fredshuc/buildfly/dampers/c06-d02/README_CN.md

# D02 风阀承重整改 · C06 / RT2 N8

**结论**　八阀的自重均有从内、外金属端法兰通往机架的承托路径。32 个接触点和四座门架的底架连接已在回读的 STEP 上核对。N8 可进入原型详设，实物反力和 2.5 mm 箱壁法兰的挠度仍待测。整机下料与双床制造继续暂缓。

风阀支承与底架连接

## 用哪份 CAD

| 用途 | 文件与操作 |
| --- | --- |
| 单独审查受力路径 | 打开 [D02_LOAD_PATH_REVIEW.step](cad/D02_LOAD_PATH_REVIEW.step)。231 个具名实体包含 149 件 D02 支承、16 个 D01 金属端框、16 个阀端垫片、8 个接框及 42 件 C06 参考结构。底板和 2.5 mm 箱壁法兰可在独立参考组中隐藏。 |
| 放入 C06 整机 | 在装配配置中抑制 [表内的 16 个旧支垫](evidence/D02_C06_PADS_TO_SUPPRESS.csv)，保留原门架腿、脚和横档。将 [D02_DAMPER_SUPPORTS.step](cad/D02_DAMPER_SUPPORTS.step) 以单位 mm、原点重合导入一次。D01 装机 STEP 继续抑制其旧 HOST 参考组。 |
| 追查单个接触点 | [承托点坐标和接触面积](evidence/D02_BEARING_POINTS.csv) 给出阀号、内外端、支座及金属端框的配对。LO / HI 对应全局 Y 小 / 大的一侧。沿 [接触表](evidence/D02_LOAD_PATH_CONTACTS.csv) 可逐项追到机架。 |

适用基线为 C06 与 D01，仓库提交 `d2c9a6839a5842f1b6ee0b1fcb67e70b25738838`。两个评审分支的 RT2 正文 Git blob 相同。此次在风阀目录下交付支承增量与壳体装配接口，机壳、换热器和水路各自保留原发布版本。[RT2 §3 N8 与 N10](https://github.com/fredshuc/buildfly/blob/claude/dampers-cad-dfm-bgxyci/AirTransformerShell/revisions/C06/RT2_REVIEW/C06_RT2_REVIEW.md) · [来源标识](source/baselines.json)

## 八阀怎样承重

原 C06 每个旧垫在外端金属法兰上的接触面积为 60 mm²，在内端为 0。D02 在每阀两道金属端法兰的下缘各设两个承托块。受力依次经承托块、横梁、左右侧梁，进入原门架和新增立柱。各阀保留 D01 的风道、1280 mm 床距和手性。

| 装配尺寸 | D02 名义值 |
| --- | --- |
| 前组承托中心 X | 箱侧 −167.6，外侧 −344.6 mm |
| 后组承托中心 X | 箱侧 917.6，外侧 1094.6 mm |
| 承托中心 Y、Z | 每床中心 Y ±300 mm。P 阀 Z 152，R 阀 Z 627 mm |
| 单点贴合 | 2 × 60 mm 凸台落在 3 mm 厚的 P101 / R101 金属下缘。每阀四点共 480 mm²，凸台至相邻密封垫名义最小间距 0.5 mm |
| 高度与定位 | 承托块肩部低于名义落座面 2 mm。凸台高度可配磨至 1.6–2.4 mm，可按实测法兰中心在块上横移加工 ±1.5 mm。最终使凸台中心相对金属中面偏差 ≤0.25 mm。超出加工余量须重定位支架。 |

**前门架。** 每座前门架增加两根 40 × 50 × 3 mm 纵向矩形管。它们从原门架腿的 X −393 面接至 C06 底架 X −129.1 面。靠箱侧的两根立柱也落在这两根拉梁上。两床共四根拉梁，把原先单独落地的前门架接回底架。

**后门架。** 箱侧新增支脚位于已有的 `R_BASE_CROSS_327` 或相邻底架侧梁上方；外侧原门架位于 `REAR_STAND_BASE_CROSS` 上方。逐脚投影核对了整段柱截面经脚板、2 mm 底板传到底架的承压面积。另以四根短拉梁接至两根后角柱之间的横管，位置在排风套筒下方。此连接可在原底板完整的条件下装入。

**接头与装配。** 接触表中带 `WELD` 的面和立柱脚是装配连接界面，名义模型用母材贴合面表示。承托块由每块两颗沉孔 M4 × 12 螺钉防脱，竖向力通过块底直接传给 20 × 32 mm 实心横梁。先在工装上完成支架与底架的焊接和焊后找正，再安装蒙皮、密封件、承托块及阀体。前侧近箱立柱须在封皮前施焊。壳体负责人需会签母材、焊缝尺寸与顺序、底架承载和吊运约束。按统一钢密度估算，换下旧垫后整机净增 **87.81 kg**。[局部梁估算](evidence/D02_MEMBER_SCREEN.json)

## 检查结果与边界

| 检查 | 结果 |
| --- | --- |
| STEP 回读 | 增量 149 件、审查装配 231 件。逐件核对名称、单实体有效性、体积及位置包围盒。 |
| 静态装机 | 用整机原点下的 7,212 个 D01 产品与接口实例、311 个保留的 C06 实体、43 个水路实体和 12 个水路检修包络检查新增件。新增件内部及对上述对象的实体干涉均为 0，体积阈值 0.001 mm³。 |
| 运动和工具 | 600 个逐件连续整周运动包络、8 个执行器预留体、8 个单盖抽出包络与新增件通过。240 个 M8 套筒路径中有 24 对包围盒与新增件相交，精确实体检查全部通过。 |
| N10 侧板 | 全部新增件位于 A、B 侧板内表面向内至少 21.6、50.0 mm，原侧板向外平移时与新增支承的距离递增。支承最高 Z 627，比建议分板线 Z 1000 低 373 mm。按原 C06 整板检修时，该床后侧 P、R 两个执行器仍须先拆，再沿驱动轴方向向外移板约 464 mm。分板与实机演练由壳体负责人闭合。 |

统一钢密度下，D01 阀体及已建模传动件的质量代理为 P 99.89 kg、R 56.00 kg。简支静力平衡给出箱侧两个点合计承担 **49.3%–50.7%** 阀重；四个点各自的反力须实测。若未来执行器的重心可能落在预留体任一角落，并要求组合重心与四点支承矩形的边保留 15 mm，以这些代理质量换算的执行器质量边界为 P 16.31 kg、R 12.61 kg。选型时须用实秤质量、实际重心和外接负载重算，必要时给执行器单设底架支承。[重心与反力计算](evidence/D02_GRAVITY_SCREEN.json)

另做了每根梁施加 1 kN 的简支弹性估算，取钢材弹性模量 200 GPa。将载荷移至 60 mm 凸台的最内缘，横梁承托区挠度上界约 0.178 mm/kN，前、后侧梁跨内上界约 0.041、0.095 mm/kN。该计算只覆盖单根梁。2.5 mm 箱壁法兰的实际位移、焊接接头刚度、薄边局部压屈及热态配合都要在实物上核实。[几何结果](evidence/D02_GEOMETRY_RESULT.json) · [干涉记录](evidence/D02_CLASH_CHECKS.json)

## N8 实物验收

1. 独立称量每台阀连同实际执行器和随阀附件，记录重心。断开外风管、线缆牵引及试验软连接的附加载荷。安装时用外部吊具控载，让四块承托先贴住金属下缘。定位后逐点做着色转印、量凸台偏移，确认垫片与托块有间隙、焊钉在 Ø9 孔内有径向余量。
2. 在每根横梁两端各布置一条应变测量通道。合盖前在实际工装上分别加载两处承托点，并用组合载荷核对两通道解出的两点反力。也可使用校准且保持装配高度的测力承托块。百分表固定在独立刚性基准上，分别读 2.5 mm 法兰四角的 Z 位移和 X 向面外位移，仪表分辨率 0.01 mm。
3. 分三步记录。① 密封螺母松弛、吊具卸载，确认四点反力；② 按批准工艺紧固气密接头，复测；③ 保持同一预紧力，以测力吊具回提约 10% 实秤重量并复位，保持四点接触，复测力与位移。这样可以区分密封预紧自身引起的面外变形和重力变化引起的法兰挠度。
4. **提议的原型判据，待试验负责人认可。** 在①、②两态，各点反力均应超过测量不确定度，反力合计与实秤重量相差 ≤5%。在③的控载步，反力合计变化应与吊具增载在测量不确定度内一致；相同预紧下法兰任一测点的位移变化 ≤0.10 mm，卸载后复位。记录仪器、温度、实际扭矩和原始数据，异常时重新配高、找正并重测。[空白试验记录](evidence/D02_N8_FIELD_RECORD.csv)

**待关闭项。** N8 的几何证据已提交，载荷、法兰挠度、焊接和底架锚固仍待实证。床 B 镜像手性、实选执行器和输出连接、G843 夹紧与预载，以及 R21 阀内膜片和转子约束继续沿用 D01 门槛。整机下料、双床制造与单床冷流开试由各自评审门槛决定。

## 复现

把两份上游包分别解到仓库的 `dampers/c04-d01/` 和 `AirTransformerShell/revisions/C06/`，把上游 ZIP 原件也留在对应目录。将本包解至 `dampers/c06-d02/`。运行 `run.ps1`，或在可导入 CadQuery 2.8.0、OCP 7.9.3、NumPy 和 Matplotlib 的 Python 环境中依次执行 `source/verify_fit.py`、`source/detail.py`、`source/package.py`。每次核对上游 ZIP 的 Git blob 和所用输入的 SHA-256。首次解析 STEP 会产生可丢弃的本地缓存。[D01 原始包](https://github.com/fredshuc/buildfly/blob/d2c9a6839a5842f1b6ee0b1fcb67e70b25738838/dampers/c04-d01/D01_CAD_REVIEW_PACKAGE.zip) · [C06 原始包](https://github.com/fredshuc/buildfly/blob/d2c9a6839a5842f1b6ee0b1fcb67e70b25738838/AirTransformerShell/revisions/C06/C06_CAD_REVIEW_PACKAGE.zip)
