fredshuc/buildfly/dampers/c04-d01/README_CN.md

# L2-MI dampers2｜C04 风阀 D01 几何整改候选

日期：2026-11-05。状态：**PASS_INTERFACE_GEOMETRY；不作为制造放行或试验运行许可。**

布置与检修包络

本版保留 R21 的阀芯、180 mm 阀体深度、P 630×345 / R 630×180 净口及原 706 mm 法兰孔阵列。原 C04、R21 文件未改写。
主要调整是装机手性、真实驱动占位和外接紧固。每个接口增加33 mm金属接框及2 mm主垫，使风阀移出35 mm；接框的局部让位槽避开反馈支脚，未削减阀芯和反馈零件。后侧四根套管按真实两端垫及接框相应缩短39 mm。
旧C02 R100S的R112/R113共四个20 mm抬高段源实例，由新密封接框替代，不再叠加装入本机；[替换记录](evidence/D01_RETIRED_MACHINE_INTERFACES.json)保留来源。未撤销旧批次或指示报废库存。
为得到可检查的双床候选，提出 **1280 mm 床距**（原840增加440）；这是一项提交给 shell2 的接口要求，尚未纳入其正式壳体版本。
床A保持原位，床B整体沿+Y移440 mm。参考主壳体Y范围由−852…+852改为−852…+1292 mm，宽2144 mm，驱动及执行器外伸另计。明确的壳体接入项见 [接口请求表](tables/D01_HOST_INTERFACE_REQUEST.csv)。
床 B 使用标识为 D01_MH 的真正镜像派生几何，不能拿原件旋转180°替代。左右手间重力及气流/压差方向相同；新右手件的制造和性能资格仍待建立。

## CAD 与可编辑数据

- [八阀装机 STEP](cad/D01_EIGHT_DAMPERS_INSTALLED.step)：原生风阀组件、候选加宽参考壳体、实际驱动及新焊钉；所有八个位置均有独立名称。
- [床 A 风阀接口 STEP](cad/D01_BED_A_DAMPER_INTERFACES.step)：四只原手性阀，不含床 B 派生件；**没有独立支架，不是可直接建造的冷流试验总装**。
- [连续运动/执行器/反馈拆卸空间 STEP](cad/D01_SERVICE_ENVELOPES.step)：参考空间，不是实物和采购件。
- [装配变换](native/D01_PLACEMENTS.json)、[侧板开孔](native/D01_PANEL_CUTOUTS.json)、[参数](design.json)、[重建代码](source/build.py)。修改参数后重建，不从截图量尺寸。
- `native/*_D01_ADAPTER.brep`使用装机全局坐标；加工须另建基准、出让位口袋图并审批，不能直接把文件原点当作下料零点。
- [法兰与焊钉接口图](drawings/D01_FLANGE_STUD_INTERFACE.svg)、[逐孔坐标](tables/D01_M8_STUD_COORDINATES.csv)、[整改闭环表](tables/D01_REVIEW_CLOSEOUT.csv)。

## 几何核查范围

1. 在原840 mm床距上，以真实零件再次得到四组同层 A/B 硬干涉，前后 P/R 均有失败记录；没有把空的占位块检查当作通过。
2. 候选八阀的28种两两组合，逐件连续运动包络互不相交。以源件包围盒绕实际轴的最大角点半径建立全360°外包络，因此包含0–90°的所有中间角度；该证明只针对外部接口，不证明原阀内部运动合格。
3. 与候选参考壳体的静态实体干涉、连续运动外包络干涉、新接框/焊钉/垫片实体、Ø20×25短套筒沿Z侧向50 mm进入（顶/底排从边外，侧排沿法兰边从内侧；含Ø22×10棘轮头及100 mm沿边手柄）、单只反馈盖沿轴100 mm拔出及执行器选型空间分别检查，原始结果见 [D01_INTERFACE_CHECKS.json](evidence/D01_INTERFACE_CHECKS.json)。反馈盖不得同时向中间拔出。工具尺寸是选型限界，需要实物工具及人手试装；不是供应商供货声明。
4. 当前参考 CAD 通过不代表原 C04 整机通过。加宽后的框架只是接口参照；支撑、刚度、密封、排水、水路和风道流场均未在本版关闭。
5. STEP独立重新导入：D01_EIGHT_DAMPERS_INSTALLED.step = 7380 个有效实体; D01_BED_A_DAMPER_INTERFACES.step = 3679 个有效实体。未运行CFD、FE或任何物理试验。

新增接口的连续运动复核另由导出AP242重新读取全部976个新接口实例，逐件对照运动包络；B200在两条净口边沿轴向分段，避免把阀叶弦长错误地延伸到外侧细轴段。[独立复核结果](evidence/D01_NEW_INTERFACES_CONTINUOUS_MOTION.json)只证明外部连续几何间隙，不替代载荷、捕获、密封或内部接触验证。

## 组件归属与紧固修改

R21是含试验设施的冷装配，不是纯产品装配。本版排除源标识的试验台、仪表、原接收框，并用1 mm实体距离、四轮连接传播识别随产品的通用紧固件；其余未能关联的硬件不计入装机，共排除713条源记录。
这是**几何集成范围推断，不是制造BOM或采购数量依据**；每个源 occurrence 的取舍及关联父件均在 [组件范围表](evidence/R21_COMPONENT_SCOPE.json)。采购图和正式装配分配仍需归属负责人确认。
源外接螺栓/螺母/垫圈共304条记录改由新接口定义，[替换清单](evidence/OUTER_FLANGE_HARDWARE_REPLACEMENTS.json)逐件可查。
其中含R阀五处改过料号的HW_R12_M8X40；这些孔位改用新焊钉后，G843的新夹紧、支承及预紧链仍须单独详设。本版只保留其空间实体，不把它记作已完成的反馈承重连接。

本版八阀到壳体接口共240根M8焊钉。有效外露55 mm，穿过主垫2、金属接框33、阀垫2、阀法兰3、垫圈1.6及螺母6.5，名义螺纹外露6.9 mm；实际有效牙长及端倒角需实物检查。新主垫逐孔设2 mm金属压缩限位；源阀垫原有限位保留。让位槽未侵入两端面距净口20 mm的原密封带（原螺栓孔及压缩限位不变），内侧气路边壁保持至少2 mm，实际值见 [接框让位](native/D01_ADAPTER_POCKETS.json)。G843仍是原版暂缓件，仅保留其实体占位，不取得承重资格。接框仅定义气密安装接口，不承担未验证的整阀重量。
R21 R阀原来只有一端外接垫，本版复制同一R106压缩态轮廓用于第二端面，标识D01_R106_SECOND_FACE；软料自由厚度及压缩限位沿用来源要求，不能按压缩态CAD直接切自由料。
薄2.5 mm母板上的焊钉必须做焊接试片及焊后平面度/夹紧压缩检查。外接风管另一端的紧固及支承另行定义；本表不是全机紧固件总量。

## 仍须闭合的条件

- shell2确认1280 mm接口；840 mm不能靠左右旋转或交换端头通过。本版没有擅自覆盖C04。
- D01_MH右手件需单独出图及冷热/湿态/压差密封、反馈、驱动和购件安装确认；R21原签发页不能自动覆盖镜像件。
- 左右手的编码器零点、反馈正方向和开关限位分别标定，不能直接复制控制极性。G843及其五处夹紧的承载定义继续HOLD。
- 实选执行器、输入适配器、动态扭矩限制和拆卸服务空间仍待确认；250 mm方盒只是明确的选型限界。
- 每只风阀及选通箱需独立支架。**不能把阀重交给2.5 mm法兰。** S1承重链、原R21膜片/捕获/柔度问题继续HOLD。
- 红队其余 S2–S8、W1–W5、A1–A3 仍由相应负责人处理；冷流C1–C8尚未全部实现。再生模式优先试验，沿用红队G0/G1门槛。
- [先关后开状态表](tables/D01_BREAK_BEFORE_MAKE.csv)已写；执行器实测行程时间、失效位、PLC实现、独立位置确认和水路联锁尚待集成。

## 复现

Python3.12 + CadQuery2.8.0 / OCP7.9.3.1.1、NumPy2.3.5、SciPy1.18.1、Matplotlib。本机可运行 `run.ps1`；其他环境安装依赖后依次运行 `source/build.py`、`source/check_motion_interfaces.py`、`source/verify.py`、`source/document.py`，最后运行 `source/verify.py --package`（均使用 `python -X utf8`）。
`inputs/C04_R21_BASELINES.zip`含21份未改动基线。重建只向本版`.work/`及输出目录写入，不运行旧版制造/打包脚本，不覆盖源交付。
`inputs/BASELINE_MANIFEST.json`逐件记录来源路径和SHA256；源审查来自 fredshuc/buildfly 的 claude/jolly-hopper-mndk80 分支，审查基线cb6c2b5，完整审查随包保留。
