fredshuc/buildfly/AirTransformerShell/references/four-core-outdoor/README.md

# Four-core outdoor sheet-metal reference

Use this historical AP242 export to compare the four-core outdoor enclosure, panels, ducts, dampers, HX masks and sheet supports with the two-core design. The source package records its status as `PARTIAL_WITH_VALID_STEP / NOT_FOR_MANUFACTURE`. Keep the two-core C07 acceptance criteria separate.

Original file: `V050_SM_M2_IN1_R1_OUTDOOR_SHEET_METAL_ONLY.stp` (26,113,041 bytes). SHA-256: `d20fbdc7a29cf05dad60b861e0eac5a06509d531450b63370dea08928586f6ae`.

Export date: 2026-10-08. Parent: `V050_SM_M2_IN1_R1_SOR_CANDIDATE.step` (SHA-256 `1876d5f244933f145d9a5f1e9adaafca5ed9a168663eca60e45121cb4b0fc53a`). The original exporter's readback recorded 521 occurrences in 11 groups, an exact occurrence-name match and a maximum bounding-box discrepancy of 0.000286 mm. The export excludes HX cores, water routing, insulation, gaskets, electrical hardware and fasteners.
