fredshuc/buildfly/mat-prod/RED_TEAM_REVIEW_EN.md

# MAT61 Red Team Review Brief

7 November 2026  
HORIZON-CL4-2027-01-MAT-PROD-61  
Working draft for red-team review

Please review Sections 1–3 as one Part B proposal. Read S1 for the scientific claim and proof strategy, S2 for the pathway from results to impact, and S3 for work, resources and partner responsibilities. Use the Word files for comments and the Markdown sources for precise change references.

| Section | Editable Word | Markdown source |
| --- | --- | --- | --- |
| S1 Excellence | [Word](01_proposal/Section1_Excellence_Science_Longform_EN.docx) | [Markdown](01_proposal/Section1_Excellence_Science_Longform_EN.md) |
| S2 Impact | [Word](01_proposal/Section2_Impact_EN.docx) | [Markdown](01_proposal/Section2_Impact_EN.md) |
| S3 Implementation | [Word](01_proposal/Section3_Implementation_EN.docx) | [Markdown](01_proposal/Section3_Implementation_EN.md) |

Supporting files include the [resource workbook](03_budget/Implementation_Resources.xlsx), [validation protocol](04_evidence/Validation_Protocol_Design_EN.md), [planned validation matrix](03_budget/CSV/Validation_Matrix.csv) and [S3 task list](03_budget/CSV/Tasks.csv).

## Questions for reviewers

1. **Excellence and novelty.** Is the breakthrough sufficiently specific against the materials, shaped-adsorber and mechanically assisted heat-transformer literature? Check whether the design separates material, shaping, transport, pressure assistance and control effects. Inspect the matched-service, full-reset and independent-block evidence and the incremental claim for constrained RL against tuned MPC.
2. **Impact and topic fit.** Does the proposal connect the physical materials and manufacturing results to specific IAM4EU objectives, an industrial uptake path and credible TRL 4 outputs? Check that the energy figures are scenario context and that the project-level claims match the evidence.
3. **Implementation and integration.** Are the activities, facilities, staff, budget and schedule sufficient for the work and independent validation proposed? Trace each material and control claim to a task, a deliverable and an acceptance condition. Check production ownership, manufacturing release, metering and recovery capacity.
4. **Cross-section consistency.** Check the five-party consortium, 36 months, Savery’s single nominal 5 kg synthesis line and the single nominal 10 kW laboratory module. The 45 °C source and 70 °C delivery are an application example. The laboratory design point uses a 55 °C source, 25 °C rejection and 65→70 °C useful water. The 144 prospective histories are planned and are nested within three independent build blocks.
5. **Editorial and evidence gaps.** Flag any unsupported performance, novelty or readiness claim. S1 is the scientific longform and will need a separate page-limit pass. The S3 T7.2 production-inventory sentence is a known carryover. The proposed correction assigns synthesis and production records to Savery, forming records to IKTS, and independent materials characterisation and ageing evidence to IRCELYON.

Please log one finding per item, with **severity**, **section and locator**, **evidence**, **consequence** and **proposed change**. Use **Blocker** for an issue that prevents submission or invalidates a central claim, **Major** for an issue requiring substantive correction and **Minor** for a local clarification. End with an overall review disposition and the three changes that would most improve the submission.
