fredshuc/buildfly/mat-prod/04_evidence/Source_and_Reuse_Log.md

# Source and reuse log

Task MAT61-L2-S3-T01-R1, read and prepared on 6 November 2026. This log describes actual access, not inferred possession of a document. It is a controlled internal record.

## Reading grades

A: original file or authoritative decision document, with relevant content read. A-scoped: official primary source, specified sections read. B: scientific extract/readback rather than the complete final original. C: reconstruction or continuity summary. U: direct current user instruction. A decision document proves the decision it records; it does not turn an inaccessible underlying proposal into a fully read original.

| ID | Source and actual version | Access and grade | Reuse and boundary |
| --- | --- | --- | --- |
| U1 | Current L1 brief MAT61-L2-S3-T01-R1, 2026-11-06 | Current message, full, U | Five participants, whole scientific chain, seven-WP start, 36-month choice, EUR2.40m target/EUR2.50m ceiling, permissions and deliverables. |
| U2 | User amendment during execution | Current message, U | Single Module uses 10 kW because 1 kW mechanical components are unsuitable. Re-sized inventory, flow, production, equipment and budget; no earlier sub-kW recommendation survives. |
| U3 | User confirms Git connection and authorises repository operations | Current message, U | Repository writes/push authorised within original confidentiality restrictions. No permission inferred to publish unpublished IP or private sources. |
| S1 | User-provided Tpl_Application Form (Part B) (HE RIA and IA).rtf | Original local bytes, A; V5.1 dated 22 January 2026 | Full text extracted using Pandoc; headings and fields 3.1a-h, equipment threshold, body/table minimum 11 pt, A4 and margins checked. Original kept unmodified. Authenticated call-session form and tags not accessed. |
| S2 | EC WP 2026–2027 Part 7, C(2026) 6687/2 of 29 September 2026 | A-scoped, call overview p21 and MAT61 pp74–75 | Contribution up to EUR2.50m, maximum six independent eligible entities, up to TRL4 and SRIA contribution. No topic-specific mandatory 36-month duration or lump-sum exception claimed. |
| S3 | IAM4EU SRIA, November 2024 | A-scoped, P#11/#12/#14, printed pp47–49, and context | Maps traceability, predictive material performance and sustainability to real tasks; does not claim that the project covers all partnership priorities. |
| S4 | EC WP General Annexes A and G, 2026–2027 | A-scoped | Submission-session form priority; 40-page general full-RIA limit absent an override; actual-cost RIA planning basis, 100% and 25% with exclusions. Portal/Part A must still be checked. |
| H1 | ERC_COG_2026_B1.pdf, 10 pages | Library original parsed in full, A; libfile_48db1699ea748191bd95aadb902a466b | Material energetics, mixed-linker/mixed-metal levers, reproducible production, three shaping classes, coupled transport/cycle/control and trajectory losses. Two main shaping routes funded here; third coating class remains a diagnostic reference. Original targets are not achieved results. |
| H2 | HESTIA_ESR_2026.pdf, five-page available extract | Library original parsed in full, A; libfile_2393d9a6bd1081919a6583b41a800486 | Addresses unclear breakthrough attribution, data demand and critical synthesis role through discriminating experiments, explicit workload and real capacity gaps. No copied claims of achievement. |
| G1 | Pasted markdown(1).md, 508 parsed lines | Full available scientific extract, B; libfile_b17bd6def43481918c0f8a427266b63a | GRACE sections 1.2/1.3 describe vapour transport, branch compression, bypass comparisons, H1–H3, state estimation and RL. Not the complete signed/submitted GRACE Part B; version identity not independently established. |
| G2 | 101351924_GRACE_ESR.pdf, seven available PDF pages | Library original parsed in full, A; libfile_7862a638a4cc8191a16c3b97289442a9 | Explicitly fixes evaluator criticism of sequential implementation and insufficient buffers; retains physical/digital coupling and adds economic/resource risks. ESR evaluates that proposal, not this new consortium. |
| G3 | 01_GRACE_ENPULSE_PRECURSOR_EVIDENCE.md, 867 lines | Entire file read in two windows, C; libfile_10d01ff910a8819182d3c0457fe4e5f7 | Useful hidden-state, intervention and data-provenance synthesis. Its own warning says official source proposals were unavailable to its author; never used as proof of measured GRACE results. |
| F1 | DOE27_T04_ACCEPT_WITH_ACTIONS_T05_T06_R1_20261014.zip | Original ZIP downloaded, extracted and relevant L1 review/source log read, A decision; libfile_218dc1e0fbd08191ada01f8739cac6f4 | Fair M0/Mc/Mz observation mappings; local chemical work versus adsorption heat/whole-system exergy; timing/temperature sensitivity and receiver/reset boundary. Underlying T04 L2 original not reconstructed as read. |
| F2 | DOE27_T07_ACCEPT_WITH_ACTIONS_T09_R1_20261014.zip | Original ZIP and complete included English science readback read, A decision / B science; libfile_5429aa3e3b4481919b28df3818673e11 | Competing transport/population/internal-state models, same-state opposite-history tests, fixed mappings, complete-history holdouts and independent resets. T07 text is not labelled latest final science. |
| F3 | DOE27_T10B_ACCEPT_T11_INPUT_GATED_20261018.zip | Original acceptance ZIP and full L1 final review read, A decision; libfile_4c167c4a4ad88191ae645d2fd59c85ae | Confirms science acceptance and its boundaries; preserves distinction between support for an extra state and frozen-parameter transfer. Accepted scientific DOCX/PDF are not present in this review ZIP. |
| F4 | DOE27_R10prime_L1_FINAL_SUBMISSION_AUDIT_20261029.zip | Latest accessible original audit ZIP and full L1 audit read, A decision; libfile_a53d66c7ab0481919b19a913839d6fba | Later material-selection rule: thermodynamic/measurement qualification before dynamic model selection, then freeze with declared calibration and unseen challenges. Latest R10prime science main file itself was not obtained. Do not retain T07's single-material restriction as current MAT61 scope. |
| S5 | IRCELYON ATARI and chemical/textural facility pages | Official pages opened and relevant sections read, A-scoped | Supports calorimetry/material characterisation; not named synthesis personnel, Savery production throughput, booked access or project cost. |
| S6 | Fraunhofer IKTS Shaping of MOFs page | Official page opened and relevant section read, A-scoped | Direct MOF shaping capabilities, including granulation/extrusion/monoliths. No project booking or guarantee of retained uptake. |
| S7 | UPorto LSRE-LCM Cyclic Adsorption Processes | Official page opened, A-scoped | Modelling, simulation, optimisation and control background, not this project's named team or reserved effort. |
| S8 | HPE Galway R&D announcement dated 2 October 2023 | Official page opened, A-scoped | Establishes historical Galway R&D presence, not project-specific RL staffing, a data-centre demo or free compute. |
| S9 | NIST Chemistry WebBook water Antoine coefficients, 304–333 K | Primary NIST source retrieved, A-scoped | A=5.20389, B=1733.926, C=-39.485 with P in bar and T in K; combined with ideal-gas water-vapour density for approximate design-flow verification, not a compressor performance map. |

## Source access limitations and unsuccessful routes

The authorised desktop inventory showed DESKTOP-39O8NE4 offline. The Windows paths recorded in DOE audit files therefore do not establish that this session read the latest scientific main file. Library title/content searches resolved the above materials; no complete final GRACE Part B was found. Patent drafts returned by search were not opened or copied into this work.

The CNRS-hosted Auroux CV URL returned 404 on direct open, and the FEUP thesis record returned 403. Neither failed fetch is used as the sole final evidence. The final document uses the accessible IRCELYON institutional pages and LSRE-LCM page. An ALiCE page timed out; it is not needed for the final factual claim. Public institutional capability never substitutes for a project access agreement.

## URLs

S2 https://ec.europa.eu/info/funding-tenders/opportunities/docs/2021-2027/horizon/wp-call/2026-2027/wp-7-digital-industry-and-space_horizon-2026-2027_en.pdf

S3 https://www.iam-i.eu/wp-content/uploads/2025/02/SRIA-Innovative-Advanced-Materials-for-Europe.pdf

S4 https://ec.europa.eu/info/funding-tenders/opportunities/docs/2021-2027/horizon/wp-call/2026-2027/wp-15-general-annexes_horizon-2026-2027_en.pdf

S5 https://www.ircelyon.univ-lyon1.fr/team/atari/ and https://www.ircelyon.univ-lyon1.fr/facility/analyse-chimique-texture/

S6 https://www.ikts.fraunhofer.de/en/departments/structural_ceramics/processes_and_components/shaping/cr_shaping_of_MOFS.html

S7 https://lsre-lcm.fe.up.pt/areas/1

S8 https://www.hpe.com/us/en/newsroom/press-release/2023/10/hewlett-packard-enterprise-creates-more-than-150-roles-at-new-cloud-rd-center-in-galway-ireland.html

S9 https://webbook.nist.gov/cgi/cbook.cgi?ID=C7732185&Mask=20D

## Reuse decisions

Adopt the provided official table schema, standard mass/energy balances, reference water-stable MOFs and existing low-temperature shaping knowledge. Wrap measured actuator and sensor behaviour in a common simulator and HIL interface. Build the discriminating experiment, inter-partner data contract and common resource ledger specific to this project. Do not copy another action's WP budget, TRL result, apparatus dimensions, personnel salary or access entitlement.

HESTIA's proposed efficiency targets and GRACE's first-of-kind/pilot claims are not imported as achieved results or novelty proof. DOE's local chemical-work argument is not promoted to whole-machine savings; later qualification/freeze rules take precedence over the older readback. The user fixed the current scientific chain and five-participant scope; no earlier alternative consortium is revived.

The original template SHA-256 is 507cc6ad2831936b3b41e2bed6ec784cb1c50ba61b1e8dd80590639565575977. The original uploaded archive SHA-256 is e38469b3b65ffa8625b31c150f8acfe650dbdbaf5f7738d2d708d7541e849281. Parsed temporary source extracts remain outside the repository. No private payroll, unpublished formula or patent body is embedded in the public index.
