fredshuc/buildfly/mat-prod/05_reviews/L2_Return_CN.md

# L2 回件 · R2 · 2026-11-06

Savery 负责探索、确认、工艺及正式生产的全部合成，使用一条 5 kg 生产线。IRCELYON 牵头 WP2 科学工作，负责组成／物相、吸附、量热和老化测量。Savery 牵头 T2.3 与 D2.2；IKTS 接收 Savery 粉体及 IRCELYON 的同批表征记录。

按每批 5 kg 合格干粉、32 h 完整周转、M13–M23 每月可用 180 h 设计。最终生产 36 批、180 kg，六个独立 30 kg 组各领六个整批。正式生产预计 1,152 h，窗口 1,980 h，余 828 h。早期 57 批、6.12 kg、612 h 单列；如占用同一窗口须扣除。三组双路线 A/B/C 分别按 M19、M21、M23 放行。M12 按实收量、清洗周转、可用日历及批次合格率重算。干粉实收降至 4 kg 时，每组需八批，共 48 批、1,536 h（32 h/批）。

L2 暂拟将 WP2 的 12 PM 和合成耗材／产线设备使用费从 IRCELYON 转给 Savery。Savery 为 78 PM、€972,225；IRCELYON 为 36 PM、€337,500。项目总额 €2,487,225、224 PM。成本分配为方案假设，须以伙伴实际投入和设备账核实。独立矩阵仍为 144 次计划运行。

英文 Section 3、9 表工作簿、任务／里程碑／接口／风险、人员及预算明细、能力表和验收记录已同步。148 项设计／文件检查通过。Word 渲染 22 页。待 L1 审阅。

受控分支 mat-prod/l2-s3-t01-r1；R2 的提交号和恢复命令见交接压缩包的 HANDOVER.md。远端 fredshuc/buildfly 为公开仓库；建立仅含公开索引的分支请求收到 403。完整提交通过私有 Git bundle 交接。
