fredshuc/buildfly/AirTransformerShell/NEXT_HX_INTERFACE_CN.md

# 下一版 HX 接口调整｜2026-11-05

状态：接口方向已提出；本次Git归档不修改C02实体。L2-B HX负责HX端接，shell2在收到新版接口后更新壳体。

1. 两个对外水口沿迎风面横向Y分开，同高度、均朝+X；优先评估约150 mm中距。
2. 150 mm是候选布局尺寸。按Ø35管及径向25 mm保温，几何净间隙约65 mm；需以实际活接、工具和保温包络复核。
3. 保留39路并联、每路六程及同侧双集管，优先调整端部接管。不得将集管移至相对两侧而未重新证明内部水路。
4. 两芯使用同一供货件、同向安装。下一版壳体取消C02为避让设置的120 mm高度错层、B芯180°旋转和W1/W2互换。
5. 四只三通阀的切换架构保留；外部管段和孔位跟随新接口调整。
6. L2-B返回新版STEP、端口坐标/方向表、顶部俯视图、水路连通检查；分列接管外伸和服务空间。
7. 总体高度还需满足阀执行器拔出空间。新版CAD完成前，不把候选中距或降高量标为已验证尺寸。
