fredshuc/buildfly/mat-prod/05_reviews/Accepted_Task_and_10kW_Amendment_CN.md

# 已领取任务与规模修正

2026年11月6日领取MAT61-L2-S3-T01-R1，完成Section 3.1/3.2、官方适用表、任务、人员月、预算、甘特及依赖、源记录、QA和集中回件。固定Savery、IRCELYON、Fraunhofer IKTS、UPorto、HPE Galway，36个月工作假设，规划上限€2.50m。完整科学链、TRL4实验室边界及保密/权限限制沿用用户本轮任务书。

执行期间用户追加：单Module以10 kW为基准，1 kW找不到对应机械组件。该指令已成为最终硬件与热服务基准，旧小功率草算撤销。随后用户确认Git连接应恢复并授权操作repo。该授权适用于任务内的仓库读写及安全推送，不取消不公开未发布知识产权、私人工资或伙伴商业数据的限制。

本次修订由用户指定Savery负责全部合成、使用一条5 kg合成线。

输出以同一mat-prod受控根目录为准，不增第六方，不外发邮件、不采购付费、不预订、不作伙伴承诺、不提交Portal。
