fredshuc/buildfly/mat-prod/01_proposal/Schedule_and_Dependencies/Task_Gantt.png

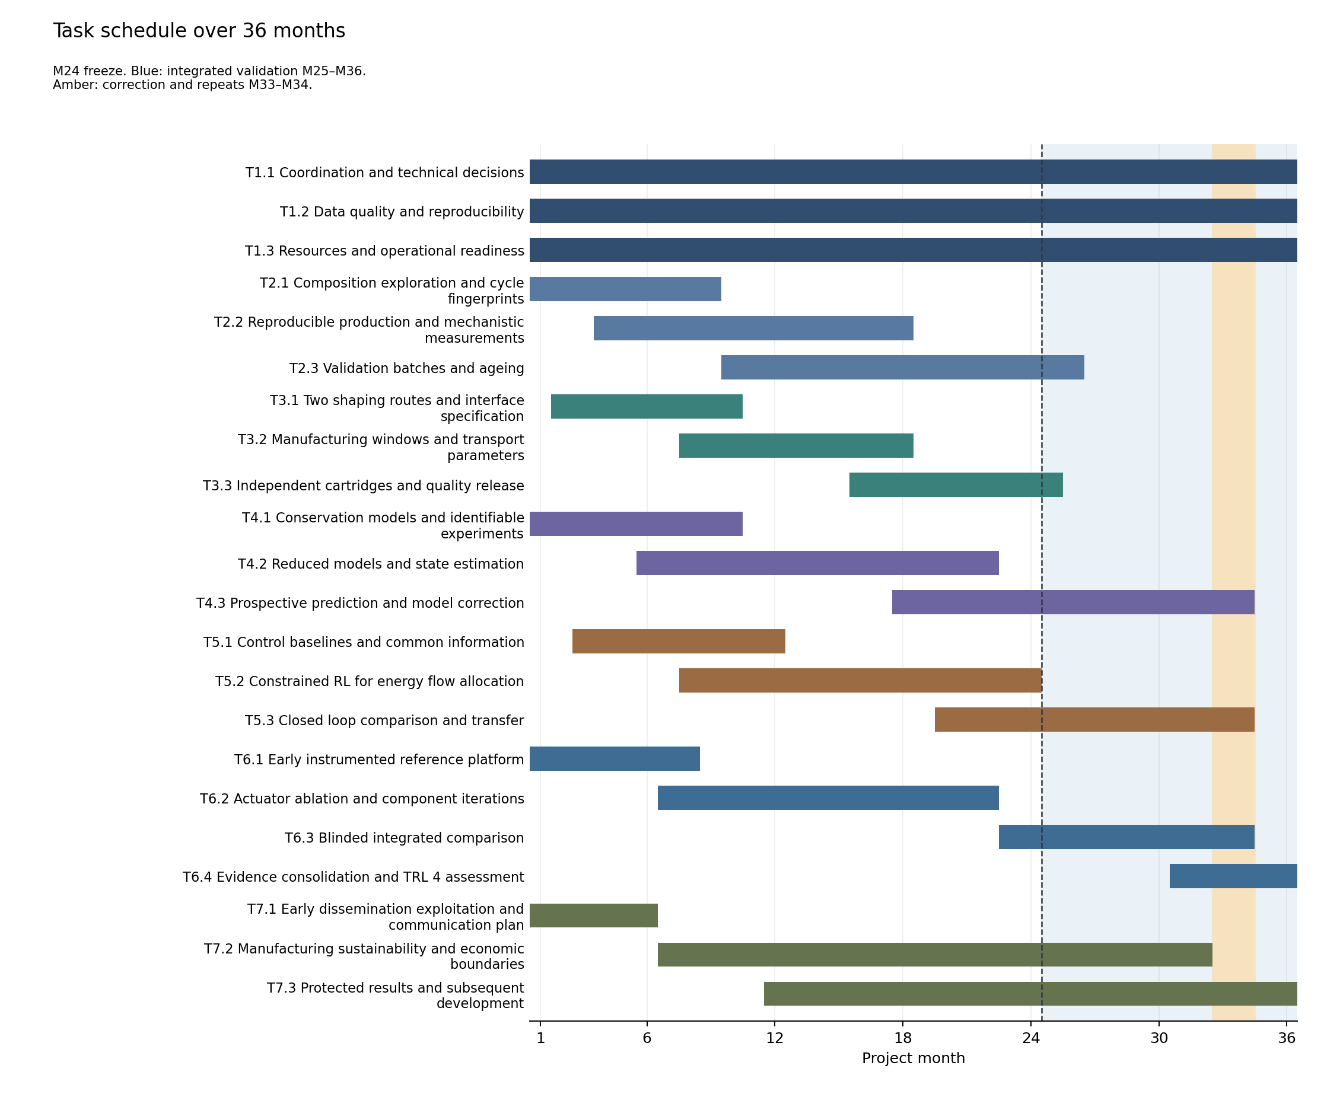
mat-prod/01_proposal/Schedule_and_Dependencies/Task_Gantt.png
