fredshuc/buildfly/dampers/c02-r11-dfm/results/results_bom_routing.csv

pn | name | material | route | instances | status | revision | tight_tol_tokens | weld_note
P101 | P端法兰 | EN 1.4307 / 304L | SHEET (laser + deburr, some bend/weld) | 2 | INHERITED_C02_HOLD | C02 |  | True
P102 | P中分法兰分片套件 | EN 1.4307 / 304L | KIT/REFERENCE | 2 | INHERITED_C02_HOLD | C02 |  | True
P103F | P半壳侧板-F | EN 1.4307 / 304L | SHEET (laser + deburr, some bend/weld) | 2 | INHERITED_C02_HOLD | C02 |  | True
P103B | P半壳侧板-B | EN 1.4307 / 304L | SHEET (laser + deburr, some bend/weld) | 2 | INHERITED_C02_HOLD | C02 |  | True
P104 | P半壳端壁 | EN 1.4307 / 304L | SHEET (laser + deburr, some bend/weld) | 4 | INHERITED_C02_HOLD | C02 |  | True
P105 | P中分静密封分片套件 | Rogers BISCO HT-870 3.18 mm | KIT/REFERENCE | 1 | INHERITED_C02_HOLD | C02 |  | False
P106 | P外接静垫 | Rogers BISCO HT-870 3.18 mm | SEAL/GASKET/INSULATION (die/waterjet/skive) | 2 | INHERITED_C02_HOLD | C02 | ±0.03 | False
P107 | P局部接收框 | EN 1.4307 / 304L | MILLED/PRISMATIC (plate or bar) | 1 | INHERITED_C02_HOLD | C02 |  | False
P108 | P侧密封泡棉 | Rogers BISCO HT-870 6.35 mm | SEAL/GASKET/INSULATION (die/waterjet/skive) | 4 | INHERITED_C02_HOLD | C02 |  | False
P109 | P侧密封滑动面 | Virgin PTFE skived sheet, 0.25±0.03 mm | SEAL/GASKET/INSULATION (die/waterjet/skive) | 4 | INHERITED_C02_HOLD | C02 |  | False
P111 | P侧封背垫 | 304L precision shim | KIT/REFERENCE | 4 | INHERITED_C02_HOLD | C02 |  | False
P110 | P侧封U压框 | EN 1.4307 / 304L | SHEET (laser + deburr, some bend/weld) | 4 | INHERITED_C02_HOLD | C02 |  | False
R101 | R端法兰 | EN 1.4307 / 304L | SHEET (laser + deburr, some bend/weld) | 2 | INHERITED_C02_HOLD | C02 |  | True
R102 | R中分法兰分片套件 | EN 1.4307 / 304L | KIT/REFERENCE | 2 | INHERITED_C02_HOLD | C02 |  | True
R103F | R半壳侧板-F | EN 1.4307 / 304L | SHEET (laser + deburr, some bend/weld) | 2 | INHERITED_C02_HOLD | C02 |  | True
R103B | R半壳侧板-B | EN 1.4307 / 304L | SHEET (laser + deburr, some bend/weld) | 2 | INHERITED_C02_HOLD | C02 |  | True
R104 | R半壳端壁 | EN 1.4307 / 304L | SHEET (laser + deburr, some bend/weld) | 4 | INHERITED_C02_HOLD | C02 |  | True
R105 | R中分静密封分片套件 | Rogers BISCO HT-870 3.18 mm | KIT/REFERENCE | 1 | INHERITED_C02_HOLD | C02 |  | False
R106 | R外接静垫 | Rogers BISCO HT-870 3.18 mm | SEAL/GASKET/INSULATION (die/waterjet/skive) | 1 | INHERITED_C02_HOLD | C02 | ±0.03 | False
R107 | R局部接收框 | EN 1.4307 / 304L | SHEET (laser + deburr, some bend/weld) | 1 | INHERITED_C02_HOLD | C02 |  | False
R108 | R侧密封泡棉 | Rogers BISCO HT-870 6.35 mm | SEAL/GASKET/INSULATION (die/waterjet/skive) | 4 | INHERITED_C02_HOLD | C02 |  | False
R109 | R侧密封滑动面 | Virgin PTFE skived sheet, 0.25±0.03 mm | SEAL/GASKET/INSULATION (die/waterjet/skive) | 4 | INHERITED_C02_HOLD | C02 |  | False
R111 | R侧封背垫 | 304L precision shim | KIT/REFERENCE | 4 | INHERITED_C02_HOLD | C02 |  | False
R110 | R侧封U压框 | EN 1.4307 / 304L | SHEET (laser + deburr, some bend/weld) | 4 | INHERITED_C02_HOLD | C02 |  | False
R112 | R抬高段长边 | EN 1.4307 / 304L | MILLED/PRISMATIC (plate or bar) | 2 | INHERITED_C02_HOLD | C02 |  | True
R113 | R抬高段端边 | EN 1.4307 / 304L | MILLED/PRISMATIC (plate or bar) | 2 | INHERITED_C02_HOLD | C02 |  | True
B201 | 半叶片下料 | EN 1.4307 / 304L | SHEET (laser + deburr, some bend/weld) | 0 | INHERITED_C02_HOLD | C02 |  | True
B202 | 转子轴 | EN 1.4307 / 304L | TURNED | 0 | INHERITED_C02_HOLD | C02-R6 |  | True
B200 | 叶片轴焊接总成 | EN 1.4307 / 304L | WELDMENT | 3 | INHERITED_C02_HOLD | C02-R6 |  | True
S301A | 密封座梁-A | EN 1.4307 / 304L | MILLED/PRISMATIC (plate or bar) | 3 | INHERITED_C02_HOLD | C02 |  | False
S301B | 密封座梁-B | EN 1.4307 / 304L | MILLED/PRISMATIC (plate or bar) | 1 | INHERITED_C02_HOLD | C02 |  | False
S301C | 密封座梁-C | EN 1.4307 / 304L | MILLED/PRISMATIC (plate or bar) | 1 | INHERITED_C02_HOLD | C02 |  | False
S302 | 端边密封泡棉条 | Rogers BISCO HT-870 9.53 mm | SEAL/GASKET/INSULATION (die/waterjet/skive) | 6 | INHERITED_C02_HOLD | C02 |  | False
S303 | 端边密封压条 | EN 1.4307 / 304L | MILLED/PRISMATIC (plate or bar) | 6 | INHERITED_C02_HOLD | C02 |  | False
J401 | 衬套轴封座 | EN 1.4307 / 304L | MILLED/PRISMATIC (plate or bar) | 6 | INHERITED_C02_HOLD | C02 |  | False
J402 | 轴封座静垫 | Solid EPDM70 sheet 0.8±0.1 | SEAL/GASKET/INSULATION (die/waterjet/skive) | 6 | INHERITED_C02_HOLD | C02 |  | False
BUY401 | igus XSM-3034-30 | iglidur X | PURCHASED | 2 | INHERITED_C02_HOLD | C02 |  | False
BUY402 | EPDM70-P AT-OR-01 O-ring 30×3 | EPDM70 peroxide cured | PURCHASED | 6 | INHERITED_C02_HOLD | C02 |  | False
J403 | 固定端销接轴环 | EN 1.4307 / 304L | TURNED | 3 | INHERITED_C02_HOLD | C02 | 6h6 ±0.01 平行0.01 | False
J404 | 固定端止推盖 | 304L | MILLED/PRISMATIC (plate or bar) | 3 | INHERITED_C02_HOLD | C02-R4 | ±0.01 ±0.02 | False
J405 | 止推盖隔套 | EN 1.4307 / 304L | TURNED | 12 | INHERITED_C02_HOLD | C02 | 0.01 ±0.01 平行0.01 | False
J406 | 止推垫 | Virgin PTFE 1.00±0.03 | SEAL/GASKET/INSULATION (die/waterjet/skive) | 6 | INHERITED_C02_HOLD | C02 | ±0.02 | False
BUY504 | KHK SSG3-55F30B | KHK S45C / hardened tooth | PURCHASED | 2 | INHERITED_C02_HOLD | C02 |  | False
D503 | 手动方榫接头及锁位盘 | EN 1.4307 / 304L | MILLED/PRISMATIC (plate or bar) | 2 | INHERITED_C02_HOLD | C02-R1 | +0.03 30H7 ±0.03 | False
D505 | 固定止挡及锁位板 | EN 1.4307 / 304L | MILLED/PRISMATIC (plate or bar) | 2 | INHERITED_C02_HOLD | C02-R1 |  | False
D506 | 端位锁销 | 17-4PH H1150 | TURNED | 2 | INHERITED_C02_HOLD | C02 |  | False
D511 | 止挡肩销 | 17-4PH H1150 | TURNED | 2 | INHERITED_C02_HOLD | C02 | 18H7 | False
D509 | 手动止挡板支柱 | 42CrMo4 +QT Rp0.2>=650MPa | TURNED | 4 | INHERITED_C02_HOLD | C02-R6 | ±0.03 | False
F602 | 静垫压缩限位套 | EN 1.4307 / 304L | TURNED | 92 | INHERITED_C02_HOLD | C02 | ±0.03 | False
F603 | 静垫压缩限位套 | EN 1.4307 / 304L | TURNED | 58 | INHERITED_C02_HOLD | C02 | ±0.03 | False
F604 | 静垫压缩限位套 | EN 1.4307 / 304L | TURNED | 24 | INHERITED_C02_HOLD | C02 | ±0.03 | False
F620 | P试装立肋 | EN 1.4307 / 304L | MILLED/PRISMATIC (plate or bar) | 2 | INHERITED_C02_HOLD | C02 |  | True
F621 | R试装侧肋 | EN 1.4307 / 304L | MILLED/PRISMATIC (plate or bar) | 2 | INHERITED_C02_HOLD | C02 |  | True
F622 | 试装脚板 | EN 1.4307 / 304L | MILLED/PRISMATIC (plate or bar) | 4 | INHERITED_C02_HOLD | C02 |  | False
P107B | P上游3mm接收框 | EN 1.4307 / 304L | SHEET (laser + deburr, some bend/weld) | 1 | INHERITED_C02_HOLD | C02 |  | False
D510B | 共用反力桥横梁 | EN 1.4307 / 304L | MILLED/PRISMATIC (plate or bar) | 0 | INHERITED_C02_HOLD | C02-R3 | +0.02 | True
D510EP | P反力桥侧耳 | EN 1.4307 / 304L | MILLED/PRISMATIC (plate or bar) | 0 | INHERITED_C02_HOLD | C02-R1 |  | True
D510P | P固定端反力桥焊总成 | EN 1.4307 / 304L | WELDMENT | 1 | INHERITED_C02_HOLD | C02-R3 |  | True
D510ER | R反力桥侧耳 | EN 1.4307 / 304L | MILLED/PRISMATIC (plate or bar) | 0 | INHERITED_C02_HOLD | C02-R1 |  | True
D510R | R固定端反力桥焊总成 | EN 1.4307 / 304L | WELDMENT | 1 | INHERITED_C02_HOLD | C02-R3 |  | True
STD12 | DIN6885-A 平键 8×7×40 精选 | C45 + corrosion protection | PURCHASED | 2 | INHERITED_C02_HOLD | C02 |  | False
D520 | 共用限矩器输出法兰 | 42CrMo4 +QT, Rp0.2 >=650 MPa | MILLED/PRISMATIC (plate or bar) | 2 | INHERITED_C02_HOLD | C02 | 75H7 同轴0.03 | False
BUY520 | mayr 1 / 490.715.0 / 30 / 110 Nm | Manufacturer steel; catalogue mass 1.98 kg | PURCHASED | 2 | INHERITED_C02_HOLD | C02 | 30h6 | False
BUY521 | mayr 1 / 490.715.0 / 30 / 160 Nm | Manufacturer steel; catalogue mass 1.98 kg | PURCHASED | 2 | INHERITED_C02_HOLD | C02 |  | False
D521 | 串联限矩器中间轴法兰 | 42CrMo4 +QT Rp0.2>=650MPa | TURNED | 2 | INHERITED_C02_HOLD | C02 |  | False
A701P | P F07可换驱动安装板 | 304L | MILLED/PRISMATIC (plate or bar) | 1 | INHERITED_C02_HOLD | C02 |  | False
A702P | P 执行器至限矩器插接轴 | 42CrMo4 +QT, Rp0.2(70C)>=650 MPa | TURNED | 1 | INHERITED_C02_HOLD | C02 | 30h6 | False
A703P | 固定半座R11前伸螺钉耳 A703P | EN 1.4307 / 304L | MILLED/PRISMATIC (plate or bar) | 2 | PHYSICAL_CANDIDATE_HOLD_NOT_FOR_MANUFACTURE | R11 |  | True
A701R | R F07可换驱动安装板 | 304L | MILLED/PRISMATIC (plate or bar) | 1 | INHERITED_C02_HOLD | C02 |  | False
A702R | R 执行器至限矩器插接轴 | 42CrMo4 +QT, Rp0.2(70C)>=900 MPa | TURNED | 1 | INHERITED_C02_HOLD | C02 | 30h6 | False
A703R | 固定半座R11前伸螺钉耳 A703R | EN 1.4307 / 304L | MILLED/PRISMATIC (plate or bar) | 1 | PHYSICAL_CANDIDATE_HOLD_NOT_FOR_MANUFACTURE | R11 |  | True
A704 | 共用输入支架立柱 | EN 1.4307 / 304L | MILLED/PRISMATIC (plate or bar) | 8 | INHERITED_C02_HOLD | C02 | 平行0.03 | False
A705 | 反馈固定外框 | EN 1.4307 / 304L | MILLED/PRISMATIC (plate or bar) | 3 | INHERITED_C02_HOLD | C02 |  | False
A706 | 编码器浮动安装环 | EN 1.4307 / 304L | TURNED | 3 | INHERITED_C02_HOLD | C02 | 36H7 | False
A707 | 轴向浮动反馈弹簧片 | EN 1.4310 spring strip, Rp0.2 >=600 MPa | MILLED/PRISMATIC (plate or bar) | 12 | INHERITED_C02_HOLD | C02 | ±0.015 | False
A709 | 浮动端反馈根部转接板 | 304L | MILLED/PRISMATIC (plate or bar) | 3 | INHERITED_C02_HOLD | C02-R5 | ±0.02 平面度0.03 | False
A710 | 反馈外框隔柱 | EN 1.4307 / 304L | MILLED/PRISMATIC (plate or bar) | 12 | INHERITED_C02_HOLD | C02 |  | False
BUY703 | Baumer EAL580-SC0.5WEN.18130.A / 11197423 | Supplier aluminium/zinc/steel; mass 0.50kg | PURCHASED | 3 | INHERITED_C02_HOLD | C02 | ±0.01 | False
BUY704 | Baumer 11053277 波纹管联轴器 10/10 | Supplier steel/aluminium; mass 0.016kg | PURCHASED | 3 | INHERITED_C02_HOLD | C02 |  | False
BUY701P | Valpes VSX150.90B.G00 | Supplier enclosure; mass 6.4kg upper reference | PURCHASED | 1 | INHERITED_C02_HOLD | C02 |  | False
BUY701R | Valpes VRX75.70B.G00 | Supplier enclosure; mass 4.4kg upper reference | PURCHASED | 1 | INHERITED_C02_HOLD | C02 |  | False
SUB701P | P执行器转动输出星孔接口 | Included in Valpes actuator, not separately ordered | PURCHASED | 1 | INHERITED_C02_HOLD | C02 |  | False
SUB701R | R执行器转动输出星孔接口 | Included in Valpes actuator, not separately ordered | PURCHASED | 1 | INHERITED_C02_HOLD | C02 |  | False
BUY530 | HBK 1-T210/200NM | Supplier transducer, dimension reconstruction | PURCHASED | 2 | INHERITED_C02_HOLD | C02 |  | False
D530 | 手动限矩器输入轴 | 42CrMo4 +QT Rp0.2>=650MPa | TURNED | 2 | INHERITED_C02_HOLD | C02 | 26h6 30h6 | False
BUY531 | R+W BK2/300/125/26/26 | Supplier steel/stainless bellows; 4.0 kg | PURCHASED | 4 | INHERITED_C02_HOLD | C02 | 26H7 | False
D532 | 手动扳杆输入套 | 42CrMo4 +QT | TURNED | 2 | INHERITED_C02_HOLD | C02 |  | False
D533 | 手动测量前支承板 | EN 1.4307 / 304L | MILLED/PRISMATIC (plate or bar) | 2 | INHERITED_C02_HOLD | C02 | 34H7 | False
D534 | 手动轴承座加长套 | EN 1.4307 / 304L | TURNED | 2 | INHERITED_C02_HOLD | C02 | 34H7 | True
D535 | 手动测量后轴承板 | EN 1.4307 / 304L | MILLED/PRISMATIC (plate or bar) | 2 | INHERITED_C02_HOLD | C02 | 25h6 47H7 | False
D536 | 手动后轴承外圈压盖 | EN 1.4307 / 304L | TURNED | 2 | INHERITED_C02_HOLD | C02 |  | False
D538 | 手动测量架支柱 | EN 1.4307 / 304L | MILLED/PRISMATIC (plate or bar) | 8 | INHERITED_C02_HOLD | C02 | 同轴0.05 | False
BUY535 | SKF 6005-2RSH | Supplier bearing steel | PURCHASED | 2 | INHERITED_C02_HOLD | C02 |  | True
G804 | 后隔热板隔柱 | EN 1.4307 / 304L | TURNED | 8 | INHERITED_C02_HOLD | C02 |  | False
G801P | P近机侧隔热背板 | EN 1.4307 / 304L | SHEET (laser + deburr, some bend/weld) | 1 | INHERITED_C02_HOLD | C02 |  | False
G802P | P封装微孔隔热芯 | AT-TI-01 microporous silica, noncombustible, hydrophobic | SEAL/GASKET/INSULATION (die/waterjet/skive) | 1 | INHERITED_C02_HOLD | C02 |  | False
G803P | P隔热芯封装面箔 | 304L foil | SEAL/GASKET/INSULATION (die/waterjet/skive) | 2 | INHERITED_C02_HOLD | C02 |  | False
G805P | P干侧窄颈侧板 | EN 1.4307 / 304L | SHEET (laser + deburr, some bend/weld) | 2 | INHERITED_C02_HOLD | C02 |  | True
G806P | P干侧窄颈上下板 | EN 1.4307 / 304L | SHEET (laser + deburr, some bend/weld) | 2 | INHERITED_C02_HOLD | C02 |  | False
G807P | P干侧扩展圈 | EN 1.4307 / 304L | SHEET (laser + deburr, some bend/weld) | 1 | INHERITED_C02_HOLD | C02 |  | False
G810P | P长护罩侧板 | EN 1.4307 / 304L | SHEET (laser + deburr, some bend/weld) | 2 | INHERITED_C02_HOLD | C02 |  | True
G811P | P长护罩上下板 | EN 1.4307 / 304L | SHEET (laser + deburr, some bend/weld) | 2 | INHERITED_C02_HOLD | C02 |  | False
G816P | P干侧可拆前盖 | EN 1.4307 / 304L | SHEET (laser + deburr, some bend/weld) | 1 | INHERITED_C02_HOLD | C02 |  | False
G818P | P自动配置轴孔盖片 | EN 1.4307 / 304L | SHEET (laser + deburr, some bend/weld) | 1 | INHERITED_C02_HOLD | C02 |  | False
G819P | P前盖角连接块 | 304L | MILLED/PRISMATIC (plate or bar) | 4 | INHERITED_C02_HOLD | C02 |  | True
G830P | 独立承重后框 P | EN 1.4307 / 304L | SHEET (laser + deburr, some bend/weld) | 1 | PHYSICAL_CANDIDATE_HOLD_NOT_FOR_MANUFACTURE | R11 |  | True
G831P | P反馈护罩侧板 | EN 1.4307 / 304L | SHEET (laser + deburr, some bend/weld) | 2 | HOOD_LOCAL_DEFINITION_INTERFACE_ACCEPTANCE_PENDING | R9 |  | True
G832P | P反馈护罩上下板 | EN 1.4307 / 304L | SHEET (laser + deburr, some bend/weld) | 2 | HOOD_LOCAL_DEFINITION_INTERFACE_ACCEPTANCE_PENDING | R9 |  | True
G833P | P反馈可拆前盖 | EN 1.4307 / 304L | SHEET (laser + deburr, some bend/weld) | 1 | HOOD_LOCAL_DEFINITION_INTERFACE_ACCEPTANCE_PENDING | R9 |  | False
G834P | P反馈前盖角块 | EN 1.4307 / 304L | MILLED/PRISMATIC (plate or bar) | 4 | HOOD_LOCAL_DEFINITION_INTERFACE_ACCEPTANCE_PENDING | R9 |  | True
G801R | R近机侧隔热背板 | EN 1.4307 / 304L | SHEET (laser + deburr, some bend/weld) | 1 | INHERITED_C02_HOLD | C02 |  | False
G802R | R封装微孔隔热芯 | AT-TI-01 microporous silica, noncombustible, hydrophobic | SEAL/GASKET/INSULATION (die/waterjet/skive) | 1 | INHERITED_C02_HOLD | C02 |  | False
G803R | R隔热芯封装面箔 | 304L foil | SEAL/GASKET/INSULATION (die/waterjet/skive) | 2 | INHERITED_C02_HOLD | C02 |  | False
G805R | R干侧窄颈侧板 | EN 1.4307 / 304L | SHEET (laser + deburr, some bend/weld) | 2 | INHERITED_C02_HOLD | C02 |  | True
G806R | R干侧窄颈上下板 | EN 1.4307 / 304L | SHEET (laser + deburr, some bend/weld) | 2 | INHERITED_C02_HOLD | C02 |  | False
G807R | R干侧扩展圈 | EN 1.4307 / 304L | SHEET (laser + deburr, some bend/weld) | 1 | INHERITED_C02_HOLD | C02 |  | False
G810R | R长护罩侧板 | EN 1.4307 / 304L | SHEET (laser + deburr, some bend/weld) | 2 | INHERITED_C02_HOLD | C02 |  | True
G811R | R长护罩上下板 | EN 1.4307 / 304L | SHEET (laser + deburr, some bend/weld) | 2 | INHERITED_C02_HOLD | C02 |  | False
G816R | R干侧可拆前盖 | EN 1.4307 / 304L | SHEET (laser + deburr, some bend/weld) | 1 | INHERITED_C02_HOLD | C02 |  | False
G818R | R自动配置轴孔盖片 | EN 1.4307 / 304L | SHEET (laser + deburr, some bend/weld) | 1 | INHERITED_C02_HOLD | C02 |  | False
G819R | R前盖角连接块 | 304L | MILLED/PRISMATIC (plate or bar) | 4 | INHERITED_C02_HOLD | C02 |  | True
G830R | 独立承重后框 R | EN 1.4307 / 304L | SHEET (laser + deburr, some bend/weld) | 1 | PHYSICAL_CANDIDATE_HOLD_NOT_FOR_MANUFACTURE | R11 |  | True
G831R | R反馈护罩侧板 | EN 1.4307 / 304L | SHEET (laser + deburr, some bend/weld) | 2 | HOOD_LOCAL_DEFINITION_INTERFACE_ACCEPTANCE_PENDING | R9 |  | True
G832R | R反馈护罩上下板 | EN 1.4307 / 304L | SHEET (laser + deburr, some bend/weld) | 2 | HOOD_LOCAL_DEFINITION_INTERFACE_ACCEPTANCE_PENDING | R9 |  | True
G833R | R反馈可拆前盖 | EN 1.4307 / 304L | SHEET (laser + deburr, some bend/weld) | 1 | HOOD_LOCAL_DEFINITION_INTERFACE_ACCEPTANCE_PENDING | R9 |  | False
G834R | R反馈前盖角块 | EN 1.4307 / 304L | MILLED/PRISMATIC (plate or bar) | 4 | HOOD_LOCAL_DEFINITION_INTERFACE_ACCEPTANCE_PENDING | R9 |  | True
G808 | 轴口隔热挡片 | AT-TI-02 glass mica laminate, k70<=0.25 W/(m.K) | SEAL/GASKET/INSULATION (die/waterjet/skive) | 3 | INHERITED_C02_HOLD | C02 |  | False
P111-1400 | P编号侧封量片 1.4 | 304L precision shim | PRECISION SHIM (laser/etch) | 0 | INHERITED_C02_HOLD | C02 | 0.01 ±0.015 | False
P111-0200 | P编号侧封量片 0.2 | 304L precision shim | PRECISION SHIM (laser/etch) | 0 | INHERITED_C02_HOLD | C02 | 0.01 ±0.015 | False
P111-0100 | P编号侧封量片 0.1 | 304L precision shim | PRECISION SHIM (laser/etch) | 0 | INHERITED_C02_HOLD | C02 | 0.01 ±0.015 | False
P111-0050 | P编号侧封量片 0.05 | 304L precision shim | PRECISION SHIM (laser/etch) | 0 | INHERITED_C02_HOLD | C02 | 0.01 ±0.015 | False
P111-0020 | P编号侧封量片 0.02 | 304L precision shim | PRECISION SHIM (laser/etch) | 0 | INHERITED_C02_HOLD | C02 | 0.01 ±0.015 | False
P111-0010 | P编号侧封量片 0.01 | 304L precision shim | PRECISION SHIM (laser/etch) | 0 | INHERITED_C02_HOLD | C02 | 0.01 ±0.015 | False
R111-1400 | R编号侧封量片 1.4 | 304L precision shim | PRECISION SHIM (laser/etch) | 0 | INHERITED_C02_HOLD | C02 | 0.01 ±0.015 | False
R111-0200 | R编号侧封量片 0.2 | 304L precision shim | PRECISION SHIM (laser/etch) | 0 | INHERITED_C02_HOLD | C02 | 0.01 ±0.015 | False
R111-0100 | R编号侧封量片 0.1 | 304L precision shim | PRECISION SHIM (laser/etch) | 0 | INHERITED_C02_HOLD | C02 | 0.01 ±0.015 | False
R111-0050 | R编号侧封量片 0.05 | 304L precision shim | PRECISION SHIM (laser/etch) | 0 | INHERITED_C02_HOLD | C02 | 0.01 ±0.015 | False
R111-0020 | R编号侧封量片 0.02 | 304L precision shim | PRECISION SHIM (laser/etch) | 0 | INHERITED_C02_HOLD | C02 | 0.01 ±0.015 | False
R111-0010 | R编号侧封量片 0.01 | 304L precision shim | PRECISION SHIM (laser/etch) | 0 | INHERITED_C02_HOLD | C02 | 0.01 ±0.015 | False
G840 | 侧检修板内焊螺纹块 | EN 1.4307 / 304L | MILLED/PRISMATIC (plate or bar) | 40 | INHERITED_C02_HOLD | C02 |  | True
S311 | 座梁调节槽双孔密封压板 | EN 1.4307 / 304L | SHEET (laser + deburr, some bend/weld) | 10 | INHERITED_C02_HOLD | C02 |  | False
S312 | 座梁调节槽静垫 | AT-OR-01 solid EPDM70, free0.8±0.1 | SEAL/GASKET/INSULATION (die/waterjet/skive) | 10 | INHERITED_C02_HOLD | C02 |  | False
S313 | 调节槽静垫限位环 | EN 1.4307 / 304L | TURNED | 20 | INHERITED_C02_HOLD | C02 | ±0.02 | False
G809 | 隔热挡片固定隔套 | EN 1.4307 / 304L | TURNED | 9 | INHERITED_C02_HOLD | C02 |  | False
D537 | 转矩测量定子托板 | EN 1.4307 / 304L | MILLED/PRISMATIC (plate or bar) | 2 | INHERITED_C02_HOLD | C02 |  | False
D541 | 手动定子托板隔柱 | EN 1.4307 / 304L | TURNED | 4 | INHERITED_C02_HOLD | C02 | 平行0.02 | False
D539 | 护罩外手动延长接头 | 42CrMo4 +QT Rp0.2>=650MPa | TURNED | 2 | INHERITED_C02_HOLD | C02 |  | False
D540 | 可拆手动500级扳杆 | 42CrMo4 +QT handle body; polymer grip sleeve | MILLED/PRISMATIC (plate or bar) | 0 | INHERITED_C02_HOLD | C02 |  | False
HW_PIN5 | 延长接头销Ø5×44 | 17-4PH H1150 | PURCHASED | 2 | INHERITED_C02_HOLD | C02 |  | False
HW_COTTER16 | 开口销1.6×16 | A4 stainless | PURCHASED | 2 | INHERITED_C02_HOLD | C02 |  | False
F640 | 手动试装台面参考 | Steel plate on independently rated bench | KIT/REFERENCE | 1 | INHERITED_C02_HOLD | C02 |  | False
F630P | P手动后支架立柱 | EN 1.4307 / 304L | MILLED/PRISMATIC (plate or bar) | 2 | INHERITED_C02_HOLD | C02 |  | True
F630R | R手动后支架立柱 | EN 1.4307 / 304L | MILLED/PRISMATIC (plate or bar) | 2 | INHERITED_C02_HOLD | C02 |  | True
F631 | 手动后支架顶板 | EN 1.4307 / 304L | MILLED/PRISMATIC (plate or bar) | 2 | INHERITED_C02_HOLD | C02 |  | False
F632 | 手动后支架脚板 | EN 1.4307 / 304L | MILLED/PRISMATIC (plate or bar) | 2 | INHERITED_C02_HOLD | C02 |  | False
F623 | R台架脚部三角肋 | EN 1.4307 / 304L | MILLED/PRISMATIC (plate or bar) | 2 | INHERITED_C02_HOLD | C02 |  | True
STD16 | 锁销防脱索组件 | A4 preformed anti-drop tether, project procurement specification | PURCHASED | 2 | INHERITED_C02_HOLD | C02 |  | False
G820 | 锁销收纳座 | EN 1.4307 / 304L | MILLED/PRISMATIC (plate or bar) | 2 | INHERITED_C02_HOLD | C02 |  | True
P102A | P中分法兰-分片A | EN 1.4307 / 304L | SHEET (laser + deburr, some bend/weld) | 0 | INHERITED_C02_HOLD | C02 |  | True
P102B | P中分法兰-分片B | EN 1.4307 / 304L | MILLED/PRISMATIC (plate or bar) | 0 | INHERITED_C02_HOLD | C02 |  | True
P102C | P中分法兰-分片C | EN 1.4307 / 304L | MILLED/PRISMATIC (plate or bar) | 0 | INHERITED_C02_HOLD | C02 |  | True
P102D | P中分法兰-分片D | EN 1.4307 / 304L | MILLED/PRISMATIC (plate or bar) | 0 | INHERITED_C02_HOLD | C02 |  | True
P102E | P中分法兰-分片E | EN 1.4307 / 304L | SHEET (laser + deburr, some bend/weld) | 0 | INHERITED_C02_HOLD | C02 |  | True
P105A | P中分静密封-分片A | Rogers BISCO HT-870 3.18 mm | SEAL/GASKET/INSULATION (die/waterjet/skive) | 0 | INHERITED_C02_HOLD | C02 |  | False
P105B | P中分静密封-分片B | Rogers BISCO HT-870 3.18 mm | SEAL/GASKET/INSULATION (die/waterjet/skive) | 0 | INHERITED_C02_HOLD | C02 |  | False
R102A | R中分法兰-分片A | EN 1.4307 / 304L | SHEET (laser + deburr, some bend/weld) | 0 | INHERITED_C02_HOLD | C02 |  | True
R102B | R中分法兰-分片B | EN 1.4307 / 304L | MILLED/PRISMATIC (plate or bar) | 0 | INHERITED_C02_HOLD | C02 |  | True
R105A | R中分静密封-分片A | Rogers BISCO HT-870 3.18 mm | SEAL/GASKET/INSULATION (die/waterjet/skive) | 0 | INHERITED_C02_HOLD | C02 |  | False
G811PM | P长护罩上下板 手动台架专用 | EN 1.4307 / 304L | SHEET (laser + deburr, some bend/weld) | 1 | INHERITED_C02_HOLD | C02 |  | False
G810RM | R长护罩侧板 手动台架专用 | EN 1.4307 / 304L | SHEET (laser + deburr, some bend/weld) | 1 | INHERITED_C02_HOLD | C02 |  | True
STD01C | STD01C 螺钉/销 | A4-80 | PURCHASED | 9 | INHERITED_C02_HOLD | C02 |  | False
HW_W8_1p6_16 | 平垫圈 | A4 | PURCHASED | 198 | INHERITED_C02_HOLD | C02 |  | False
HW_N8 | 全金属锁紧螺母 | A4-80 | PURCHASED | 60 | INHERITED_C02_HOLD | C02 |  | False
STD01B | STD01B 螺钉/销 | A4-80 | PURCHASED | 51 | INHERITED_C02_HOLD | C02 |  | False
STD01PC | STD01PC 螺钉/销 | A4-80 | MILLED/PRISMATIC (plate or bar) | 4 | INHERITED_C02_HOLD | C02 |  | False
STD01P | STD01P 螺钉/销 | A4-80 | PURCHASED | 28 | INHERITED_C02_HOLD | C02 |  | False
STD02B | STD02B 螺钉/销 | A4-80 | PURCHASED | 58 | INHERITED_C02_HOLD | C02 |  | False
HW_W6_1p6_12 | 平垫圈 | A4 | PURCHASED | 158 | INHERITED_C02_HOLD | C02 |  | False
HW_N6 | 全金属锁紧螺母 | A4-80 | PURCHASED | 85 | INHERITED_C02_HOLD | C02 |  | False
STD03C | 固定端低头拉紧螺柱 | 17-4PH H1150; Rp0.2 at 70C >=700MPa | TURNED | 12 | INHERITED_C02_HOLD | C02-R6-PROCESS | ±0.03 平面度0.03 | True
STD04C | 浮动端低头拉紧螺柱 | 17-4PH H1150; Rp0.2 at 70C >=700MPa | TURNED | 12 | INHERITED_C02_HOLD | C02-R6-PROCESS | ±0.03 平面度0.03 | True
STD08B | STD08B 螺钉/销 | A4-80 | PURCHASED | 48 | INHERITED_C02_HOLD | C02 |  | False
HW_W3_0p5_7 | 平垫圈 | A4 | PURCHASED | 90 | INHERITED_C02_HOLD | C02 |  | False
HW_N3 | 全金属锁紧螺母 | A4-80 | PURCHASED | 57 | INHERITED_C02_HOLD | C02 |  | False
STD06B | STD06B 螺钉/销 | A4-80 | PURCHASED | 20 | INHERITED_C02_HOLD | C02 |  | False
HW_W5_1_10 | 平垫圈 | A4 | PURCHASED | 52 | INHERITED_C02_HOLD | C02 |  | False
STD07B | STD07B 螺钉/销 | A4-80 | PURCHASED | 78 | INHERITED_C02_HOLD | C02 |  | False
STD05B | STD05B 螺钉/销 | 17-4PH H1150, Rp0.2(70C)>=700MPa | MILLED/PRISMATIC (plate or bar) | 3 | INHERITED_C02_HOLD | C02 | 6h6 | False
STD13R | STD13R 螺钉/销 | A4-80 | PURCHASED | 2 | INHERITED_C02_HOLD | C02 |  | False
HW_N12 | 全金属锁紧螺母 | A4-80 | PURCHASED | 2 | INHERITED_C02_HOLD | C02 |  | False
STD10B | STD10B 螺钉/销 | A4-80 | PURCHASED | 8 | INHERITED_C02_HOLD | C02 |  | False
STD14B | STD14B 螺钉/销 | A4-80 | PURCHASED | 24 | INHERITED_C02_HOLD | C02 |  | False
HW_W10_2_20 | 平垫圈 | A4 | PURCHASED | 48 | INHERITED_C02_HOLD | C02 |  | False
HW_N10 | 全金属锁紧螺母 | A4-80 | PURCHASED | 24 | INHERITED_C02_HOLD | C02 |  | False
HW_MAYR_OUT | HW_MAYR_OUT 螺钉/销 | A4-80 | PURCHASED | 32 | INHERITED_C02_HOLD | C02 |  | False
HW_F07 | HW_F07 螺钉/销 | A4-80 | PURCHASED | 8 | INHERITED_C02_HOLD | C02 |  | False
HW_A704I | HW_A704I 螺钉/销 | A4-80 | PURCHASED | 8 | INHERITED_C02_HOLD | C02 |  | False
HW_A704CS | M8×30 90°沉头螺钉 | A4-80 | PURCHASED | 8 | INHERITED_C02_HOLD | C02 |  | False
HW_CAP_CS3 | M3×10 沉头轴承盖螺钉 | A4-80 | PURCHASED | 6 | INHERITED_C02_HOLD | C02 |  | False
HW_MAN_RAIL_F | HW_MAN_RAIL_F 螺钉/销 | A4-80 | PURCHASED | 8 | INHERITED_C02_HOLD | C02 |  | False
HW_MAN_RAIL_R | HW_MAN_RAIL_R 螺钉/销 | A4-80 | PURCHASED | 8 | INHERITED_C02_HOLD | C02 |  | False
HW_A703 | HW_A703 螺钉/销 | A4-80 | PURCHASED | 0 | INHERITED_C02_HOLD | C02 |  | False
HW_BELLOWS25 | HW_BELLOWS25 螺钉/销 | A4-80 | PURCHASED | 6 | INHERITED_C02_HOLD | C02 |  | False
HW_FB_REAR | HW_FB_REAR 螺钉/销 | A4-80 | PURCHASED | 12 | INHERITED_C02_HOLD | C02 |  | False
HW_FB_FRONT | HW_FB_FRONT 螺钉/销 | A4-80 | PURCHASED | 12 | INHERITED_C02_HOLD | C02 |  | False
HW_ENCODER_M4 | HW_ENCODER_M4 螺钉/销 | A4-80 | PURCHASED | 17 | INHERITED_C02_HOLD | C02 |  | False
HW_W4_1_9 | 平垫圈 | A4 | PURCHASED | 17 | INHERITED_C02_HOLD | C02 |  | False
HW_FLEX_M3 | HW_FLEX_M3 螺钉/销 | A4-80 | PURCHASED | 24 | INHERITED_C02_HOLD | C02 |  | False
HW_GUARD_M4L | HW_GUARD_M4L 螺钉/销 | A4-80 | PURCHASED | 8 | INHERITED_C02_HOLD | C02 |  | False
HW_W4_0p8_9 | 前盖M4平垫圈 | A4 | PURCHASED | 74 | INHERITED_C02_HOLD | C02 |  | False
HW_THERM_M3 | HW_THERM_M3 螺钉/销 | A4-80 | PURCHASED | 9 | INHERITED_C02_HOLD | C02 |  | False
HW_GUARD_M5 | HW_GUARD_M5 螺钉/销 | A4-80 | PURCHASED | 8 | INHERITED_C02_HOLD | C02 |  | False
HW_PLUG_M4 | HW_PLUG_M4 螺钉/销 | A4-80 | PURCHASED | 4 | INHERITED_C02_HOLD | C02 |  | False
HW_N4 | 全金属锁紧螺母 | A4-80 | PURCHASED | 4 | INHERITED_C02_HOLD | C02 |  | False
HW_FB_COVER_M4 | 前盖M4螺钉 | A4-80 | PURCHASED | 8 | INHERITED_C02_HOLD | C02 |  | False
HW_T210_M4 | HW_T210_M4 螺钉/销 | A4-80 | PURCHASED | 8 | INHERITED_C02_HOLD | C02 |  | False
HW_W4_1p2_9 | 平垫圈 | A4 | PURCHASED | 8 | INHERITED_C02_HOLD | C02 |  | False
HW_STATOR_M6 | HW_STATOR_M6 螺钉/销 | A4-80 | PURCHASED | 4 | INHERITED_C02_HOLD | C02 |  | False
HW_STAND_M8 | HW_STAND_M8 螺钉/销 | A4-80 | PURCHASED | 4 | INHERITED_C02_HOLD | C02 |  | False
HW_SIDE_M4 | HW_SIDE_M4 螺钉/销 | A4-80 | PURCHASED | 50 | INHERITED_C02_HOLD | C02 |  | False
P100F | 半阀壳焊接总成 | EN 1.4307 / 304L | WELDMENT | 0 | INHERITED_C02_HOLD | C02 |  | True
P100B | 半阀壳焊接总成 | EN 1.4307 / 304L | WELDMENT | 0 | INHERITED_C02_HOLD | C02 |  | True
R100F | 半阀壳焊接总成 | EN 1.4307 / 304L | WELDMENT | 0 | INHERITED_C02_HOLD | C02 |  | True
R100B | 半阀壳焊接总成 | EN 1.4307 / 304L | WELDMENT | 0 | INHERITED_C02_HOLD | C02 |  | True
R100S | R抬高段焊接总成 | EN 1.4307 / 304L | WELDMENT | 0 | INHERITED_C02_HOLD | C02 |  | True
F600P | 独立试装工装焊接总成 | EN 1.4307 / 304L | WELDMENT | 0 | INHERITED_C02_HOLD | C02 |  | True
F600R | 独立试装工装焊接总成 | EN 1.4307 / 304L | WELDMENT | 0 | INHERITED_C02_HOLD | C02 |  | True
F650P | 独立试装工装焊接总成 | EN 1.4307 / 304L | WELDMENT | 0 | INHERITED_C02_HOLD | C02 |  | True
F650R | 独立试装工装焊接总成 | EN 1.4307 / 304L | WELDMENT | 0 | INHERITED_C02_HOLD | C02 |  | True
D542 | 湿侧AF9.5反持工具 | 17-4PH H1150; Rp0.2 at70C >=700MPa | SHEET (laser + deburr, some bend/weld) | 0 | INHERITED_C02_HOLD | C02-R1 | ±0.03 | False
D543 | 可换带法兰径向承托套 | UNS C93200; qualified Rp0.2@70C>=100MPa, E>=90GPa | MILLED/PRISMATIC (plate or bar) | 2 | INHERITED_C02_HOLD | C02-R3 | 0.01 ±0.03 | False
D544 | J401干侧可拆半框承托 | EN1.4307 / 304L | MILLED/PRISMATIC (plate or bar) | 4 | INHERITED_C02_HOLD | C02-R3 |  | False
HW_D544_M8 | M8×20按钮头承托紧固件 | A4 Rm>=600 / Rp0.2>=450MPa | PURCHASED | 8 | INHERITED_C02_HOLD | C02-R3 |  | False
D545 | 径向可退出承托连接块 | EN1.4307 / 304L | MILLED/PRISMATIC (plate or bar) | 8 | INHERITED_C02_HOLD | C02-R3 | ±0.03 平行0.03 平面度0.03 | True
HW_D545_M6 | M6×20按钮头连接螺钉 | A4 Rm>=600 / Rp0.2>=450MPa | PURCHASED | 8 | INHERITED_C02_HOLD | C02-R3 |  | False
D546 | P双轴共同定位板 | 304L | MILLED/PRISMATIC (plate or bar) | 1 | INHERITED_C02_HOLD | C02-R6 | 32H7 ±0.015 同轴0.01 | True
D547 | 双轴定位短铜衬套 | C93200 qualified bronze | TURNED | 4 | INHERITED_C02_HOLD | C02-R7 |  | False
D549 | P共同板肩台定位支柱 | 42CrMo4 +QT Rp0.2>=650MPa | TURNED | 4 | INHERITED_C02_HOLD | C02-R6 | ±0.03 平行0.01 | False
D550 | M30槽形锁紧螺母 | 42CrMo4+QT Rp0.2>=650MPa | MILLED/PRISMATIC (plate or bar) | 4 | INHERITED_C02_HOLD | C02-R4 |  | False
D551 | M30锁片 | 304L | SHEET (laser + deburr, some bend/weld) | 4 | INHERITED_C02_HOLD | C02-R4 |  | False
J407 | 可换短承载带轴封衬套 | C93200 qualified bronze | MILLED/PRISMATIC (plate or bar) | 6 | INHERITED_C02_HOLD | C02-R4 | 34H7 | False
BUY548 | SCHNORR 002700A碟簧 | SCHNORR standard spring steel; certified batch | PURCHASED | 144 | INHERITED_C02_HOLD | C02-R5 |  | False
J408 | 碟簧硬支承垫 | 100Cr6 55-60HRC | TURNED | 48 | INHERITED_C02_HOLD | C02-R5 | 0.01 HRC Ra0.4 ±0.02 | False
A704R8 | 夹爪R11平支点及防脱耳 | 17-4PH H900 | MILLED/PRISMATIC (plate or bar) | 3 | PHYSICAL_CANDIDATE_HOLD_NOT_FOR_MANUFACTURE | R11 | HRC Ra0.4 同轴0.05 平面度0.01 | True
G835P | P可拆罩后法兰 | EN 1.4307 / 304L | SHEET (laser + deburr, some bend/weld) | 1 | HOOD_LOCAL_DEFINITION_INTERFACE_ACCEPTANCE_PENDING | R9 |  | False
G836 | 罩壳固定螺纹块 | EN 1.4307 / 304L | MILLED/PRISMATIC (plate or bar) | 8 | HOOD_LOCAL_DEFINITION_INTERFACE_ACCEPTANCE_PENDING | R9 | ±0.03 平行0.03 | True
G837 | 罩壳角部背衬-沉位Z0 | EN 1.4307 / 304L | SHEET (laser + deburr, some bend/weld) | 8 | HOOD_LOCAL_DEFINITION_INTERFACE_ACCEPTANCE_PENDING | R9 | ±0.03 | True
HW_R8_HOOD_M5 | 罩壳M5主连接螺钉 | A4-80 | PURCHASED | 8 | LOCAL_REVIEW_CANDIDATE_NOT_FOR_MANUFACTURE | R8 |  | False
HW_R8_HOOD_W5 | 罩壳M5平垫圈 | EN 1.4307 / 304L | PURCHASED | 8 | LOCAL_REVIEW_CANDIDATE_NOT_FOR_MANUFACTURE | R8 | ±0.02 平面度0.03 | False
G835R | R可拆罩后法兰 | EN 1.4307 / 304L | SHEET (laser + deburr, some bend/weld) | 1 | HOOD_LOCAL_DEFINITION_INTERFACE_ACCEPTANCE_PENDING | R9 |  | False
BUY_R9_DS001500A | 标准碟簧001500A安装态 | C75S spring steel | PURCHASED | 60 | R10_FEEDBACK_ZERO_AND_CONTACT_CONTRACT_HOLD | R9 |  | False
HW_R9_HARD_W5 | 夹头弹簧硬垫圈 | 17-4PH H900 | PURCHASED | 12 | R10_FEEDBACK_ZERO_AND_CONTACT_CONTRACT_HOLD | R9 | HRC ±0.02 平面度0.02 淬硬 | False
HW_R9_GUIDE_M5 | 夹头M5导向螺钉 | A4-80 | PURCHASED | 0 | R10_FEEDBACK_ZERO_AND_CONTACT_CONTRACT_HOLD | R9 |  | False
G841 | A710独立补偿隔套 | EN 1.4307 / 304L | TURNED | 12 | PHYSICAL_CANDIDATE_HOLD_NOT_FOR_MANUFACTURE | R11 | ±0.02 平行0.02 | True
G840P1 | P罩框独立横梁1 | EN 1.4307 / 304L | MILLED/PRISMATIC (plate or bar) | 1 | PHYSICAL_CANDIDATE_HOLD_NOT_FOR_MANUFACTURE | R11 |  | True
G840P2 | P罩框独立横梁2 | EN 1.4307 / 304L | MILLED/PRISMATIC (plate or bar) | 1 | PHYSICAL_CANDIDATE_HOLD_NOT_FOR_MANUFACTURE | R11 |  | True
G840R1 | R罩框独立竖梁1 | EN 1.4307 / 304L | MILLED/PRISMATIC (plate or bar) | 1 | PHYSICAL_CANDIDATE_HOLD_NOT_FOR_MANUFACTURE | R11 |  | True
G840R2 | R罩框独立竖梁2 | EN 1.4307 / 304L | MILLED/PRISMATIC (plate or bar) | 1 | PHYSICAL_CANDIDATE_HOLD_NOT_FOR_MANUFACTURE | R11 |  | True
G842 | R107两根脚间背衬 | EN 1.4307 / 304L | MILLED/PRISMATIC (plate or bar) | 1 | PHYSICAL_CANDIDATE_HOLD_NOT_FOR_MANUFACTURE | R11 |  | True
B850 | 实际摆动均力压桥 | 440C HRC58..60 | TURNED | 3 | PHYSICAL_CANDIDATE_HOLD_NOT_FOR_MANUFACTURE | R11 | +0.02 HRC Ra0.2 ±0.01 淬硬 轮廓0.01 | True
B851 | 球面弹簧传力座 | 440C HRC58..60 | MILLED/PRISMATIC (plate or bar) | 6 | PHYSICAL_CANDIDATE_HOLD_NOT_FOR_MANUFACTURE | R11 | 0.01 Ra0.4 平面度0.01 | True
B852 | 桥防脱压入销 | 17-4PH H900 | TURNED | 3 | PHYSICAL_CANDIDATE_HOLD_NOT_FOR_MANUFACTURE | R11 | 3m6 | True
HW_R11_GUIDE_M5 | 均力桥M5导向螺钉57 | A4-80 | TURNED | 6 | PHYSICAL_CANDIDATE_HOLD_NOT_FOR_MANUFACTURE | R11 |  | True
