fredshuc/buildfly/AirTransformerShell/revisions/C06/RT2_REVIEW/C06_RT2_FINDINGS.csv

id | module | class | gates_cold_flow | gates_manufacture | file | part | state | result | criterion | smallest_correction | closing_evidence | label
N1 | Shell/seal | BLOCKER | yes | yes | build_c06.py | SLIDING_SEAL_CARRIER / ADJ_SCREW | installed | Flat 5 mm ring I~193 mm4; 8 screws on vertical sides only; top/bottom 674 mm span deflects 16-66 mm (linear) at 15-60 kPa vs 1.8 mm stroke | Uniform 4.2 mm installed gasket thickness all round | Stiff closed carrier frame (I>=2e4 mm4) with >=12 clamp points incl. top/bottom mid-span and hard stops | Pressure film/feeler map of gasket; seat bypass tracer test | V/E
N2 | Shell/seal | BLOCKER | yes | yes | build_c06.py | ADJ_LUG on cheeks / CASSETTE_BEARER | installed | Clamp 0.79-3.18 kN per face reacts into cassette; only bearer contacts at Z104; 1.2-5.0 kN.m overturning; 5.9-23.5 kN bearer couple | Clamp force self-equilibrated; seal-land deflection < stroke margin | Removable tie rods F<->R carriers at ~cy-355 / cy+392 (10 mm from HX) or react on HX beam/top-cross frame | Load path drawing; measured seal-land deflection | V/E
N3 | Shell/seal | BLOCKER | yes | yes | build_c06.py | GUIDE/CHEEK tips; carrier window | installed and insertion | Tips at 0.000 mm to HX frame; carrier 0.000 mm sliding fit on cheeks/guides; series leak 0.49-1.02% of P per face for 0.3-1.0 mm gaps at 150 Pa | Seat bypass <=0.2% of P per bed (C2) | Set tips back >=3 mm; lip/wiper or EPDM bellows between carrier and cassette; gasket inner edge closed on frame bar | Tracer bypass test | V/E
N4 | Shell/service | BLOCKER | yes | yes | build_c06.py | A/B_HX_TRAY / TRAY_NOZZLE / PAN_PAD | withdrawal | HX +-Y slide blocked by tray set and forks; tray blocked at 5 mm in -Y/+Y/-Z by HX feet and bottom bars with HX installed; nozzle (Z1135) would hit beam (Z1150) | Complete withdrawal sequence (handoff decision 2) | Fix tray to HX bottom bars (withdrawn with core); hose + dry-break above Z1150 | Rerun sweep with tray as part of core; trial | V
N5 | Shell/DFM | BLOCKER | yes | yes | build_c06.py | outboard CHEEK slots | manufacture | 42.5 mm3 left across slot band = 6.3 mm total ligament over 1000 mm (7x0.6 + 2x1.05); forward strip carries carrier sliding face | Robust cheek and sliding surface | Separate formed angle forward strip fastened to 9 guide lands or slots with >=10 mm ligaments; plate clips | Drawing; first-article | V
N6 | Shell/drain | CONDITION | yes | yes | build_c06.py | DRAIN_STUB / HX_TRAY_NOZZLE | wet and dry | Untrapped 20 mm drains end 74 mm above ground; 10.8-15.3 m3/h each at 150-300 Pa (0.22-0.31% P); HX tray nozzles discharge into cavity with no floor drain | Trap seal >=62 mm; no open air path | External traps or plinth >=150 mm; hose tray nozzles through floor; cap in dry tests | Wet test without standing water; leak test | V/E
N7 | HX/Water | BLOCKER (live water) | no | yes | HX RT1_PORT_ALIGNMENT/INSTALLED_PORTS.csv vs HYD-R1 / C06 interfaces.csv | W1/W2 functions | hot mode | HX register: hot enters W2 (W1=CS/HR); HYD-R1 and C06: W1 supply in both modes (W1=CS/HS) | Single signed function table | HX owner confirms direction incl. header venting; update the other register | Signed table | S
N8 | Dampers/stand | CONDITION | yes | yes | build_c06.py | *_SUPPORT_PAD / STAND_* (front portals) | installed | Pads contact only last ~13 mm at outer flange; ~50% of damper weight via adapter studs to 2.5 mm wall (D01 forbids); front portals stand on ground outside base | Adapter carries seal load only; one skid | Extend ledges under inner flange/body; tie front portals to base | Load path drawing; flange deflection measurement | V/E
N9 | Structure | GATE | stand | yes | build_c06.py | RISER_BRACE / TOP_FORK / end planes / SIDE_BRACE / HX_TOP_CROSS | all | Braces and forks restrain Y only; HX X-sway 7.6-17.7 Hz; no end-plane diagonals (~140 N/mm); straps tension-only and removed in service; top cross 4 mm short of side panels | Designed racking and HX restraint in both directions | X fork/pin at HX lugs; X-Z riser bracing; end-plane diagonals; temporary service brace | FE or modal test | V/E
N10 | Service | GATE | yes | yes | build_c06.py / D01_ACTUATOR_RESERVES.json | side panel | service | Rear actuator reserve 250 > 187 cut-out: two actuators off and panel threaded 464 mm over drive lines; plate tuning also needs side panel off | Documented practicable sequence | Split side panel at ~Z1000 (cut-outs <=Z848; HX window Z1150-2400) | Trial sequence on cold-flow article | V
N11 | Instrumentation | CONDITION | yes | no | build_c06.py | BOX_CHEEK taps | test | Taps in boxes only; none in HX frame recess | HX dp measurable at G1 | Two taps per face via inboard cheek forward strip | Tap list on test drawing | V
R1-A1 | Air | OPEN | yes | yes | C04 selector geometry (unchanged) | selector boxes | R supply | No CFD/mock-up; no R-port vane fixing points (C5) | RT-1 G0 | Run G0; reserve vane fixings | CFD or mock-up | S
X2 | Reproduction | VERIFIED | no | no | build_c06.py / integrate.py / verify_motion.py | all | rerun | 327/327 solids identical; integration and motion results identical; interfaces.csv byte-identical | Reproducible | None | Done | V
