fredshuc/buildfly/AirTransformerShell/revisions/C04/RT1_REVIEW/C04_RT1_FINDINGS.csv

id | module | class | gates_cold_flow | gates_manufacture | file | part | state | result | criterion | smallest_correction | closing_evidence | label
S1 | Shell | BLOCKER | yes | yes | build_c04.py | BOTTOM / DUAL_VALVE_FLANGE / FLOOR | all | Cassette 80.5 kg CG Z1238 unsupported (BOTTOM 38.5 above FLOOR); front P+R dampers 178 kg steel-equivalent per bed cantilevered on 2.5 mm flange | Defined load path; R21 requires independent dry support | Two uprights per cassette to base sills + lateral clip at HX beam; independent damper stands | Load-path drawing; seal-land deflection under dead load vs gasket allowance | V/E
S2 | Shell | BLOCKER | yes | yes | build_c04.py | SEAT_RETURN vs HX frame | all | Rigid flush contact; zero gasket volume; no clamp; bypass 0.24/0.48/1.2% of P per face at 0.1/0.2/0.5 mm mean gap and 150 Pa | Seat bypass <=0.2% of P per bed (proposed) | Closed-cell gasket 25-35% compression with screw/toggle clamp released before extraction | Recorded compression; tracer or pressure-decay bypass test | V/E
S3 | Shell | CONDITION | yes | no | build_c04.py | BALANCE_BAND_00..07 | tuning | Plates 12 mm from HX frame between guide lands; HX removal per tuning step; plate-to-fin 43.65 mm = 2.2-2.4 d | Plates exchangeable without HX removal; valid patch measurement | Side slots in one cheek with gasketed cover; leaving-face thermal rake + coil dp map | Plate exchange demonstrated; rake calibration | V
S4 | Shell | CONDITION | wet test | yes | build_c04.py | BOTTOM / under-HX cavity | wet | No drain; 46 mm sump below P port; guides drain into boxes | Positive drainage with trap seal > box static pressure | Drain at each box low point with >=60 mm trap; drip tray under each HX | Wet test with no standing water | V
S5 | Shell | GATE | no | yes | build_c04.py | WATER_GLAND / shell cavity | all | Single shared cavity for 4 cassettes and both beds; gland is 750x240 strip not bulkhead; valves above rear dampers without containment | Defined cavity pressure; P>ambient>R hierarchy; leak containment | Vent cavity to ambient; specify fan arrangement; drip tray/partition under valve zone | Pressure map; leak path review | V/I
S6 | Shell | GATE | stand only | yes | build_c04.py | POST / ROOF_RAIL / BASE_Y_CROSS / RISER | all | Bare frame 34 N/mm; no top Y or end base cross members; HX on 4 unbraced 40x40x3 risers f1 7-9 Hz (pinned) to 14-16 Hz (fixed) for 80-110 kg | f1 separated from fan speeds and transport excitation; designed racking path | Diagonal riser bracing; HX top lateral guide slotted in Z; end base and top Y members | FE or modal test; load cases and reactions | E
S7 | Shell | GATE | no | yes | build_c04.py | SIDE skins / ROOF / beams | service | HX sweeps clear 900 mm +/-Y with side skin removed and 1300 mm +Z with roof removed; -X blocked by front cassette at 50 mm | Documented extraction | Adopt outboard +/-Y slide on transfer rails at Z1150; crush tubes for M16 through RHS; union access from side/roof | Extraction trial on cold-flow article | V
S8 | Shell | GATE | no | yes | build_c04.py | overall | transport | Height 2552 before feet; ~1.4 t estimate; no lifting points | Transport and lifting plan | Define lifting points and transport split | Lift plan | E
H1 | HX | VERIFIED | no | no | M101 C04 STEP | 537 solids | static | 0 clashes at A/B; fin window seat bolt pattern and ports coincide with shell datums | 0.001 mm3 | None | Done | V
H2 | HX | CONDITION | yes | yes | M101 C04 | coated core | dry/wet | 60 Pa assumed; screen 38-76 Pa laminar Re~570; wet bridging risk at 1.87 mm gap; header drains inside machine | Measured dry/wet dp curve with coating | Supplier dp test; flatness spec on seal land; route drains | Test report | E
D1 | Dampers | BLOCKER | no (single bed) | yes | build_c04.py / R21 STEP | P and R dampers at 8 interfaces | installed | R21 feedback end 217 and drive end 288-528 beyond flange; gap between A and B flanges 134 | >=434 (two feedback ends) or >=537 (feedback + drive to bearing) | Single-bed test as is; machine: X-offset bed B dampers >=200 or pitch >=1140 or move dampers to external manifolds | Installed R21 STEP at 8 positions; full-stroke clash and tool access | V
D2 | Dampers | BLOCKER | no | yes | build_c04.py | DRIVE_RESERVE / SIDE cut-outs | installed | Reserve 160x170x220 and cut-out 161x222 vs P gear pair 336x171 at 229-288 beyond flange and BK2 pair 275 span at skin plane; drive line >=528 + actuator | Envelope from actual drive train | Size reserves and cut-outs from R21 STEP + selected actuator (78/120 N.m P; 38 N.m R) | Updated reserve and clash set | V
D3 | Dampers | BLOCKER | no | yes | build_c04.py | B-bed dampers | installed | Drives outboard on both beds makes B opposite-hand; R21 orientation restriction (P O1prime) | Qualified orientation for every installed damper | Opposite-hand variant or owner qualification or same-side drives | Damper owner statement | S/I
D4 | Dampers | CONDITION | yes | yes | build_c04.py | DUAL_VALVE_FLANGE | assembly | Nuts inside closed selector box; 2.5 mm wall | Fastening possible after box closure | M8 CD weld studs on box flange; flatness check 716x980 | Assembly trial | V
W1 | Water | BLOCKER | no | yes | C02 WATER_INTERFACES.json / C04 valve references | B_VL / B_VU | cold and hot | B valves at Y75.325 vs ports 764.675/614.675 (dY -689/-539); table maps B_VL to B.W2 and B_VU to B.W1 (reversed for same-orientation C04 HX) | B_VL.AB->B.W1; B_VU.AB->B.W2; routed spools | Re-place B pair near Y615-765 with >=70 mm inboard jog or 90 deg rotation about X; re-tag table | Updated table and routed spool CAD | V
W2 | Water | BLOCKER | no | yes | C02 native A_VU/B_VU_ACTUATOR_WITHDRAWAL | upper actuators | service | Withdrawal to Z2607.5; 57.5 through roof; 38590 mm3 each; not in C04 clash set | Withdrawal clear | Roof hatch over valve zone or lower VU >=60; add withdrawal volumes to clash set | Clash set including service volumes | V
W3 | Water | GATE | no | yes | C04 | headers and branches | all | No headers; C02 headers +1000 put HS at Z2663-2697 above roof | Continuous routed headers and branches | Route headers below roof; supports; union release sequence | Routed CAD + hydrostatic test plan | V
W4 | Water | GATE | no | yes | hydronics | 4 x 3-way valves | transition | Mid-stroke CS<->HR and CR<->HS; A/B mixed states; ~0.5-0.7 L per stroke (Kv~2 assumed); 11 L plug to opposite return each switch (~2.3 MJ per bed-cycle per side) | State table with timing and limits | Issue 2-HX state/timing table; measure mid-stroke Kv; owner decision on port assignment trade-off | Bench test of isolation and continuity | S/E
W5 | Water | GATE | no | yes | hydronics/RT01_review | P&ID | all | RT01 is 4-HX C05 PARTIAL_FAILED; no 2-HX baseline | 2-HX P&ID | Issue 2-HX P&ID with FS/RV per bed and fail positions | Reviewed P&ID | S
A1 | Air | BLOCKER (gate G0) | yes | yes | selector_flow.py / selector_results.json | selector boxes | R supply | P and R face fields bit-identical (no momentum); authority M=9.1 (P) vs 2.5 (R); band deviation 1.6-5.5% P and 6-20% R for c=0.3-1; R L/D 0.86 | Each patch 0.80-1.20 of mean; CV<=10% | CFD or mock-up before cutting; R-port turning vanes or splash baffle if confirmed | CFD/mock-up then G1 R-mode test | V/E
A2 | Air | CONDITION | yes | yes | network.py / selector_flow.py | path losses | P and R | Independent 219-278 Pa (P 4870); 311-431 (R 4870); 90-120 (R 2435) vs model 325/276/69; R<P ranking reversed | Fan meets duty | Fan >=550 Pa at 4870 + external with VFD until measured | G1 measured fan duty | E
A3 | Air | CONDITION | yes | yes | dampers on shared selector box | closed damper / transitions | switching | Allowed R->P leak 0.67% (32.5 m3/h) -> 667 mm2 at 300 Pa = 0.30 mm mean gap on one R damper | Owner-set humidity carry-over limit | Break-before-make damper table; fan ramp/bypass; tracer test | Tracer-gas cross-leak result | E
A4 | Air | VERIFIED | no | no | design.py | GUIDE_00..08 | flow | Miller V_c 49.6 m/s vs 7.55; sag <=1.05 mm; f1 9.6-21.7 Hz | No divergence; gap tolerance | None (monitor drumming) | Run observation | E
X1 | Reproduction | VERIFIED | no | no | network.py / selector_flow.py / build_c04.py | all | rerun | All numeric leaves identical; 28/188 solids; per-solid geometry identical; file SHA differs (STEP header timestamps) | Reproducible geometry | Record geometry signature instead of file hash | Done | V
