fredshuc/buildfly/mat-prod/03_budget/Implementation_Resources.xlsx

Sheet: Summary
MAT61 implementation resources
Partner | PM | Personnel EUR | Travel EUR | Equipment EUR | Other goods EUR | Direct EUR | Indirect EUR | Total EUR | Initial EUR | Change EUR
SAV | 78 | €468000 | €12000 | €134000 | €163780 | €777780 | €194445 | €972225 | €720000 | €252225
IRC | 36 | €216000 | €12000 | €6000 | €36000 | €270000 | €67500 | €337500 | €480000 | -€142500
IKTS | 40 | €320000 | €10000 | €12000 | €72000 | €414000 | €103500 | €517500 | €500000 | €17500
UP | 44 | €220000 | €10000 | €18000 | €28000 | €276000 | €69000 | €345000 | €400000 | -€55000
HPE | 26 | €234000 | €6000 | €4000 | €8000 | €252000 | €63000 | €315000 | €300000 | €15000
Total | 224 | €1458000 | €50000 | €174000 | €307780 | €1989780 | €497445 | €2487225 | €2400000 | €87225
Ceiling headroom EUR |  | €12775 |  | Unallocated; no reserve cost line
WP | Work package | PM | Eligible budget EUR
WP1 | Coordination quality and data governance | 18 | €207500
WP2 | Cycle directed MOF design and reproducible production | 43 | €498000
WP3 | Shaping and structured adsorber manufacturing | 39 | €452500
WP4 | Non equilibrium models and state estimation | 37 | €320000
WP5 | Adaptive energy flow allocation and control | 29 | €285000
WP6 | Instrumented platform and TRL 4 validation | 45 | €590475
WP7 | Exploitation sustainability and dissemination | 13 | €133750
Total |  | 224 | €2487225
Thermal and production sizing | Calculated value | Unit |  |  | Interpretation
Nominal module duty | 10.00 | kW |  |  | User-set mechanical and service basis
Average useful heat from inventory | 10.50 | kW |  |  | Sizing estimate; not measured performance
Useful water flow | 1.72 | m3/h |  |  | Density approximately 1000 kg/m3
Source heat design | 25.00 | kW |  |  | Includes evaporation and regeneration
Production recovered new MOF | 153.00 | kg |  |  | Compared with 120 kg final active charge
Main rig hours | 2104.00 | hour |  |  | Commissioning through transfer, complete histories
Primary matrix run count | 144.00 | history |  |  | 4 physical x 3 policies x 4 held histories x 3 groups
Primary rig booking capacity | 1440.00 | hour |  |  | M25-M32 booking target
Final production train capacity | 1980.00 | hour |  |  | M13-M23, M24 forming; access unconfirmed

Sheet: Assumptions
MAT61 inputs and source status
Partner | Performing participant | EUR per PM | Cost-rate basis
SAV | Savery | 6000 | Working eligible employer-cost assumption; no individual salary or partner approval
IRC | IRCELYON | 6000 | Working eligible employer-cost assumption; no individual salary or partner approval
IKTS | Fraunhofer IKTS | 8000 | Working eligible employer-cost assumption; no individual salary or partner approval
UP | UPorto | 5000 | Working eligible employer-cost assumption; no individual salary or partner approval
HPE | HPE Galway | 9000 | Working eligible employer-cost assumption; no individual salary or partner approval
 | Project months | 36 | User brief; 36-month design assumption
 | Funding rate | 100.0% | RIA planning basis; confirm submission-session financial form
 | Indirect cost rate | 25.0% | General Annex G; excludes subcontract and overhead-inclusive recharges
 | Working target EUR | €2400000 | Initial L1 target
 | Ceiling EUR | €2500000 | L1 ceiling and official topic maximum contribution
 | Nominal module useful kW | 10 | User instruction: 10 kW per module, 6 November 2026
 | Source C | 55 | Primary design condition
 | Rejection C | 25 | Primary design condition
 | Hot supply C | 70 | Qualified thermal-service outlet
 | Hot return C | 65 | Qualified thermal-service inlet
 | Beds per module | 2 | One complete two-bed mechanical module
 | Active dry MOF kg per bed | 10 | Sizing assumption; not a measured capacity
 | Working swing kg per kg | 0.15 | Replace with measured dynamic swing
 | Adsorption enthalpy J per kg water | 2800000 | Loading-average design assumption
 | Full bed cycle seconds | 600 | Each bed changes role at approximately half this time
 | Useful heat fraction | 0.75 | Sensible/switching/heat-recovery design factor
 | Water heat capacity J per kg K | 4180 | Engineering design approximation
 | Recovered active-MOF yield | 0.85 | Manufacturing assumption; record active mass separately from binder
 | Final new powder kg | 180 | 36 separate 5 kg dry-output lots
 | Active fraction of shaped mass | 0.85 | Design assumption; determined by measured formulation
 | Minimum common matched kW | 5 | Below this, report feasibility without a forced percentage
 | Electricity EUR per kWh | 0.15 | Common controller objective; price sensitivity, not market quote
 | Drive heat EUR per kWh | 0.02 | Common controller objective; source heat is not automatically free
 | Primary rig hours per month | 180 | M25-M32 booking target, not confirmed access
 | Savery production lines | 1 | One 5 kg line specified by Savery; validate net output and calendar
 | Hours per train per month | 180 | M13-M23 capacity assumption
 | Production months | 11 | M12 recipe selection; production M13-M23, M24 final forming
 | Thermal useful/source ratio | 0.4 | Drive-heat sizing assumption, not achieved COP
 | Hours per paid PM | 160 | FTE workload convention for planning; actual grant personnel method remains partner-specific
Partner | Role slot | PM | Peak FTE capacity | Minimum people
SAV | Scientific coordinator | 12 | 0.6 | 1
SAV | Integration engineers | 30 | 1.5 | 2
SAV | Experimental technicians | 20 | 1 | 2
SAV | Project and data officer | 4 | 0.2 | 1
SAV | Synthesis scientist and technical operator | 12 | 0.85 | 2
IRC | Materials scientific lead | 6 | 0.4 | 1
IRC | Sorption and materials researchers | 20 | 1.65 | 2
IRC | Laboratory technicians | 10 | 0.9 | 2
IKTS | Shaping scientific lead | 6 | 0.4 | 1
IKTS | Process researchers | 24 | 1.5 | 2
IKTS | Manufacturing technicians | 10 | 0.8 | 2
UP | Modelling scientific lead | 8 | 0.5 | 1
UP | Dynamic modelling researchers | 30 | 1.8 | 2
UP | Research software engineer | 6 | 0.4 | 1
HPE | Control scientific lead | 6 | 0.4 | 1
HPE | Control and HIL researchers | 20 | 1.3 | 2
Amber cells are editable planning inputs. Cost/source notes identify unconfirmed access or rates.

Sheet: Tasks
Task effort and personnel cost
Task | Task name | WP | Lead | Start M | End M | Months | SAV PM | IRC PM | IKTS PM | UP PM | HPE PM | Total PM | Personnel EUR | SAV PM/mo | IRC PM/mo | IKTS PM/mo | UP PM/mo | HPE PM/mo
T1.1 | Coordination and technical decisions | WP1 | SAV | 1 | 36 | 36 | 5 | 0.5 | 0.5 | 0.5 | 0.5 | 7 | €44000 | 0.139 | 0.014 | 0.014 | 0.014 | 0.014
T1.2 | Data quality and reproducibility | WP1 | SAV | 1 | 36 | 36 | 3 | 1 | 1 | 1 | 1 | 7 | €46000 | 0.083 | 0.028 | 0.028 | 0.028 | 0.028
T1.3 | Resources and operational readiness | WP1 | SAV | 1 | 36 | 36 | 2 | 0.5 | 0.5 | 0.5 | 0.5 | 4 | €26000 | 0.056 | 0.014 | 0.014 | 0.014 | 0.014
T2.1 | Composition exploration and cycle fingerprints | WP2 | IRC | 1 | 9 | 9 | 4 | 7 | 1 | 1 | 0 | 13 | €79000 | 0.444 | 0.778 | 0.111 | 0.111 | 0.000
T2.2 | Reproducible production and mechanistic measurements | WP2 | IRC | 4 | 18 | 15 | 5 | 8 | 1 | 1 | 0 | 15 | €91000 | 0.333 | 0.533 | 0.067 | 0.067 | 0.000
T2.3 | Validation batches and ageing | WP2 | SAV | 10 | 26 | 17 | 7 | 5 | 1 | 2 | 0 | 15 | €90000 | 0.412 | 0.294 | 0.059 | 0.118 | 0.000
T3.1 | Two shaping routes and interface specification | WP3 | IKTS | 2 | 10 | 9 | 1 | 2 | 8 | 1 | 0 | 12 | €87000 | 0.111 | 0.222 | 0.889 | 0.111 | 0.000
T3.2 | Manufacturing windows and transport parameters | WP3 | IKTS | 8 | 18 | 11 | 1 | 2 | 10 | 2 | 0 | 15 | €108000 | 0.091 | 0.182 | 0.909 | 0.182 | 0.000
T3.3 | Independent cartridges and quality release | WP3 | IKTS | 16 | 25 | 10 | 2 | 1 | 8 | 1 | 0 | 12 | €87000 | 0.200 | 0.100 | 0.800 | 0.100 | 0.000
T4.1 | Conservation models and identifiable experiments | WP4 | UP | 1 | 10 | 10 | 2 | 1 | 1 | 7 | 1 | 12 | €70000 | 0.200 | 0.100 | 0.100 | 0.700 | 0.100
T4.2 | Reduced models and state estimation | WP4 | UP | 6 | 22 | 17 | 2 | 2 | 1 | 9 | 2 | 16 | €95000 | 0.118 | 0.118 | 0.059 | 0.529 | 0.118
T4.3 | Prospective prediction and model correction | WP4 | UP | 18 | 34 | 17 | 1 | 1 | 0 | 6 | 1 | 9 | €51000 | 0.059 | 0.059 | 0.000 | 0.353 | 0.059
T5.1 | Control baselines and common information | WP5 | HPE | 3 | 12 | 10 | 1 | 0 | 0 | 2 | 4 | 7 | €52000 | 0.100 | 0.000 | 0.000 | 0.200 | 0.400
T5.2 | Constrained RL for energy flow allocation | WP5 | HPE | 8 | 24 | 17 | 2 | 1 | 1 | 3 | 8 | 15 | €113000 | 0.118 | 0.059 | 0.059 | 0.176 | 0.471
T5.3 | Closed loop comparison and transfer | WP5 | HPE | 20 | 34 | 15 | 2 | 0 | 0 | 1 | 4 | 7 | €53000 | 0.133 | 0.000 | 0.000 | 0.067 | 0.267
T6.1 | Early instrumented reference platform | WP6 | SAV | 1 | 8 | 8 | 10 | 0 | 0 | 1 | 0 | 11 | €65000 | 1.250 | 0.000 | 0.000 | 0.125 | 0.000
T6.2 | Actuator ablation and component iterations | WP6 | SAV | 7 | 22 | 16 | 8 | 1 | 1 | 1 | 1 | 12 | €76000 | 0.500 | 0.062 | 0.062 | 0.062 | 0.062
T6.3 | Blinded integrated comparison | WP6 | SAV | 23 | 34 | 12 | 10 | 1 | 2 | 2 | 2 | 17 | €110000 | 0.833 | 0.083 | 0.167 | 0.167 | 0.167
T6.4 | Evidence consolidation and TRL 4 assessment | WP6 | SAV | 31 | 36 | 6 | 4 | 0 | 1 | 0 | 0 | 5 | €32000 | 0.667 | 0.000 | 0.167 | 0.000 | 0.000
T7.1 | Early dissemination exploitation and communication plan | WP7 | SAV | 1 | 6 | 6 | 2 | 0 | 0 | 0 | 0 | 2 | €12000 | 0.333 | 0.000 | 0.000 | 0.000 | 0.000
T7.2 | Manufacturing sustainability and economic boundaries | WP7 | SAV | 7 | 32 | 26 | 2 | 1 | 1 | 1 | 0 | 5 | €31000 | 0.077 | 0.038 | 0.038 | 0.038 | 0.000
T7.3 | Protected results and subsequent development | WP7 | SAV | 12 | 36 | 25 | 2 | 1 | 1 | 1 | 1 | 6 | €40000 | 0.080 | 0.040 | 0.040 | 0.040 | 0.040
Total |  |  |  |  |  |  | 78 | 36 | 40 | 44 | 26 | 224 | 1458000

Sheet: Cost lines
Cost drivers and eligible purchase costs
ID | Partner | WP | Category | Description | Quantity | Unit | EUR per unit | Use share | Project months | Life months | Eligible share | Eligible cost EUR | Indirect eligible 1/0 | Indirect base EUR | Source and assumption
S-E1 | SAV | WP6 | C2 | Thermal bath rental | 40 | bath-month | 800 | 0.75 | 1 | 1 | 1 | €24000 | 1 | €24000 | Two 25 kW-class thermal boundary units for 20 months at 75% use; 10 kW module planning rental, no quote
S-E2 | SAV | WP6 | C2 | Instrumented test skid rental | 24 | month | 2000 | 1 | 1 | 1 | 1 | €48000 | 1 | €48000 | 10 kW useful-heat module, approximately 25 kW source heat; project-exclusive planning rental, not a reservation
S-E3 | SAV | WP6 | C2 | Vapour mover and branch compressor rental | 24 | month | 1500 | 1 | 1 | 1 | 1 | €36000 | 1 | €36000 | 10 kW module vapour train, approximately 200-300 m3/h at design suction; actual pressure/flow map and quote unconfirmed
S-E4 | SAV | WP6 | C2 | DAQ and electrical metering rental | 30 | month | 500 | 1 | 1 | 1 | 1 | €15000 | 1 | €15000 | Planning rental with calibration; project-exclusive use
S-E5 | SAV | WP6 | C2 | Sensor asset eligible depreciation | 1 | asset | 10000 | 1 | 30 | 60 | 1 | €5000 | 1 | €5000 | Assumed eligible asset cost; remaining useful life and ownership to verify
S-C1 | SAV | WP2 | C3 | Reference MOF purchase | 200 | kg | 150 | 1 | 1 | 1 | 1 | €30000 | 1 | €30000 | Bulk reference-MOF planning price; three independent 60 kg production batches plus 20 kg development, not a supplier quote
S-C2 | SAV | WP6 | C3 | Reusable carrier and housing interface pairs | 4 | set | 6000 | 1 | 1 | 1 | 1 | €24000 | 1 | €24000 | Four reusable pairs for the single 10 kW rig; twelve independently manufactured adsorbent sets use the same mechanical platform
S-C3 | SAV | WP6 | C3 | Valves seals fluids and assembly consumables | 12 | lot | 1000 | 1 | 1 | 1 | 1 | €12000 | 1 | €12000 | Twelve complete test-set interventions
S-C4 | SAV | WP6 | C3 | Rework and calibration consumables | 6 | lot | 1000 | 1 | 1 | 1 | 1 | €6000 | 1 | €6000 | Defined consumable lots, not contingency
S-X1 | SAV | WP6 | C3 | Traceable calibration services | 12 | set | 600 | 1 | 1 | 1 | 1 | €7200 | 1 | €7200 | Routine standard services; scientific interpretation stays with beneficiary
S-X2 | SAV | WP6 | C3 | Leak and electrical conformity checks | 6 | check | 800 | 1 | 1 | 1 | 1 | €4800 | 1 | €4800 | Routine purchased tests, no delegated research task
S-T1 | SAV | WP1 | C1 | Travel and subsistence | 12 | mission | 1000 | 1 | 1 | 1 | 1 | €12000 | 1 | €12000 | Six consortium reviews plus technical visits, blended planning allowance
S-D1 | SAV | WP7 | C3 | Publication event and communication purchases | 3 | bundle | 2000 | 1 | 1 | 1 | 1 | €6000 | 1 | €6000 | Project-attributable external goods/services; not staff time
I-E1 | IRC | WP2 | C2 | Sorption and calorimetry equipment use | 1 | asset share | 12000 | 1 | 30 | 60 | 1 | €6000 | 1 | €6000 | IRCELYON measurement asset pool; verify eligible depreciation and actual use.
S-M1 | SAV | WP2 | C3 | Small-batch chemistry consumables | 57 | batch | 200 | 1 | 1 | 1 | 1 | €11400 | 1 | €11400 | 36 exploratory, 12 confirmation, 6 route-development, 3 mechanism batches
S-M2 | SAV | WP2 | C3 | Kilogram production consumables | 180 | kg dry output | 250 | 1 | 1 | 1 | 1 | €45000 | 1 | €45000 | 36 planned lots × 5 kg released dry powder. Working EUR/kg: yield-adjusted linker 90, metal precursor 20, modifier 30, net solvent 45, process consumables 35, sample/QC supplies 30. No salary/overhead or booked fee included. Not a quote.
S-M3 | SAV | WP2 | C3 | Solvent recovery and waste consumables | 10 | campaign | 1000 | 1 | 1 | 1 | 1 | €10000 | 1 | €10000 | Direct materials and routine disposal, excludes research personnel
I-X1 | IRC | WP2 | C3 | Diffraction or spectroscopy facility use | 200 | hour | 100 | 1 | 1 | 1 | 1 | €20000 | 1 | €20000 | Routine instrument access; IRC staff design and interpret experiments; no synchrotron award assumed
I-X2 | IRC | WP2 | C3 | Routine compositional assays | 100 | assay | 100 | 1 | 1 | 1 | 1 | €10000 | 1 | €10000 | Purchased standard assay, no external synthesis task
I-T1 | IRC | WP1 | C1 | Travel and subsistence | 12 | mission | 1000 | 1 | 1 | 1 | 1 | €12000 | 1 | €12000 | Blended planning allowance
I-D1 | IRC | WP7 | C3 | Publication and dissemination purchases | 3 | bundle | 2000 | 1 | 1 | 1 | 1 | €6000 | 1 | €6000 | Planning allowance
K-E1 | IKTS | WP3 | C2 | Low-temperature forming equipment depreciation | 1 | asset share | 40000 | 1 | 18 | 60 | 1 | €12000 | 1 | €12000 | Assumed remaining depreciable base; verify equipment and use method
K-C1 | IKTS | WP3 | C3 | Exploratory forming consumables | 24 | lot | 500 | 1 | 1 | 1 | 1 | €12000 | 1 | €12000 | Twenty-four independent forming lots
K-C2 | IKTS | WP3 | C3 | Structured cartridge internals | 12 | set | 1500 | 1 | 1 | 1 | 1 | €18000 | 1 | €18000 | Twelve 20 kg-active-MOF sets: binder/conductive phase and structured internals only; powder and reusable Savery carriers charged separately
K-C3 | IKTS | WP3 | C3 | Quality and ageing consumables | 8 | campaign | 1000 | 1 | 1 | 1 | 1 | €8000 | 1 | €8000 | Direct consumables for property tests and 24 ageing coupons
K-X1 | IKTS | WP3 | C3 | Standard mechanical and property test access | 200 | hour | 100 | 1 | 1 | 1 | 1 | €20000 | 1 | €20000 | Routine instrument-use access; core process work remains with IKTS
K-X2 | IKTS | WP3 | C3 | External dimensional metrology and calibration | 10 | set | 1000 | 1 | 1 | 1 | 1 | €10000 | 1 | €10000 | Standard purchases
K-T1 | IKTS | WP1 | C1 | Travel and subsistence | 10 | mission | 1000 | 1 | 1 | 1 | 1 | €10000 | 1 | €10000 | Blended planning allowance
K-D1 | IKTS | WP7 | C3 | Publication and dissemination purchases | 2 | bundle | 2000 | 1 | 1 | 1 | 1 | €4000 | 1 | €4000 | Planning allowance
U-E1 | UP | WP4 | C2 | Modelling compute equipment depreciation | 1 | asset pool | 36000 | 1 | 18 | 36 | 1 | €18000 | 1 | €18000 | Planning depreciable asset base and project use, not a free facility
U-X1 | UP | WP4 | C3 | External CPU compute | 20000 | CPU-hour | 0.6 | 1 | 1 | 1 | 1 | €12000 | 1 | €12000 | Planning on-demand rate, not an institutional overhead-inclusive recharge
U-X2 | UP | WP4 | C3 | External GPU compute | 2000 | GPU-hour | 3 | 1 | 1 | 1 | 1 | €6000 | 1 | €6000 | Planning on-demand rate
U-X3 | UP | WP4 | C3 | Versioned dataset storage and reproducibility services | 4 | bundle | 1000 | 1 | 1 | 1 | 1 | €4000 | 1 | €4000 | Planning external storage and archival-service allowance
U-T1 | UP | WP1 | C1 | Travel and subsistence | 10 | mission | 1000 | 1 | 1 | 1 | 1 | €10000 | 1 | €10000 | Blended planning allowance
U-D1 | UP | WP7 | C3 | Publication and dissemination purchases | 3 | bundle | 2000 | 1 | 1 | 1 | 1 | €6000 | 1 | €6000 | Planning allowance
H-E1 | HPE | WP5 | C2 | Control HIL compute asset depreciation | 1 | asset | 10000 | 1 | 24 | 60 | 1 | €4000 | 1 | €4000 | Assumed project use and remaining asset life
H-X1 | HPE | WP5 | C3 | External CPU compute | 5000 | CPU-hour | 0.6 | 1 | 1 | 1 | 1 | €3000 | 1 | €3000 | Planning on-demand rate
H-X2 | HPE | WP5 | C3 | External GPU compute | 1000 | GPU-hour | 3 | 1 | 1 | 1 | 1 | €3000 | 1 | €3000 | Planning on-demand rate
H-T1 | HPE | WP1 | C1 | Travel and subsistence | 6 | mission | 1000 | 1 | 1 | 1 | 1 | €6000 | 1 | €6000 | Blended planning allowance
H-D1 | HPE | WP7 | C3 | Publication and dissemination purchases | 1 | bundle | 2000 | 1 | 1 | 1 | 1 | €2000 | 1 | €2000 | Planning allowance
S-C5 | SAV | WP6 | C3 | Measured laboratory rig utilities | 41 | MWh | 180 | 1 | 1 | 1 | 1 | €7380 | 1 | €7380 | 2104 rig-hours at approximately 19.5 kW average laboratory electrical input, including imposed thermal boundaries and machine electricity; whole-run average is a design assumption. Performance boundary keeps imposed heat and fixture electricity separate.
S-ME1 | SAV | WP2 | C2 | Synthesis line equipment use | 1 | asset share | 12000 | 1 | 30 | 60 | 1 | €6000 | 1 | €6000 | Provisional share of single 5 kg line depreciation; verify asset basis, remaining useful life and actual use.
Total |  |  |  |  |  |  |  |  |  |  |  | 531780 |  | 531780

Sheet: Workload
Workload powder and facility capacity
ID | Stage | Count | Independent unit | Amount per unit | Output unit | Total output | Hours per unit | Total hours | Owner | Task | Basis
W01 | Exploratory synthesis | 36 | independent batch | 0.02 | kg MOF | 0.72 | 8.00 | 288.00 | SAV | T2.1 | 12 compositions x 3 separate syntheses
W02 | Confirmation synthesis | 12 | independent batch | 0.1 | kg MOF | 1.20 | 12.00 | 144.00 | SAV | T2.2 | 4 compositions x 3 separate syntheses
W03 | Process-development powder | 6 | independent batch | 0.6 | kg MOF | 3.60 | 24.00 | 144.00 | SAV | T2.2 | 2 finalists x 3 batches; supplies 24 forming lots
W04 | Mechanism-study powder | 3 | independent batch | 0.2 | kg MOF | 0.60 | 12.00 | 36.00 | SAV | T2.2 | Three independent batch blocks
W05 | Final production powder | 36 | independent batch | 5 | kg MOF | 180.00 | 32.00 | 1152.00 | SAV | T2.3 | Six disjoint 30 kg groups of six independent 5 kg dry-output lots; 32 h full occupancy per lot is a planning assumption.
W06 | Purchased reference powder | 1 | procurement batch plan | 200 | kg MOF | 200.00 | 0.00 | 0.00 | SAV | T2.1 | 180 kg from three independently produced 60 kg supplier batches plus 20 kg development stock
W07 | Shaping exploration | 24 | forming lot | 0.15 | kg MOF input | 3.60 | 12.00 | 288.00 | IKTS | T3.1 | 2 chemistries x 2 routes x 3 settings x 2 separately formed lots
W08 | Complete validation sets | 12 | two-bed set | 20 | kg MOF charge | 240.00 | 24.00 | 288.00 | IKTS | T3.3 | 2 chemistries x 2 routes x 3 independent assembly groups; 240 kg active MOF installed sequentially on one 10 kW module
W09 | Screening isotherms | 108 | isotherm | 1 | profile | 108.00 | 4.00 | 432.00 | IRC | T2.1 | 36 independent synthesis batches x 3 temperatures
W10 | Confirmation isotherms | 36 | isotherm | 1 | profile | 36.00 | 4.00 | 144.00 | IRC | T2.2 | 12 independent confirmation batches x 3 temperatures
W11 | Calorimetry | 24 | loading profile | 1 | profile | 24.00 | 6.00 | 144.00 | IRC | T2.2 | 4 compositions x 3 batch blocks x adsorption/desorption
W12 | Mechanism histories | 48 | complete history | 1 | history | 48.00 | 1.50 | 72.00 | IRC | T2.2 | 2 chemistries x 2 thicknesses x 2 contacts x 2 preparations x 3 batch blocks; reset included
W13 | Shaping property profiles | 288 | lot-property profile | 1 | profile | 288.00 | 0.50 | 144.00 | IKTS | T3.2 | 24 forming lots x 12 profiles; these are measurements, not 288 independent material replicates
W14 | Coupon ageing | 24 | coupon | 500 | cycle | 12000.00 | 41.67 | 1000.00 | IRC | T2.3 | 4 physical cells x 3 batch blocks x 2 stress histories, 5 min/cycle; 1000 chamber-hours, separate from main rig
W15 | Rig commissioning | 1 | campaign | 1 | campaign | 1.00 | 160.00 | 160.00 | SAV | T6.1 | 160 main-rig hours
W16 | Reference metering checks | 1 | campaign | 1 | campaign | 1.00 | 120.00 | 120.00 | SAV | T6.2 | 120 main-rig hours
W17 | Actuator ablation | 32 | complete history | 1 | history | 32.00 | 4.00 | 128.00 | SAV | T6.2 | Four actuator modes, eight discriminating histories; complete reset included
W18 | Controller development | 72 | complete history | 1 | history | 72.00 | 4.00 | 288.00 | SAV | T6.2 | 4 physical cells x 3 policies x 6 development histories; all strategies receive equal physical tuning opportunities
W19 | Prospective primary validation | 144 | complete history | 1 | history | 144.00 | 8.00 | 1152.00 | SAV | T6.3 | 4 physical cells x 3 policies x 4 sealed challenges x 3 independent blocks; 4 service + 2 reset + 2 setup hours
W20 | Reserved correction and repeats | 24 | complete history | 1 | history | 24.00 | 8.00 | 192.00 | SAV | T6.3 | Defined repeated-test allocation, not a monetary reserve
W21 | Transfer validation | 8 | complete history | 1 | history | 8.00 | 8.00 | 64.00 | SAV | T6.4 | Adjacent delivery-temperature check after primary tests; no second operating mode
W22 | HIL validation | 108 | test history | 1 | test | 108.00 | 1.00 | 108.00 | HPE | T5.2 | 36 normal/fault histories x 3 policies; no physical MOF use
Facility | Required hours | Available hours | Capacity basis
Primary validation rig | 1152 | 1440 | 180 hours/month x 8 months; 1152 hours required
Final production reactor trains | 1152 | 1980 | One Savery 5 kg line; 32 h/lot and availability are planning values
All synthesis occupancy | 1764 | To confirm | Includes 57 smaller batches outside/alongside the final production campaign
Forming and internal quality | 720 | To confirm | 288 forming + 288 final-set manufacture + 144 property-profile hours
Coupon ageing | 1000 | To confirm | Separate apparatus, not added to main rig occupancy
Powder balance | Quantity | Unit | Basis
New powder output | 186.12 | kg | 93 independent syntheses
Reference powder | 200 | kg | Three 60 kg supplier batches plus 20 kg development
Final active MOF installed | 240 | kg | 12 two-bed sets x 20 kg, sequential installation
Recovered new powder | 153 | kg | 180 kg input x measured/design recovery
New final active MOF requirement | 120 | kg | Two new-material shaping routes x three groups
New archive/characterisation/spare | 33 | kg | 153 - 120 = 33 kg at nominal yield
Condition | Split | Source C | Rejection C | Supply C | Duty kW |  |  |  |  |  | History definition
C01 | DEV | 55 | 25 | 70 | 10 |  |  |  |  |  | Steady nominal
C02 | DEV | 50 | 25 | 65 | 8 |  |  |  |  |  | Source step
C03 | DEV | 60 | 25 | 70 | 10 |  |  |  |  |  | Load ramp
C04 | DEV | 55 | 30 | 70 | 8 |  |  |  |  |  | Rejection step
C05 | DEV | 55 | 20 | 70 | 10 |  |  |  |  |  | Source ramp
C06 | DEV | 60 | 30 | 75 | 8 |  |  |  |  |  | Two-level demand
C07 | DEV | 50 | 20 | 65 | 10 |  |  |  |  |  | Warm/cold preparation
C08 | DEV | 55 | 25 | 70 | 5 |  |  |  |  |  | Part load
C09 | FINAL | 55 | 25 | 70 | 10 |  |  |  |  |  | Nominal boundary with withheld preparation history
C10 | FINAL | 58 | 23 | 72 | 10 |  |  |  |  |  | Unseen load step sequence
C11 | FINAL | 50 | 30 | 70 | 7 |  |  |  |  |  | Edge-of-domain disturbance and recovery
C12 | FINAL | 60 | 28 | 75 | 8 |  |  |  |  |  | Unseen order-reversed boundary history

Sheet: Monthly FTE
Monthly and six month effort profile
Partner or role | PM | FTE capacity | Average FTE | Peak FTE | M1 | M2 | M3 | M4 | M5 | M6 | M7 | M8 | M9 | M10 | M11 | M12 | M13 | M14 | M15 | M16 | M17 | M18 | M19 | M20 | M21 | M22 | M23 | M24 | M25 | M26 | M27 | M28 | M29 | M30 | M31 | M32 | M33 | M34 | M35 | M36 | Phase 1 | Phase 2 | Phase 3 | Phase 4 | Phase 5 | Phase 6
SAV | 78 | 4.15 | 2.17 | 3.62 | 2.51 | 2.62 | 2.72 | 3.05 | 3.05 | 3.17 | 3.41 | 3.62 | 2.37 | 2.34 | 2.03 | 2.11 | 2.01 | 2.01 | 2.01 | 2.21 | 2.21 | 2.26 | 1.84 | 1.97 | 1.97 | 1.97 | 2.19 | 2.19 | 2.07 | 1.87 | 1.46 | 1.46 | 1.46 | 1.46 | 2.13 | 2.13 | 2.05 | 2.05 | 1.02 | 1.02 | 2.85 | 2.64 | 2.12 | 2.02 | 1.63 | 1.73
IRC | 36 | 2.95 | 1.00 | 2.15 | 0.93 | 1.16 | 1.16 | 1.69 | 1.69 | 1.81 | 1.91 | 2.15 | 2.15 | 1.66 | 1.34 | 1.38 | 1.38 | 1.38 | 1.38 | 1.48 | 1.48 | 1.54 | 0.83 | 0.83 | 0.83 | 0.83 | 0.73 | 0.73 | 0.67 | 0.57 | 0.28 | 0.28 | 0.28 | 0.28 | 0.28 | 0.28 | 0.24 | 0.24 | 0.10 | 0.10 | 1.40 | 1.77 | 1.44 | 0.79 | 0.39 | 0.20
IKTS | 40 | 2.7 | 1.11 | 2.35 | 0.27 | 1.16 | 1.16 | 1.22 | 1.22 | 1.28 | 1.38 | 2.35 | 2.35 | 2.30 | 1.31 | 1.35 | 1.35 | 1.35 | 1.35 | 2.15 | 2.15 | 2.15 | 1.17 | 1.17 | 1.17 | 1.17 | 1.22 | 1.22 | 1.16 | 0.36 | 0.30 | 0.30 | 0.30 | 0.30 | 0.47 | 0.47 | 0.43 | 0.43 | 0.26 | 0.26 | 1.05 | 1.84 | 1.75 | 1.19 | 0.45 | 0.39
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

Sheet: Schedule
Task schedule with M24 freeze
Task | Task name | Start | End | M1 | M2 | M3 | M4 | M5 | M6 | M7 | M8 | M9 | M10 | M11 | M12 | M13 | M14 | M15 | M16 | M17 | M18 | M19 | M20 | M21 | M22 | M23 | M24 | M25 | M26 | M27 | M28 | M29 | M30 | M31 | M32 | M33 | M34 | M35 | M36
T1.1 | Coordination and technical decisions | 1 | 36 | 1 | 1 | 1 | 1 | 1 | 1 | 1 | 1 | 1 | 1 | 1 | 1 | 1 | 1 | 1 | 1 | 1 | 1 | 1 | 1 | 1 | 1 | 1 | 1 | 1 | 1 | 1 | 1 | 1 | 1 | 1 | 1 | 1 | 1 | 1 | 1
T1.2 | Data quality and reproducibility | 1 | 36 | 1 | 1 | 1 | 1 | 1 | 1 | 1 | 1 | 1 | 1 | 1 | 1 | 1 | 1 | 1 | 1 | 1 | 1 | 1 | 1 | 1 | 1 | 1 | 1 | 1 | 1 | 1 | 1 | 1 | 1 | 1 | 1 | 1 | 1 | 1 | 1
T1.3 | Resources and operational readiness | 1 | 36 | 1 | 1 | 1 | 1 | 1 | 1 | 1 | 1 | 1 | 1 | 1 | 1 | 1 | 1 | 1 | 1 | 1 | 1 | 1 | 1 | 1 | 1 | 1 | 1 | 1 | 1 | 1 | 1 | 1 | 1 | 1 | 1 | 1 | 1 | 1 | 1
T2.1 | Composition exploration and cycle fingerprints | 1 | 9 | 1 | 1 | 1 | 1 | 1 | 1 | 1 | 1 | 1 | 0 | 0 | 0 | 0 | 0 | 0 | 0 | 0 | 0 | 0 | 0 | 0 | 0 | 0 | 0 | 0 | 0 | 0 | 0 | 0 | 0 | 0 | 0 | 0 | 0 | 0 | 0
T2.2 | Reproducible production and mechanistic measurements | 4 | 18 | 0 | 0 | 0 | 1 | 1 | 1 | 1 | 1 | 1 | 1 | 1 | 1 | 1 | 1 | 1 | 1 | 1 | 1 | 0 | 0 | 0 | 0 | 0 | 0 | 0 | 0 | 0 | 0 | 0 | 0 | 0 | 0 | 0 | 0 | 0 | 0
T2.3 | Validation batches and ageing | 10 | 26 | 0 | 0 | 0 | 0 | 0 | 0 | 0 | 0 | 0 | 1 | 1 | 1 | 1 | 1 | 1 | 1 | 1 | 1 | 1 | 1 | 1 | 1 | 1 | 1 | 1 | 1 | 0 | 0 | 0 | 0 | 0 | 0 | 0 | 0 | 0 | 0
T3.1 | Two shaping routes and interface specification | 2 | 10 | 0 | 1 | 1 | 1 | 1 | 1 | 1 | 1 | 1 | 1 | 0 | 0 | 0 | 0 | 0 | 0 | 0 | 0 | 0 | 0 | 0 | 0 | 0 | 0 | 0 | 0 | 0 | 0 | 0 | 0 | 0 | 0 | 0 | 0 | 0 | 0
T3.2 | Manufacturing windows and transport parameters | 8 | 18 | 0 | 0 | 0 | 0 | 0 | 0 | 0 | 1 | 1 | 1 | 1 | 1 | 1 | 1 | 1 | 1 | 1 | 1 | 0 | 0 | 0 | 0 | 0 | 0 | 0 | 0 | 0 | 0 | 0 | 0 | 0 | 0 | 0 | 0 | 0 | 0
T3.3 | Independent cartridges and quality release | 16 | 25 | 0 | 0 | 0 | 0 | 0 | 0 | 0 | 0 | 0 | 0 | 0 | 0 | 0 | 0 | 0 | 1 | 1 | 1 | 1 | 1 | 1 | 1 | 1 | 1 | 1 | 0 | 0 | 0 | 0 | 0 | 0 | 0 | 0 | 0 | 0 | 0
T4.1 | Conservation models and identifiable experiments | 1 | 10 | 1 | 1 | 1 | 1 | 1 | 1 | 1 | 1 | 1 | 1 | 0 | 0 | 0 | 0 | 0 | 0 | 0 | 0 | 0 | 0 | 0 | 0 | 0 | 0 | 0 | 0 | 0 | 0 | 0 | 0 | 0 | 0 | 0 | 0 | 0 | 0
T4.2 | Reduced models and state estimation | 6 | 22 | 0 | 0 | 0 | 0 | 0 | 1 | 1 | 1 | 1 | 1 | 1 | 1 | 1 | 1 | 1 | 1 | 1 | 1 | 1 | 1 | 1 | 1 | 0 | 0 | 0 | 0 | 0 | 0 | 0 | 0 | 0 | 0 | 0 | 0 | 0 | 0
T4.3 | Prospective prediction and model correction | 18 | 34 | 0 | 0 | 0 | 0 | 0 | 0 | 0 | 0 | 0 | 0 | 0 | 0 | 0 | 0 | 0 | 0 | 0 | 1 | 1 | 1 | 1 | 1 | 1 | 1 | 1 | 1 | 1 | 1 | 1 | 1 | 1 | 1 | 1 | 1 | 0 | 0
T5.1 | Control baselines and common information | 3 | 12 | 0 | 0 | 1 | 1 | 1 | 1 | 1 | 1 | 1 | 1 | 1 | 1 | 0 | 0 | 0 | 0 | 0 | 0 | 0 | 0 | 0 | 0 | 0 | 0 | 0 | 0 | 0 | 0 | 0 | 0 | 0 | 0 | 0 | 0 | 0 | 0
T5.2 | Constrained RL for energy flow allocation | 8 | 24 | 0 | 0 | 0 | 0 | 0 | 0 | 0 | 1 | 1 | 1 | 1 | 1 | 1 | 1 | 1 | 1 | 1 | 1 | 1 | 1 | 1 | 1 | 1 | 1 | 0 | 0 | 0 | 0 | 0 | 0 | 0 | 0 | 0 | 0 | 0 | 0
T5.3 | Closed loop comparison and transfer | 20 | 34 | 0 | 0 | 0 | 0 | 0 | 0 | 0 | 0 | 0 | 0 | 0 | 0 | 0 | 0 | 0 | 0 | 0 | 0 | 0 | 1 | 1 | 1 | 1 | 1 | 1 | 1 | 1 | 1 | 1 | 1 | 1 | 1 | 1 | 1 | 0 | 0
T6.1 | Early instrumented reference platform | 1 | 8 | 1 | 1 | 1 | 1 | 1 | 1 | 1 | 1 | 0 | 0 | 0 | 0 | 0 | 0 | 0 | 0 | 0 | 0 | 0 | 0 | 0 | 0 | 0 | 0 | 0 | 0 | 0 | 0 | 0 | 0 | 0 | 0 | 0 | 0 | 0 | 0
T6.2 | Actuator ablation and component iterations | 7 | 22 | 0 | 0 | 0 | 0 | 0 | 0 | 1 | 1 | 1 | 1 | 1 | 1 | 1 | 1 | 1 | 1 | 1 | 1 | 1 | 1 | 1 | 1 | 0 | 0 | 0 | 0 | 0 | 0 | 0 | 0 | 0 | 0 | 0 | 0 | 0 | 0
T6.3 | Blinded integrated comparison | 23 | 34 | 0 | 0 | 0 | 0 | 0 | 0 | 0 | 0 | 0 | 0 | 0 | 0 | 0 | 0 | 0 | 0 | 0 | 0 | 0 | 0 | 0 | 0 | 1 | 1 | 1 | 1 | 1 | 1 | 1 | 1 | 1 | 1 | 1 | 1 | 0 | 0
T6.4 | Evidence consolidation and TRL 4 assessment | 31 | 36 | 0 | 0 | 0 | 0 | 0 | 0 | 0 | 0 | 0 | 0 | 0 | 0 | 0 | 0 | 0 | 0 | 0 | 0 | 0 | 0 | 0 | 0 | 0 | 0 | 0 | 0 | 0 | 0 | 0 | 0 | 1 | 1 | 1 | 1 | 1 | 1
T7.1 | Early dissemination exploitation and communication plan | 1 | 6 | 1 | 1 | 1 | 1 | 1 | 1 | 0 | 0 | 0 | 0 | 0 | 0 | 0 | 0 | 0 | 0 | 0 | 0 | 0 | 0 | 0 | 0 | 0 | 0 | 0 | 0 | 0 | 0 | 0 | 0 | 0 | 0 | 0 | 0 | 0 | 0
T7.2 | Manufacturing sustainability and economic boundaries | 7 | 32 | 0 | 0 | 0 | 0 | 0 | 0 | 1 | 1 | 1 | 1 | 1 | 1 | 1 | 1 | 1 | 1 | 1 | 1 | 1 | 1 | 1 | 1 | 1 | 1 | 1 | 1 | 1 | 1 | 1 | 1 | 1 | 1 | 0 | 0 | 0 | 0
T7.3 | Protected results and subsequent development | 12 | 36 | 0 | 0 | 0 | 0 | 0 | 0 | 0 | 0 | 0 | 0 | 0 | 1 | 1 | 1 | 1 | 1 | 1 | 1 | 1 | 1 | 1 | 1 | 1 | 1 | 1 | 1 | 1 | 1 | 1 | 1 | 1 | 1 | 1 | 1 | 1 | 1

Sheet: Sensitivity
Cost sensitivity to unconfirmed inputs
Equipment/facility/compute direct base |  |  | 274000
Change considered alone or combined | Personnel factor | Equipment/service factor | Added direct EUR | Result total EUR | Ceiling headroom EUR
Recommended | 0% | 0% | €0 | €2487225 | €12775
All personnel rates +5% | 5% | 0% | €72900 | €2578350 | -€78350
All personnel rates +10% | 10% | 0% | €145800 | €2669475 | -€169475
All equipment/facility/compute +10% | 0% | 10% | €27400 | €2521475 | -€21475
Personnel +5% and equipment/services +10% | 5% | 10% | €100300 | €2612600 | -€112600
Reference powder EUR200/kg | 200 |  | €10000 | €2499725 | €275
New production materials EUR300/kg | 300 |  | €9000 | €2498475 | €1525
Rig utility price +50% | 270 |  | €3690 | €2491837.5 | €8162.5
Maximum uniform personnel-rate increase within ceiling |  |  | 0.70%

Sheet: Checks
Reconciliation and design checks
Check | Residual or margin | Expected | Interpretation
Partner vs task PM | 0.000 | 0 | Zero
WP vs partner PM | 0.000 | 0 | Zero
WP vs partner budget | 0.000 | 0 | Zero
Ceiling headroom | 12775.000 | >=0 | Positive margin, not a reserve
Nominal 10 kW basis | 0.000 | 0 | Zero
Calculated duty margin | 0.500 | >=0 | Planning estimate only
Primary matrix run count | 0.000 | 0 | Zero
Rig hours | 0.000 | 0 | Zero
Production capacity margin | 828.000 | >=0 | Positive under access assumptions
New powder after 75% recovery | 15.000 | >=0 | Excludes 9 kg retained characterisation from minimum charge
Role PM vs partner PM | 0.000 | 0 | Zero
SAV Scientific coordinator peak | 0.043 | >=0
SAV Integration engineers peak | 0.108 | >=0
SAV Experimental technicians peak | 0.072 | >=0
SAV Project and data officer peak | 0.014 | >=0
SAV Synthesis scientist and technical operator peak | 0.293 | >=0
IRC Materials scientific lead peak | 0.042 | >=0
IRC Sorption and materials researchers peak | 0.457 | >=0
IRC Laboratory technicians peak | 0.303 | >=0
IKTS Shaping scientific lead peak | 0.048 | >=0
IKTS Process researchers peak | 0.090 | >=0
IKTS Manufacturing technicians peak | 0.213 | >=0
UP Modelling scientific lead peak | 0.071 | >=0
UP Dynamic modelling researchers peak | 0.192 | >=0
UP Research software engineer peak | 0.078 | >=0
HPE Control scientific lead peak | 0.122 | >=0
HPE Control and HIL researchers peak | 0.372 | >=0
