fredshuc/buildfly/dampers/c02-r21-rt2/RT2_FINDINGS.csv

ID | RT2_decision | Class | PN_instance_interface | Source | Minimal_counterexample_or_evidence | Affected_use | Smallest_change | Acceptance_evidence | Tag | Verified_in
RT2-F01 | RT2-01 | CONDITIONAL -> approve scoped manufacture | R21 index (172) / net BOM (220 rows) / classified gaps (88) | tables/R21_CURRENT_FACTORY_ENTRY_INDEX.csv; R21_NET_NEED_BOM.csv; R21_CLASSIFIED_GAPS.csv | No row with need != issued+unissued; no over-issue; no duplicate PN allocation; 94 station pieces excluded. Missing = 21 MAKE rows/78 pcs + 67 procurement rows/1,498 pcs | Release bookkeeping | Add supply_PN (FREE-state) mapping column to the factory index | Index rows with supply_PN; receiving inspection by serial | V | results_r21_bom_audit.json
RT2-F02 | RT2-01 | DECISION (procurement) | HW_N10 (20), HW_N3 (57), STD08B (48), H14_PIN5 (1), HW_R13_M4TIP (5), HW_R8_HOOD_W5 (8), HW_R9_HARD_W5 (12), HW_W4_1_9 (9) | tables/R21_PURCHASE_TECHNICAL_ENQUIRIES.csv | 160 of 1,301 small-hardware pieces do not match a named standard (e.g. HW_N10 s17 = DIN 980 not ISO 7042 s16; HW_N3 m4 = polyamide insert vs BOM all-metal; STD08B head 4.8x1.5 matches no ISO M3 head) | Fastener enquiry | One L1 decision per row; enquire the other 1,141 pcs by standard designation now | Supplier designation, grade, thread length b and sample per row | V | results_r21_fastener_map.csv
RT2-F03 | RT2-02 | CONDITIONAL -> proceed to coupons | F06 bevel_root; P100F/P100B/R100F/R100B | factory/mandatory_process/F06/R19_L1_F06_PROCESS_AND_SCOPE_OVERRIDES.json | prep 2.50+/-0.05 + root 0.50+/-0.05 must equal measured t: only t in 2.90..3.10 admissible and two toleranced features forced to a sum | Shell weld preparation | Control root face 0.50+/-0.05 and opening 1.00+/-0.05; record prep = t - root; keep retained wall >=2.90 | Coupon macro-sections per joint family at measured issued thickness | I | RT2_REVIEW.md 3/RT2-02
RT2-F04 | RT2-02 | CONDITIONAL | WS17 50 routes + 4 shell welds | F06 README; R17 structural screens | Route-by-route trials not needed: joints fall into about 3 families (3 mm bevel butt; sleeve-ring flush throat>=1.30; structural fillets a4/a5) | Weld qualification time | One coupon set per family/process/position from the actual heat; ISO 15614-1 range 0.7t..1.3t for t<=3 (edition to confirm) | Coupon sections accepted per family; first-piece measurements unchanged | R | RT2_REVIEW.md 3/RT2-02
RT2-F05 | RT2-02 | CODE-DEPENDENT | TF926 a4 x 20 side welds | EN 1993-1-8 4.5.1 (if chosen) | l_eff >= max(30, 6a) = 30 mm > 20 mm: no design credit under EN 1993-1-8 | WS17 retainer strength credit | Lengthen to >=30 mm or do not credit | Declared governing code; weld map | I | RT2_REVIEW.md 3/RT2-02
RT2-F06 | RT2-03 | MUST-FIX before rotor handling | ROT-P1/ROT-P2/ROT-R dry band Y -818..-808 on B200_001/002/003 | tables/R21_EXTERNAL_FIXTURE_PURCHASE_SPEC.csv; R20_PARTS B202_R18RAW notes; stage A1 | Dry band = B200 local Z 33.5..43.5 overlaps final grip Z0..43 (30h7 Ra0.8 BK2 seat) by 9.5 mm, contrary to A1 "no grip on BK2"; each of 6 glands must cross a band | First rotor support, gland threading | Between-centres support: re-cut DIN 332-1 centres in finished end faces; locking tailstock; Ø29.90 quill noses carrying pre-staged glands (no support opened). Fallback: move dry band to local Z 50..60 | Vendor drawing >=600 N/>=300 N per centre; surrogate gland-threading trial with centres engaged; runout to A on the same stand | V | RT2_REVIEW.md 3/RT2-03
RT2-F07 | RT2-04 | MUST-FIX before finite input | D886 (P2 spindle, Y -1147.5..-1098.5) outboard of 7206 at Y -1081.5..-1065.5; BUY504 mesh (G1); BUY520/BUY521 | R18_STOP_TO_SEAL_MAP.json; R14_TWO_PLANE_DEFLECTION_SENSITIVITY.json; native R20 P | Stop reaction tilts the gear axes: plane-of-action misalignment 3.3-4.1x mesh-only (soft k); G1 peak line load 0.87-1.00x catalogue at 78 Nm, 1.08-1.24x at 120 Nm (soft k); 0.61-0.78x (stiff k) | Planned torque, closing accuracy, G1 durability | Measure: limiter calibration (BUY520 100-120/<=150 dyn; BUY521 152-168/<=195 dyn); in-situ support k or loaded contact pattern; per-leaf blade-edge error at 5/10/20 Nm | k >= 1e5 N/mm or surrogate with measured k <= 1.0x catalogue at 150 Nm; extrapolated edge error + U <= measured seal reserve per leaf | V | results_r21_stop_gear_budget.json; results_r21_driveline_order_P.txt
RT2-F08 | RT2-04 | DESIGN (unreleased part) | D886 contact face vs TF900 head | R18 stop map (contact 50..80 mm) | Contact radius band 50..80 mm gives 2.6x spread in stop-induced edge error (0.072..0.184 mm at 78 Nm) | Closing accuracy | Crown D886 face (R~50) so contact sits at r~75: edge error ~0.082 mm at 78 Nm; bearing radial load -20% vs r=60; Hertz ~230 MPa at 200 Nm | L1 check of TF900 head and open stop; contact witness | I | RT2_REVIEW.md 3/RT2-04
RT2-F09 | RT2-05 | CONDITIONAL -> approve machining + unloaded mating | J404 (3.98-4.02 / pocket 1.48-1.52 / min 2.45); A709 (5.98-6.02 / 1.48-1.52 / 4.45) | F07_PRODUCT/R20_L1_F07_PROCESS_AND_SCOPE_OVERRIDES.json | Min-metal margin is 0.01 mm (2.46 vs 2.45; 4.46 vs 4.45): averaged measurement can pass a non-conforming point | Wet station machining | Pointwise (>=3 points) thickness and pocket depth; derive remaining metal per point; record station stack height and fixed/float by serial | Measured per-point records; preload/thermal proof remains separate | V | RT2_REVIEW.md 3/RT2-05
RT2-F10 | RT2-06 | MUST-FIX before film cutting | P109_001..004 / R109_001..004 end strips; end STD08B (8 per config) | R20_PARTS P109/P110; diagnostics/*_OPEN_SLOT_DIAGNOSTIC_ONLY.dxf | Brief 224.79/435 = frame end-strip area / full 87 mm nominal film width. Film material actually in the strip is 220.365 mm2 (39 mm corner relief); 214.235 (97.2%) frame-backed, 6.13 unbacked. Governing defect: Ø5 end hole tangent to the film end (zero ligament) | Film retention in motion | Keeper KP-1: 304, 46.774 x 7 x 0.8, Ø3.4 hole, under existing end screw (16 pcs) | Fit-up on frame offcut; pull-out vs clamp-only; keeper intersects only its STD08B; >=12.58 mm from moving bodies 0-90 deg | V | results_r21_film_keeper.json
RT2-F11 | RT2-06 | MUST-FIX (companion) | 16 end STD08B with HW_N3_* | results_r21_film_screw_protrusion.json | Protrusion 1.75 mm (3.5 pitches) drops to 0.95 mm (1.9 pitches) under a 0.8 mm keeper: fails F06 >=2 full pitches | Film end fastening | Lengthen the 16 end STD08B by 2 mm (M3x18 special) or 4 mm (x20); added tip clears all bodies (nearest own nut 1.75 mm) | Measured protrusion >=2 pitches on every end screw | V | results_r21_film_screw_extension.json; results_r21_film_screw_extension_4mm.json
RT2-F12 | RT2-07 | MUST-FIX before powered motion | A703P/A703R, A704R8, B850-B853, HW_R11_GUIDE_M5, A705-A710 | native R20 P/R; classified gaps | Contact graph closed in P and R (overlaps are threads only); missing are product allocation (60 pcs), A703 ear bending and body torsion calculations under 350-450 N per guide, and measured fulcrum/crown parameters | Root capture | Allocate product quantities; perform the two desk calculations; keep fulcrum/crown measurements as use-holds | Allocation in index; signed calculations | V | results_r21_root_contacts.json
RT2-F13 | RT2-07 | MUST-FIX (guards) | G901/G902 feedthroughs, G904-covered ports | R20_PARTS G901/G902 notes | Tool pose excludes hand/handle; reach not qualified | Powered motion | Use ISO 13857 opening/reach tables instead of CAD hand models; Ø36 port on Ø30 shaft = <=3 mm gap | Guard opening table per port | R | RT2_REVIEW.md 3/RT2-07
RT2-F14 | RT2-08 | CONDITIONAL | SP04 four heads (M1-M7) | tables/R21_SP04_APPLICATION_MISSING_EVIDENCE.csv | 1500 N example leaves U+O+M <= 300 N per head; O ~ (dF/dt) t_lat | SP04 test permit | State max loading rate (e.g. <=2,000 N/s at 50 ms latency for O<=100 N); mechanical stroke so k_head*stroke + F_pre <= 1800 N; synchronous unload steps <=10% | Surrogate (steel spring, k within +/-30%) demonstrating O_i, trip and dropout per channel | I | RT2_REVIEW.md 3/RT2-08
RT2-F15 | RT2-09 | MUST-FIX before maintenance | B200 rotor angular restraint; BK2; D870/D885/BUY520-521 dry group; D873 | native R20 parts (no rotor lock found) | No rotor angular lock exists; drive line is the only angular restraint | Input withdrawal | Hand-off H0-H5: isolate; rotor lock; dry-unit cradle; release BK2; withdraw along -Y; D873 on bench only; reverse with lock removed last | Lock part + cradle drawing with rating + surrogate trial of H2-H3 | R | RT2_REVIEW.md 3/RT2-09
RT2-F16 | RT2-10 | P2 | HW_R8_HOOD_W5, HW_R9_HARD_W5, HW_W4_1_9, STD08B, D873, G843 | current architecture | No factory measurement returned | Cost/lead time | Evidence-gated candidates only (ISO 7089 washers; catalogue low-head M3; KM6-class lock nut); G843 stays deferred | First-unit return per candidate | R | RT2_REVIEW.md 3/RT2-10
RT2-F17 | verification | INFO | P (1,506 inst.) and R (1,073 inst.) | native R20 | 0 motion overlaps at 41 positions; 0 cross-branch; 213 static overlaps all thread/set-screw; D886-TF900 0.0873/0.871/4.32 mm at 0.1/1/5 deg, 10.0 mm over 12.5-77.5 deg, 0.096 at 89.9 deg | RT-1 adoption | None | - | V | results_r21_check.json
