fredshuc/buildfly/dampers/c02-r16-rt1/RT1_FINDINGS.csv

ID | RT1_question | Class | PN_instance_interface | Source | Minimal_counterexample | Affected_use | Smallest_change | Acceptance_evidence | Tag | Verified_in
RT1-01 | Q1 | Must-fix before assembly | R16_P_R14_P_G901_001, R16_P_R14_P_TF909_001/003 vs P101/P106/P107/P107B/J401/STD03C; R analogues vs R101/R106/R107/J401/STD03C | evidence/R16_P_CROSS_BRANCH.json; R16_R_CROSS_BRANCH.json | G901 at Y -757.5..-754.5 lies inside the flange edge (-761) and the J401 glands; P has 22 pairs (49,997.6 mm3), R has 20 (39,148.8 mm3) | Fit-up of guard to wet valve | ECO-A: move G901 and the two wet-end TF909 posts -45.5 mm in world Y; shorten G900 x2 by 45.5 mm and re-drill; 2 new Ø9 holes in TF903 deck. No new PN. | 0 wet hits at 0/45/90 deg; measured stud tip >=3 mm from G901 after preload; G901 removed before gland service | V | results_r16_eco.json: ECO_A_guard_relocation
RT1-02 | Q1 | Must-fix before integrated R assembly | F621_001/002 vs R16_R_R14_R_TF903_001, TF906_001, TF909_001, G901_001 | evidence/R16_R_CROSS_BRANCH.json; native R16_R_OCCURRENCES.json | Rig deck front edge (Y -720.5) and crossmember overlap the fixture ribs (Y -761..-55); F622 feet sit at Z 1160 on a bench absent from the configuration, so the wet valve has no load path | R wet support | Bench fit-up only: trim F621 dry end to Y>=-715 (verified 0 hits). Integrated: replace F620-F623/P107B by a rig-mounted wet bay (see RT1-04). | Wet-bay drawing Boolean-checked; unloaded fit-up with BK2 offsets measured | V | results_r16_eco.json: ECO_B_R_F621_trim
RT1-03 | Q2 | Must-fix before motion | R16_P_R14_P_D886_001 (P2) vs R16_P_R14_P_TF900_001 | evidence/R16_P_DRY_MOTION.json; D886/TF900 notes | CW P2 sweep drives the arm into the start post: 6437.6 mm3 at 15 deg, 5277.3 at 30, 1194.3 at 45, 756.5 at 75, 1600.0 at 90 (0/45/90 sampling under-reports) | Any P motion | ECO-C: re-phase D886 +90 deg about P2 (keyway under arm root; second keyway by EDM if already machined, or D886 rev B). TF900 unchanged; end-post head becomes the closed stop. | 0 overlap at 0..90 deg in 15 deg steps; 0.000 mm contact at both ends; 10.0 mm travel clearance; then indexed <=5 deg or swept check on real parts; final stop angle gauged +-0.1 deg | V | results_r16_eco.json: ECO_C_P_stop_reindex
RT1-04 | Q3 | Must-fix before support/load transfer (L1 decision) | P rig frame TF903/TF905-908 (feet at X -1278); P wet valve; F600P fixture | native R16_P_OCCURRENCES.json; R14 44-row reactions | Side-lying rig: combined drive+frame CG 14.7 mm inside tipping edge -> ~69 N.m restoring vs 200 N.m static fault reaction; wet valve unsupported in model | P rig use | O1 (recommended for dry-chain programme): rotate P valve 90 deg about shaft axis; one horizontal rig pose shared with R; common rig-mounted wet bay. O2 (installed orientation): outriggers >=300 mm + anchors, re-run 44 rows with in-plane gravity, vertical mother-plate simulator. | Decision record; wet-bay drawing with keep-outs; tipping/anchor calc; BK2 offsets measured after clamping | V/C/R | results_r16_mass.json
RT1-05 | Q4 | Must-fix before installed root acceptance | P_ROOT_1/2_BACK_a4 vs F620_002; P107 host face X>=-335 | evidence/R16_P_ROOT_WELDS.json | 281.9218 mm3 each (unchanged since R11) | Installed P root; P weld access | Retire F620 from the integrated configuration via the wet bay with keep-out (support edge >=15 mm below shoe, >=20 mm torch corridor). Host boundary: obtain host interface drawing or build a host-simulator coupon to it; keep as a separate gate. | Wet-bay keep-out Boolean check; host drawing referenced; weld access demonstrated on coupon | V/S | R11 shift study (geometry unchanged)
RT1-06 | Q4 | Must-fix before installed root acceptance | G843_001 on R107 M8/F602 row | G843 notes; native | Single boss line carries moment about X by bolt preload over ~+-10 mm annulus; M8 tightening spec absent | R hood receiver | Keep G843 (clamped, no weld on R107). Add M8 row preload specification. P2: welded base+uprights machined after weld (92% stock removal today). | AM 250 N test: boss gap, gasket-land gap every <=50 mm, return to zero; achieved preload record | S/C
RT1-07 | Q5 | Controlled-test conditional | D874/D875 planes; BK2; J404 stack; gland studs; seal track | R14/R15 control rows | Diagnostic fixed-root/one-way models cannot close thermal compatibility or 1000 N mapping | Rig acceptance | Measure: two-plane spindle displacement; BK2 rim/face offsets cold/hot; J404 axial stack compliance; four simultaneous stud forces with uncertainty (sets guard band below 1800 N); seal gap every <=50 mm; leakage separately | Each quantity against its named screen; force, leakage and contact kept as separate records | R
RT1-08 | Q6 | Must-fix before maintenance | D875 85 mm withdrawal; D873 nut access | R16_REAR_PLATE_PATH_COUNTEREXAMPLES.json; R16_ACTUAL_NUT_TOOL_ACCESS.json | All blockers are removable dry-rig parts (screws, D879 caps, 7206, TF900, D885/D886/D888, BUY520+M6, BK2, D890/D892/D893); no cyclic precedence in the supplied cases | Service route | Write a precedence table with a captured load per step; add a wet-rotor lock at the BK2 wet hub rated for the 500 N handling case before removing stop arms | Dry run on the unloaded rig following the table | S/R
RT1-09 | Q7 | Must-fix before claiming complete kit | 208 PN / ~2,200 pcs P1 kit | tables/R16_CONFIGURED_MANUFACTURING_GAPS.csv | Releases cover 335 pcs; 41 stable wet-valve/feedback-frame PN (315 pcs) and 50 commodity PN (1,038 pcs) are unreleased though untouched by R16 conflicts | Kit completeness / schedule | Release W1 (41 PN, BRep identical R11->R16) and authorize commodity hardware; RFQ the 9 critical bought items; define shell weldments (P100F/B, R100F/B/S) and the B200_R13 weld spec; extend gland parts after SP04 FAI | Release index updated; first-article dims for W1; supplier confirmations | V | results_r16_release_waves.csv
RT1-10 | Q8 | P2 | G843, G840P, motion sampling | native; R16 motion scripts | G843 ~92% stock removal; 0/45/90 sampling missed 15/30 deg overlaps | Cost/robustness | G843 welded+machined; formed-angle beams once P root settled; adopt <=5 deg or swept-volume motion checks now (not deferred) | Factory quote; swept check report | C/V
