fredshuc/buildfly/dampers/c02-r21-rt2/results/results_r21_fastener_map.csv

PN | net_need | material | proposed_designation | status | note
H14_M10X45 | 4 | 8.8 | ISO4762 class8.8 M10x45 | STANDARD_NAMED_IN_NOTES
H14_M12X110 | 2 | 8.8 | ISO4762 class8.8 M12x110 | STANDARD_NAMED_IN_NOTES
H14_M16X110 | 8 | 8.8 | ISO4762 class8.8 M16x110 | STANDARD_NAMED_IN_NOTES
H14_M16X90 | 4 | 8.8 | ISO4762 class8.8 M16x90 | STANDARD_NAMED_IN_NOTES
H14_M4X12 | 8 | 8.8 | ISO4762 class8.8 M4x12 | STANDARD_NAMED_IN_NOTES
H14_M5X10 | 20 | 8.8 | ISO4762 class8.8 M5x10 | STANDARD_NAMED_IN_NOTES
H14_M6X20 | 16 | Class12.9 | ISO4762 M6x20 class12.9 for Mayr flanges | STANDARD_NAMED_IN_NOTES
H14_M8X25 | 2 | 8.8 | ISO4762 class8.8 M8x25 | STANDARD_NAMED_IN_NOTES
H14_M8X30 | 4 | 8.8 | ISO4762 class8.8 M8x30 | STANDARD_NAMED_IN_NOTES
H14_M8X40 | 2 | 8.8 | ISO4762 class8.8 M8x40 | STANDARD_NAMED_IN_NOTES
H14_N16 | 12 | Class8 | ISO4032 M16 class8 | STANDARD_NAMED_IN_NOTES
H14_N4 | 4 | Class8 | ISO4032M4class8 plusprevailinglockorwitness | STANDARD_NAMED_IN_NOTES
H14_PIN5 | 1 | C45 |  | NEEDS_DECISION
H14_SPLIT | 1 | Stainless | ISO1234 splitpin1.6x12 | STANDARD_NAMED_IN_NOTES
H14_W16 | 24 | 200HV | ISO7089 washer 30/17x3 | STANDARD_NAMED_IN_NOTES
H14_W4 | 4 | 200HV | ISO7089 washer 9/4.3x1.2 | STANDARD_NAMED_IN_NOTES
H14_W8 | 14 | 200HV | ISO7089 washer 16/8.4x1.6 | STANDARD_NAMED_IN_NOTES
H17_M10X120 | 4 | Class8.8 | ISO4762M10x120 | STANDARD_NAMED_IN_NOTES
H17_M10X45 | 8 | Class8.8 | ISO4762M10x45 | STANDARD_NAMED_IN_NOTES
H17_M8X35 | 2 | Class8.8 | ISO4762M8x35 | STANDARD_NAMED_IN_NOTES
H17_M8X45 | 2 | Class8.8 | ISO4762M8x45 | STANDARD_NAMED_IN_NOTES
HW_BELLOWS25 | 6 | A4-80 | ISO 4762 M2.5x8 A4-80 | MATCHES_ISO4762 | CAD full thread: confirm standard thread length b covers required engagement
HW_ENCODER_M4 | 9 | A4-80 | ISO 4762 M4x12 A4-80 | MATCHES_ISO4762 | CAD full thread: confirm standard thread length b covers required engagement
HW_FB_COVER_M4 | 8 | A4-80 | ISO 4762 M4x10 A4-80 | MATCHES_ISO4762 | CAD full thread: confirm standard thread length b covers required engagement
HW_FB_FRONT | 12 | A4-80 | ISO 4762 M5x16 A4-80 | MATCHES_ISO4762 | CAD full thread: confirm standard thread length b covers required engagement
HW_FB_REAR | 12 | A4-80 | ISO 4762 M5x16 A4-80 | MATCHES_ISO4762 | CAD full thread: confirm standard thread length b covers required engagement
HW_FLEX_M3 | 24 | A4-80 | ISO 4762 M3x6 A4-80 | MATCHES_ISO4762 | CAD hex 2 vs ISO 2.5 (envelope only); CAD full thread: confirm standard thread length b covers required engagement
HW_N10 | 4 | A4-80 |  | NEEDS_DECISION | M10 m10 s17: no ISO 7042 size (BOM says all-metal lock nut); choose standard
HW_N10 | 16 | A4-80 |  | NEEDS_DECISION | M10 m10 s17: no ISO 7042 size (BOM says all-metal lock nut); choose standard
HW_N3 | 57 | A4-80 |  | NEEDS_DECISION | M3 m4 s5.5: height matches a polyamide-insert nut (e.g. ISO 10511/DIN 985), BOM says all-metal lock nut; decide
HW_N6 | 85 | A4-80 | ISO 7042 M6 A4-80 (all-metal prevailing torque) | MATCHES_ISO7042
HW_N8 | 2 | A4-80 | ISO 7042 M8 A4-80 (all-metal prevailing torque) | MATCHES_ISO7042
HW_N8 | 60 | A4-80 | ISO 7042 M8 A4-80 (all-metal prevailing torque) | MATCHES_ISO7042
HW_R12_M8X40 | 5 | A4-80 | ISO 4762 M8x40 A4-80 | MATCHES_ISO4762
HW_R13_M10X45 | 6 | 8.8 | ISO4762 class8.8 M10x45 | STANDARD_NAMED_IN_NOTES
HW_R13_M12X80 | 2 | 8.8 | ISO4762 class8.8 M12x80 | STANDARD_NAMED_IN_NOTES
HW_R13_M4TIP | 5 | Steel/brass |  | NEEDS_DECISION
HW_R13_M5X20 | 16 | 8.8 | ISO4762 class8.8 M5x20 | STANDARD_NAMED_IN_NOTES
HW_R13_N12 | 4 | Class8 | ISO4032 M12class8 | STANDARD_NAMED_IN_NOTES
HW_R13_W10 | 26 | 200HV | ISO7089 hardened washer OD20/ID10.5x2. | STANDARD_NAMED_IN_NOTES
HW_R13_W12 | 8 | 200HV | ISO7089 hardened washer OD24/ID13x2.5. | STANDARD_NAMED_IN_NOTES
HW_R8_HOOD_M5 | 8 | A4-80 | ISO 4762 M5x16 A4-80 | MATCHES_ISO4762
HW_R8_HOOD_W5 | 8 | EN 1.4307 / 304L |  | NEEDS_DECISION | 10/5.5x1 not ISO 7089 nominal (custom tolerance/material in notes)
HW_R9_HARD_W5 | 12 | 17-4PH H900 |  | NEEDS_DECISION | 10/5.5x1 not ISO 7089 nominal (custom tolerance/material in notes)
HW_W10_2_20 | 32 | A4 | ISO 7089 M10 A4 | MATCHES_ISO7089
HW_W3_0p5_7 | 90 | A4 | ISO 7089 M3 A4 | MATCHES_ISO7089 | CAD id 3.5 vs ISO 3.2
HW_W4_0p8_9 | 8 | A4 | ISO 7089 M4 A4 | MATCHES_ISO7089 | CAD id 4.5 vs ISO 4.3
HW_W4_1_9 | 9 | A4 |  | NEEDS_DECISION | 9/4.5x1 not ISO 7089 nominal
HW_W5_1_10 | 44 | A4 | ISO 7089 M5 A4 | MATCHES_ISO7089 | CAD id 5.5 vs ISO 5.3
HW_W6_1p6_12 | 122 | A4 | ISO 7089 M6 A4 | MATCHES_ISO7089 | CAD id 6.5 vs ISO 6.4
HW_W8_1p6_16 | 152 | A4 | ISO 7089 M8 A4 | MATCHES_ISO7089 | CAD id 8.5 vs ISO 8.4
STD01B | 46 | A4-80 | ISO 4762 M8x25 A4-80 | MATCHES_ISO4762 | CAD full thread: confirm standard thread length b covers required engagement
STD01C | 9 | A4-80 | ISO 4762 M8x45 A4-80 | MATCHES_ISO4762 | CAD full thread: confirm standard thread length b covers required engagement
STD01P | 28 | A4-80 | ISO 4762 M8x16 A4-80 | MATCHES_ISO4762 | CAD full thread: confirm standard thread length b covers required engagement
STD02B | 58 | A4-80 | ISO 7380-1 M6x20 A4-80 | MATCHES_ISO7380 | confirm stainless property class offered for ISO 7380 (A4-70 more common than A4-80)
STD06B | 20 | A4-80 | ISO 4762 M5x12 A4-80 | MATCHES_ISO4762 | CAD full thread: confirm standard thread length b covers required engagement
STD07B | 78 | A4-80 | ISO 4762 M2x12 A4-80 | MATCHES_ISO4762 | CAD full thread: confirm standard thread length b covers required engagement
STD08B | 48 | A4-80 |  | NEEDS_DECISION | head 4.8x1.5 not ISO 4762 M3 (5.5, 3) nor ISO 7380
STD14B | 16 | A4-80 | ISO 4762 M10x50 A4-80 | MATCHES_ISO4762 | CAD full thread: confirm standard thread length b covers required engagement
