fredshuc/buildfly/mat-prod/03_budget/CSV/Validation_Matrix.csv

planned_run_id | material | route | group | condition | policy | active_dry_mof_kg | module_nominal_kW | target_duty_kW | service_hours | reset_hours | setup_hours | total_hours | status
PLAN-REFERENCE-GRANULE-A-C09-FIXED | REFERENCE | GRANULE | A | C09 | FIXED | 20 | 10 | 10.0 | 4 | 2 | 2 | 8 | PLANNED_NOT_RUN
PLAN-REFERENCE-GRANULE-A-C09-MPC | REFERENCE | GRANULE | A | C09 | MPC | 20 | 10 | 10.0 | 4 | 2 | 2 | 8 | PLANNED_NOT_RUN
PLAN-REFERENCE-GRANULE-A-C09-RL | REFERENCE | GRANULE | A | C09 | RL | 20 | 10 | 10.0 | 4 | 2 | 2 | 8 | PLANNED_NOT_RUN
PLAN-REFERENCE-GRANULE-A-C10-FIXED | REFERENCE | GRANULE | A | C10 | FIXED | 20 | 10 | 10.0 | 4 | 2 | 2 | 8 | PLANNED_NOT_RUN
PLAN-REFERENCE-GRANULE-A-C10-MPC | REFERENCE | GRANULE | A | C10 | MPC | 20 | 10 | 10.0 | 4 | 2 | 2 | 8 | PLANNED_NOT_RUN
PLAN-REFERENCE-GRANULE-A-C10-RL | REFERENCE | GRANULE | A | C10 | RL | 20 | 10 | 10.0 | 4 | 2 | 2 | 8 | PLANNED_NOT_RUN
PLAN-REFERENCE-GRANULE-A-C11-FIXED | REFERENCE | GRANULE | A | C11 | FIXED | 20 | 10 | 7.0 | 4 | 2 | 2 | 8 | PLANNED_NOT_RUN
PLAN-REFERENCE-GRANULE-A-C11-MPC | REFERENCE | GRANULE | A | C11 | MPC | 20 | 10 | 7.0 | 4 | 2 | 2 | 8 | PLANNED_NOT_RUN
PLAN-REFERENCE-GRANULE-A-C11-RL | REFERENCE | GRANULE | A | C11 | RL | 20 | 10 | 7.0 | 4 | 2 | 2 | 8 | PLANNED_NOT_RUN
PLAN-REFERENCE-GRANULE-A-C12-FIXED | REFERENCE | GRANULE | A | C12 | FIXED | 20 | 10 | 8.0 | 4 | 2 | 2 | 8 | PLANNED_NOT_RUN
PLAN-REFERENCE-GRANULE-A-C12-MPC | REFERENCE | GRANULE | A | C12 | MPC | 20 | 10 | 8.0 | 4 | 2 | 2 | 8 | PLANNED_NOT_RUN
PLAN-REFERENCE-GRANULE-A-C12-RL | REFERENCE | GRANULE | A | C12 | RL | 20 | 10 | 8.0 | 4 | 2 | 2 | 8 | PLANNED_NOT_RUN
PLAN-REFERENCE-GRANULE-B-C09-FIXED | REFERENCE | GRANULE | B | C09 | FIXED | 20 | 10 | 10.0 | 4 | 2 | 2 | 8 | PLANNED_NOT_RUN
PLAN-REFERENCE-GRANULE-B-C09-MPC | REFERENCE | GRANULE | B | C09 | MPC | 20 | 10 | 10.0 | 4 | 2 | 2 | 8 | PLANNED_NOT_RUN
PLAN-REFERENCE-GRANULE-B-C09-RL | REFERENCE | GRANULE | B | C09 | RL | 20 | 10 | 10.0 | 4 | 2 | 2 | 8 | PLANNED_NOT_RUN
PLAN-REFERENCE-GRANULE-B-C10-FIXED | REFERENCE | GRANULE | B | C10 | FIXED | 20 | 10 | 10.0 | 4 | 2 | 2 | 8 | PLANNED_NOT_RUN
PLAN-REFERENCE-GRANULE-B-C10-MPC | REFERENCE | GRANULE | B | C10 | MPC | 20 | 10 | 10.0 | 4 | 2 | 2 | 8 | PLANNED_NOT_RUN
PLAN-REFERENCE-GRANULE-B-C10-RL | REFERENCE | GRANULE | B | C10 | RL | 20 | 10 | 10.0 | 4 | 2 | 2 | 8 | PLANNED_NOT_RUN
PLAN-REFERENCE-GRANULE-B-C11-FIXED | REFERENCE | GRANULE | B | C11 | FIXED | 20 | 10 | 7.0 | 4 | 2 | 2 | 8 | PLANNED_NOT_RUN
PLAN-REFERENCE-GRANULE-B-C11-MPC | REFERENCE | GRANULE | B | C11 | MPC | 20 | 10 | 7.0 | 4 | 2 | 2 | 8 | PLANNED_NOT_RUN
PLAN-REFERENCE-GRANULE-B-C11-RL | REFERENCE | GRANULE | B | C11 | RL | 20 | 10 | 7.0 | 4 | 2 | 2 | 8 | PLANNED_NOT_RUN
PLAN-REFERENCE-GRANULE-B-C12-FIXED | REFERENCE | GRANULE | B | C12 | FIXED | 20 | 10 | 8.0 | 4 | 2 | 2 | 8 | PLANNED_NOT_RUN
PLAN-REFERENCE-GRANULE-B-C12-MPC | REFERENCE | GRANULE | B | C12 | MPC | 20 | 10 | 8.0 | 4 | 2 | 2 | 8 | PLANNED_NOT_RUN
PLAN-REFERENCE-GRANULE-B-C12-RL | REFERENCE | GRANULE | B | C12 | RL | 20 | 10 | 8.0 | 4 | 2 | 2 | 8 | PLANNED_NOT_RUN
PLAN-REFERENCE-GRANULE-C-C09-FIXED | REFERENCE | GRANULE | C | C09 | FIXED | 20 | 10 | 10.0 | 4 | 2 | 2 | 8 | PLANNED_NOT_RUN
PLAN-REFERENCE-GRANULE-C-C09-MPC | REFERENCE | GRANULE | C | C09 | MPC | 20 | 10 | 10.0 | 4 | 2 | 2 | 8 | PLANNED_NOT_RUN
PLAN-REFERENCE-GRANULE-C-C09-RL | REFERENCE | GRANULE | C | C09 | RL | 20 | 10 | 10.0 | 4 | 2 | 2 | 8 | PLANNED_NOT_RUN
PLAN-REFERENCE-GRANULE-C-C10-FIXED | REFERENCE | GRANULE | C | C10 | FIXED | 20 | 10 | 10.0 | 4 | 2 | 2 | 8 | PLANNED_NOT_RUN
PLAN-REFERENCE-GRANULE-C-C10-MPC | REFERENCE | GRANULE | C | C10 | MPC | 20 | 10 | 10.0 | 4 | 2 | 2 | 8 | PLANNED_NOT_RUN
PLAN-REFERENCE-GRANULE-C-C10-RL | REFERENCE | GRANULE | C | C10 | RL | 20 | 10 | 10.0 | 4 | 2 | 2 | 8 | PLANNED_NOT_RUN
PLAN-REFERENCE-GRANULE-C-C11-FIXED | REFERENCE | GRANULE | C | C11 | FIXED | 20 | 10 | 7.0 | 4 | 2 | 2 | 8 | PLANNED_NOT_RUN
PLAN-REFERENCE-GRANULE-C-C11-MPC | REFERENCE | GRANULE | C | C11 | MPC | 20 | 10 | 7.0 | 4 | 2 | 2 | 8 | PLANNED_NOT_RUN
PLAN-REFERENCE-GRANULE-C-C11-RL | REFERENCE | GRANULE | C | C11 | RL | 20 | 10 | 7.0 | 4 | 2 | 2 | 8 | PLANNED_NOT_RUN
PLAN-REFERENCE-GRANULE-C-C12-FIXED | REFERENCE | GRANULE | C | C12 | FIXED | 20 | 10 | 8.0 | 4 | 2 | 2 | 8 | PLANNED_NOT_RUN
PLAN-REFERENCE-GRANULE-C-C12-MPC | REFERENCE | GRANULE | C | C12 | MPC | 20 | 10 | 8.0 | 4 | 2 | 2 | 8 | PLANNED_NOT_RUN
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
PLAN-NEW-CONDUCTIVE-C-C12-MPC | NEW | CONDUCTIVE | C | C12 | MPC | 20 | 10 | 8.0 | 4 | 2 | 2 | 8 | PLANNED_NOT_RUN
PLAN-NEW-CONDUCTIVE-C-C12-RL | NEW | CONDUCTIVE | C | C12 | RL | 20 | 10 | 8.0 | 4 | 2 | 2 | 8 | PLANNED_NOT_RUN
