fredshuc/buildfly/mat-prod/QA/Layout/Excel_Costs.png

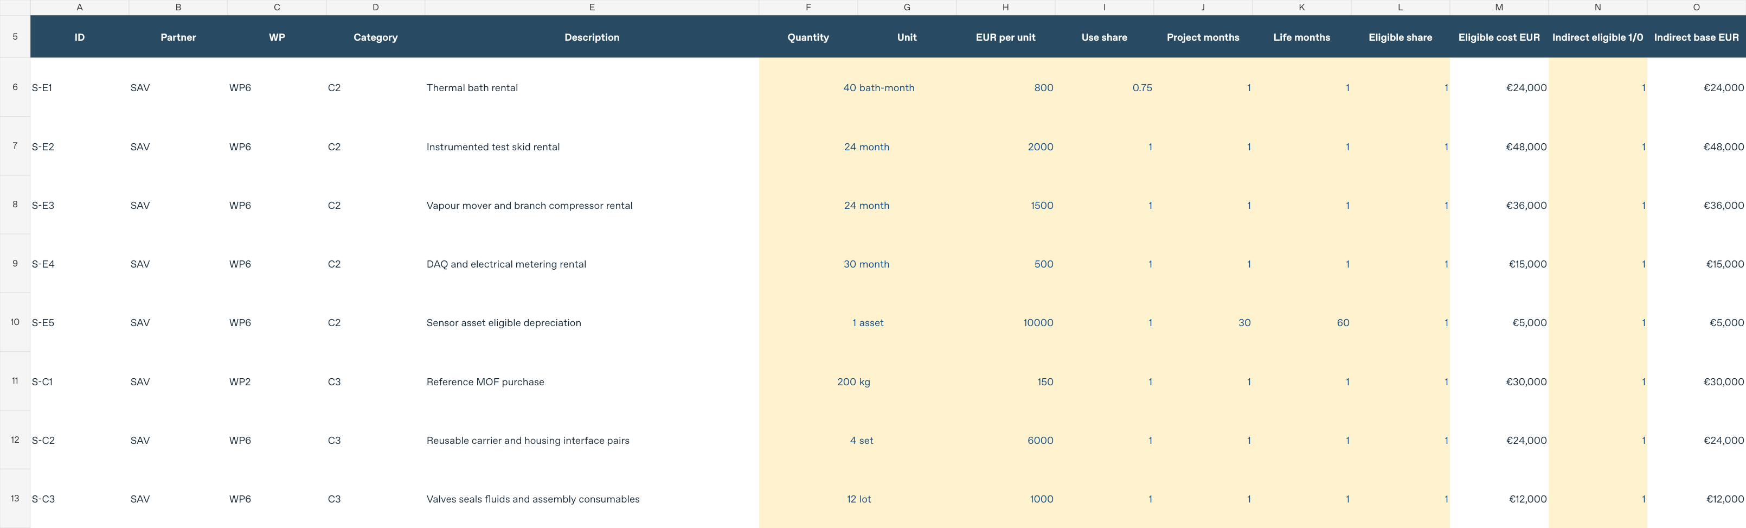
mat-prod/QA/Layout/Excel_Costs.png
