fredshuc/buildfly/AirTransformerShell/references/four-core-outdoor/V050_SM_M2_IN1_R1_OUTDOOR_SHEET_METAL_ONLY.stp

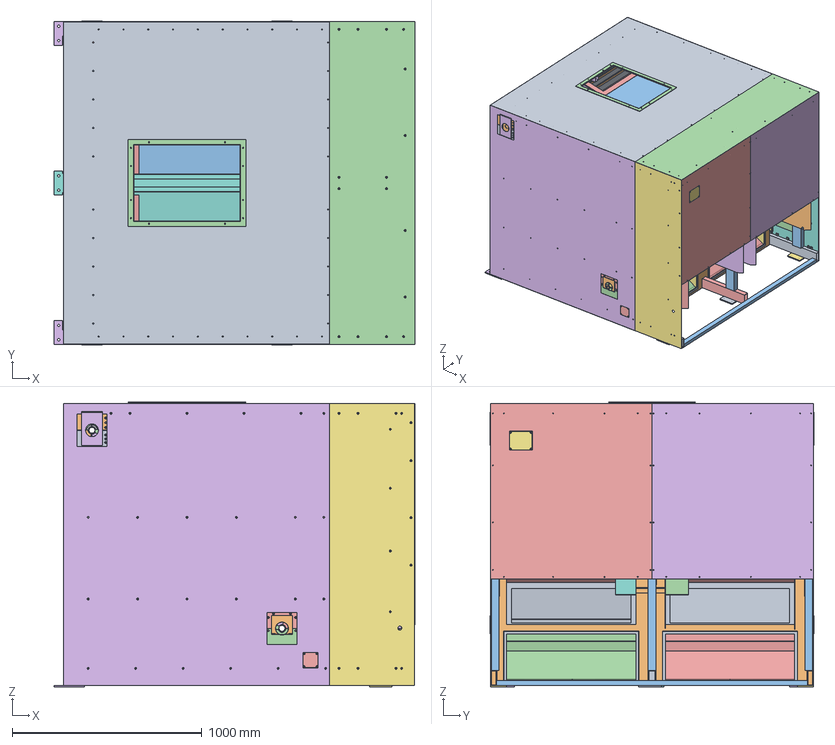
[picture p12: CAD file, 2026-11-06]
AirTransformerShell/references/four-core-outdoor/V050_SM_M2_IN1_R1_OUTDOOR_SHEET_METAL_ONLY.stp
1900.0 x 1706.0 x 1499.8 mm
