fredshuc/buildfly/(list of files, cad)

Other CAD files:
HX/M101_D952_P254_220_39x6_C04/M101_D952_P254_220_39x6_C04_TWO_CORES.step
HX/M101_D952_P254_220_39x6_C04/M101_D952_P254_220_39x6_C04.step
