fredshuc/buildfly/mat-prod/QA/QA_Results_CN.md

# 一致性检查结果

任务 MAT61-L2-S3-T01-R1，10 kW版。

状态 **PASS**；148/148项通过。

检查包括：任务/ID/日期/责任、逐层PM和成本、角色峰值、早期交付、36个月依赖、10 kW库存与水/蒸汽流量、93次合成及粉体平衡、M23前产能、144完整运行矩阵、风险字段、原模板哈希、Word字号/内容及Excel公式。

Excel另有两个真实改输入→重算→恢复测试：Savery费率增加€1/PM使总额增加€97.50；实验室电价增加€1/MWh使总额增加€51.25。公式错误扫描零命中。没有执行Microsoft Excel界面复核；使用公式引擎及保存文件结构/缓存校核。

这些是设计与文件检查，不是设备测试或伙伴能力确认。剩余执行前提见设计假设和L2回件。
