fredshuc/buildfly/mat-prod/QA/Self_Review_CN.md

# L2 一次自审及处置记录

任务 MAT61-L2-S3-T01-R1；日期2026-11-06；单模块10 kW；本L2自审，无独立外部评审或实测结果。

结论：完整设计候选可交L1审查。设计、计算和文件验收通过；人员、设施、成本及提交模板的事实核实仍是正式申请定稿的前提。不能将设计角色闭合写成现实能力均已落实。

| 审查点 | 发现与处置 | 结论／剩余边界 |
| --- | --- | --- |
| 科学链 | 组成和重复生产、两类主成型、非平衡传递与状态估计、MPC/RL、整机实验均分配了任务／PM；保留三来源的科学问题及可证伪比较 | 通过；原申请目标均未写成已实现成果 |
| 单Module尺度 | 按用户10 kW修订，20 kg active dry MOF／模块，600 s每床完整循环，约1.72 m3/h服务水路，约25 kW源热、200–300 m3/h蒸汽路径 | 通过；0.15 swing、2.8 MJ/kg、0.75利用因子是估计，0.08 swing仅5.6 kW |
| 实物与粉体 | 12套两床内件分别20 kg active MOF，合计240 kg；一个共用机械模块，不是12台设备；新材料180 kg生产、153 kg回收，120 kg装填+9 kg表征+24 kg留存／返工；基准200 kg | 通过；原料价格、产率和真实制造窗口须核实 |
| 生产节奏 | M12定生产配方，M13–M23 Savery单线1,980 h对1,152 h；M24留最终成型／验收；A/B/C组按M19/21/23释放 | 通过但生产窗口余828 h，若早期批次共线重叠则须扣除占用；设备／人员是关键事实缺口，不是已有预约 |
| 验证矩阵 | 自审发现原四个final工况未保留名义点，而T6.4要求从主矩阵取名义重复；已把C09设为55/25/70 C、10 kW及留出准备历史，C10–C12保留边界／历史迁移 | 已修正；144行和1152h不增加；独立脚本新增名义点检查 |
| 独立性和检出力 | 3个不相交批次／装配block；同组策略／历史配对，时间点非独立；95%配对t半宽约2.48倍组间SD，5%散布时约12.4% | 通过；不承诺能检出很小的增益，RL可不超过MPC |
| 公平比较和损失 | 固定周期、MPC、RL共同观测／动作／预测；各有调参和物理历史；全复位及自有电功计入，边界浴电耗单列避免源热重复计数 | 通过；不等热服务只报可行域差异 |
| 时序 | 台架和模型M1、控制M3、成型M2即启动；M24冻结；M25–32主验证、M33–34返工、M35–36迁移和证据；两条关键链均到M24 | 通过；所有关键活动零数学浮时，返工两月是已分配工作，并非免费缓冲 |
| PM与负荷 | 22任务→7WP→5伙伴均合计224 PM，逐月积分一致；角色按比例检查峰值并为超1 FTE角色分配至少两人 | 通过；具名人员真实排程仍须替代比例化负荷 |
| 预算与敏感性 | €2,487,225，距€2.50m余€12,775；无预备费；人员+5%已超限，人员+5%且定义设备／设施／算力基数+10%需€2,612,600 | 通过计算；预算鲁棒性低，实际费率／报价必须闭合后才能表示同意额度 |
| 模板与来源 | 原RTF V5.1字节及SHA256保持；3.1a–h表字段、设备15%人员费阈值已对照；源码日志区分完整原件、科学extract、decision与未取得正文 | 通过读取范围；未取得专项登录会话最终模板／标签及最新DOE R10prime科学主文件 |
| 排版与文件 | 修正图标签、标题孤行、表行跨页、过小字号及单行图例整页；Word最终22页、正文／表格≥11pt，A4 16mm边距；8个正式来源超链接 | 通过；整份Part B 40页总分配仍须在全稿整合时处理，不能压缩字号 |
| Git与信息边界 | 回读远端基线并在同一mat-prod工作区建受控分支；仓库为public，完整方案未公开；原生push无凭据、connector创建tree/ref均403 | 已完成本地版本和私有回件；未推送，不宣称Git写连接完全恢复 |

自动检查结果以qa_results.json为准。Excel另完成费率／电价修改、公式重算和恢复；不是Microsoft Excel界面或设备验证。确认项集中在Design_Decisions_and_Assumptions_CN.md，无需为完成本设计重新选择联合体或科学主线。
