fredshuc/buildfly/mat-prod/QA/Visual_Review_CN.md

# 版式复核记录

任务 MAT61-L2-S3-T01-R1；2026-11-06。

Word已通过LibreOffice渲染为22页PDF。逐页检查全部页面的边界、分页、表头重复、表行完整性、图与图注位置和页码；接口、修改过的WP描述、里程碑、PM／预算并排页及3.2／参考文献另以完整页面查看。QA/Layout/Word_contact-1至4为本次最终版的复核索引。未发现文字裁切、图标签溢出、表格越界或空白页；连续的PM和预算表已在同一横向页容纳。标准A4纸，纵／横向按表宽设置，四边16mm；正文和表格均至少11pt，图注／图中文字独立可读。

Excel的9张工作表均已渲染并检查，留有10张范围预览：Summary两张，另Assumptions、Tasks、Cost lines、Workload、Monthly FTE、Schedule、Sensitivity、Checks各一张。输入浅黄色／蓝字，计算与输出有分隔；金额、单位和负荷可读。另以保存后的XML核对全部公式与缓存，无公式错误。完成Savery人员费率和台架电价两个输入传播／恢复测试。未执行Microsoft Excel界面复核。

PDF和这些图片用于排版检查，不是Portal上传、设备试验或伙伴批准证据。最终提交会话模板和整份Part B页数须在全稿整合时重新核对。

| 文件 | SHA256 |
| --- | --- |
| 01_proposal/Section3_Implementation_EN.docx | d1bf29048d40a84747bc141c3b7d20755ce03b5a9f35cfeb8b463009eec187ba |
| 01_proposal/Section3_Implementation_EN.pdf | 3459ff6789ee28c652555261628c3e91deac7ed754f1b7733bf64b61e1399db4 |
| 03_budget/Implementation_Resources.xlsx | 3d6643c5dec309e33ec02604de0d0d7e0111b802cb1cd6ad55f604eb3ebb58da |
