fredshuc/buildfly/mat-prod/QA/Layout/Excel_Assumptions.png

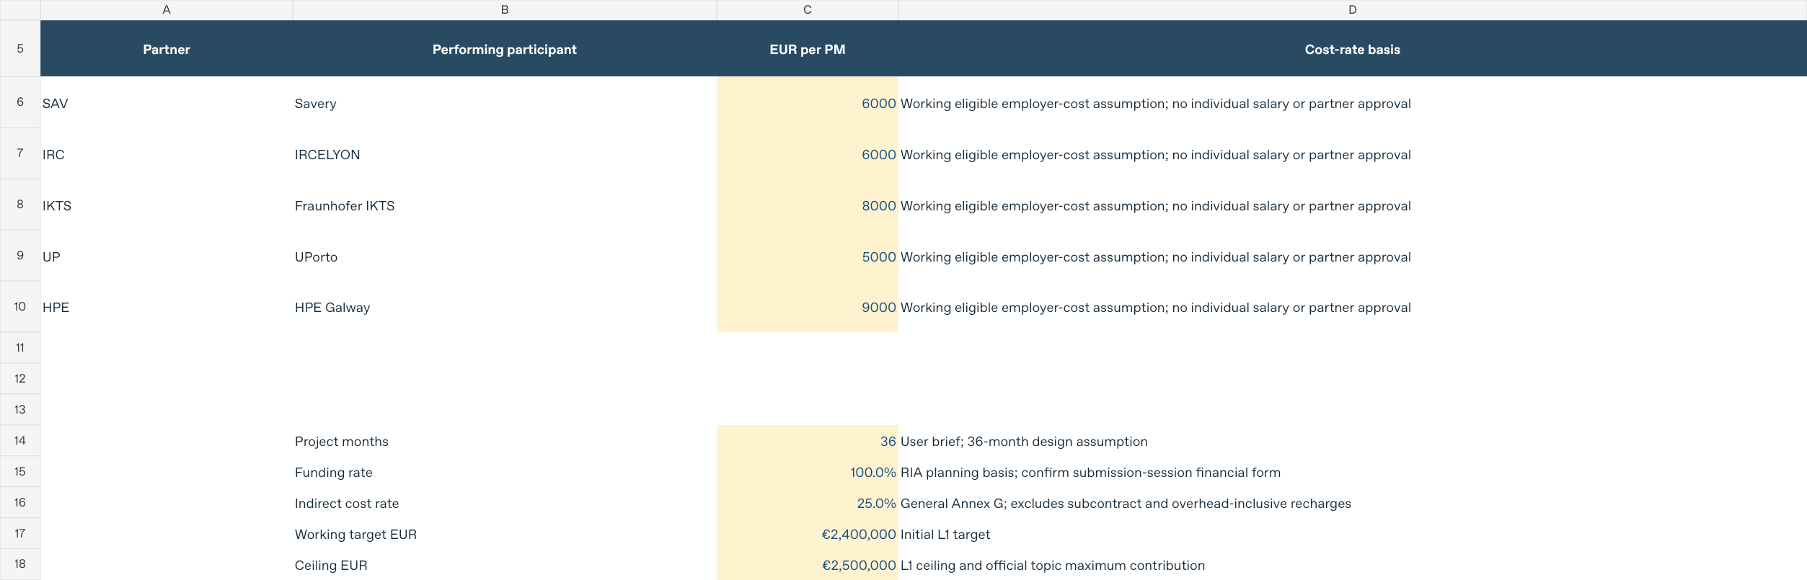
mat-prod/QA/Layout/Excel_Assumptions.png
