fredshuc/buildfly/mat-prod/QA/Layout/Excel_Checks.png

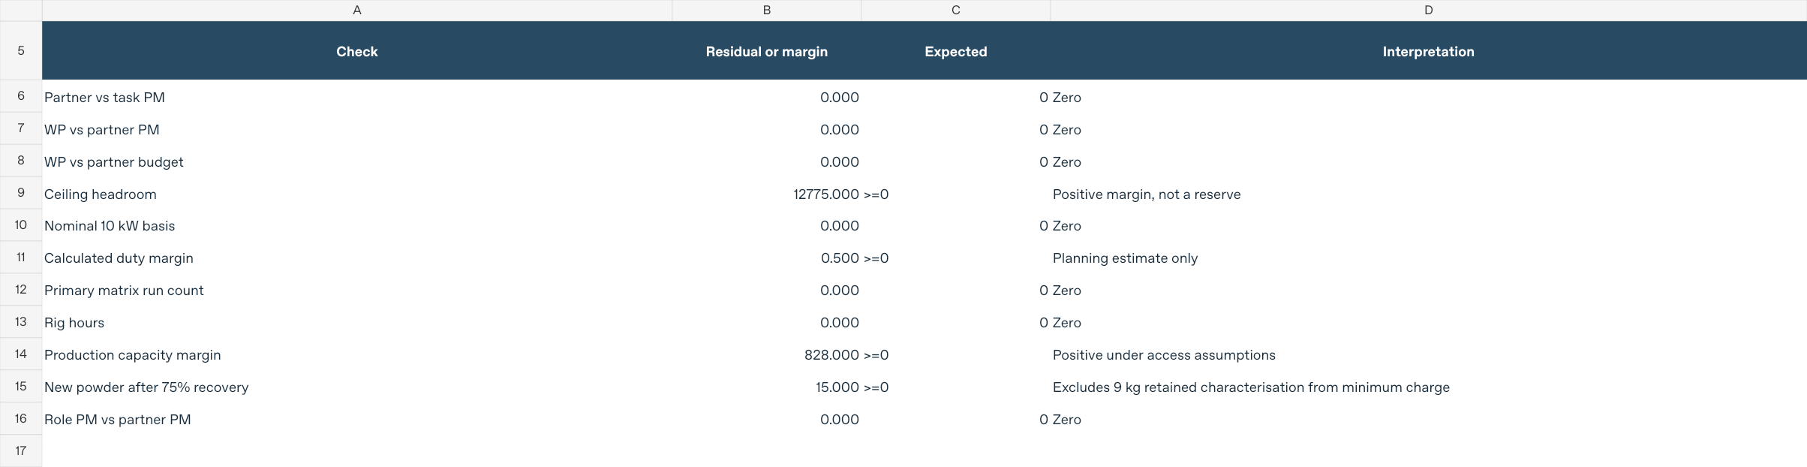
mat-prod/QA/Layout/Excel_Checks.png
