fredshuc/buildfly/mat-prod/QA/Layout/Excel_Monthly_FTE.png

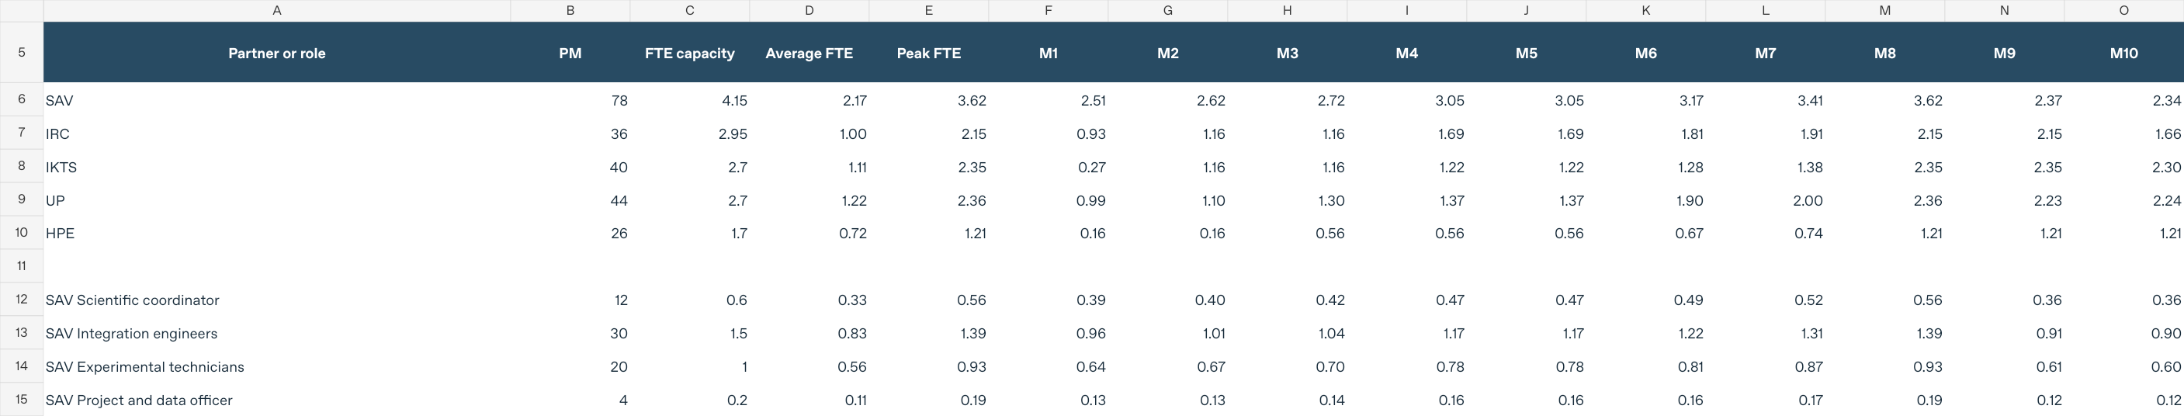
mat-prod/QA/Layout/Excel_Monthly_FTE.png
