fredshuc/buildfly/mat-prod/QA/Layout/Excel_Schedule.png

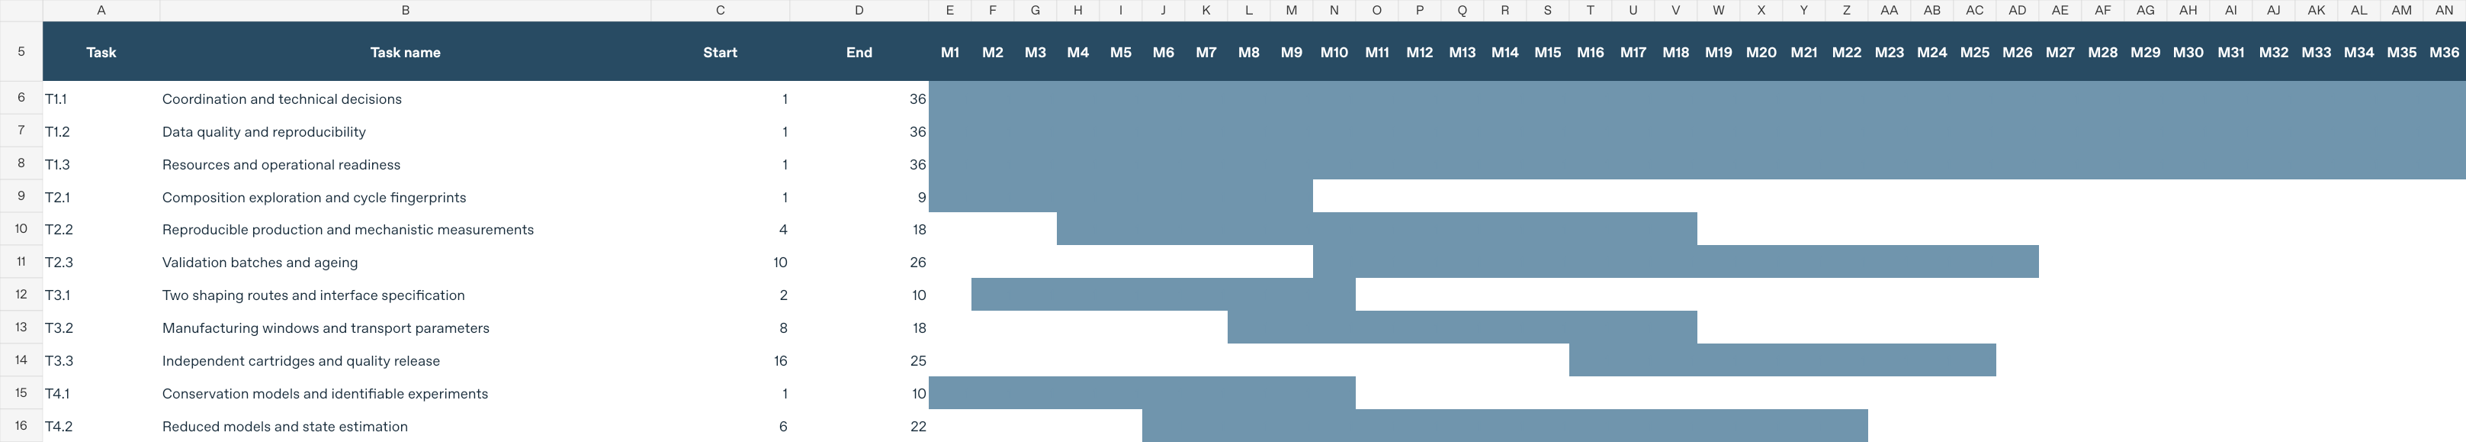
mat-prod/QA/Layout/Excel_Schedule.png
