fredshuc/buildfly/mat-prod/QA/Layout/Excel_Sensitivity.png

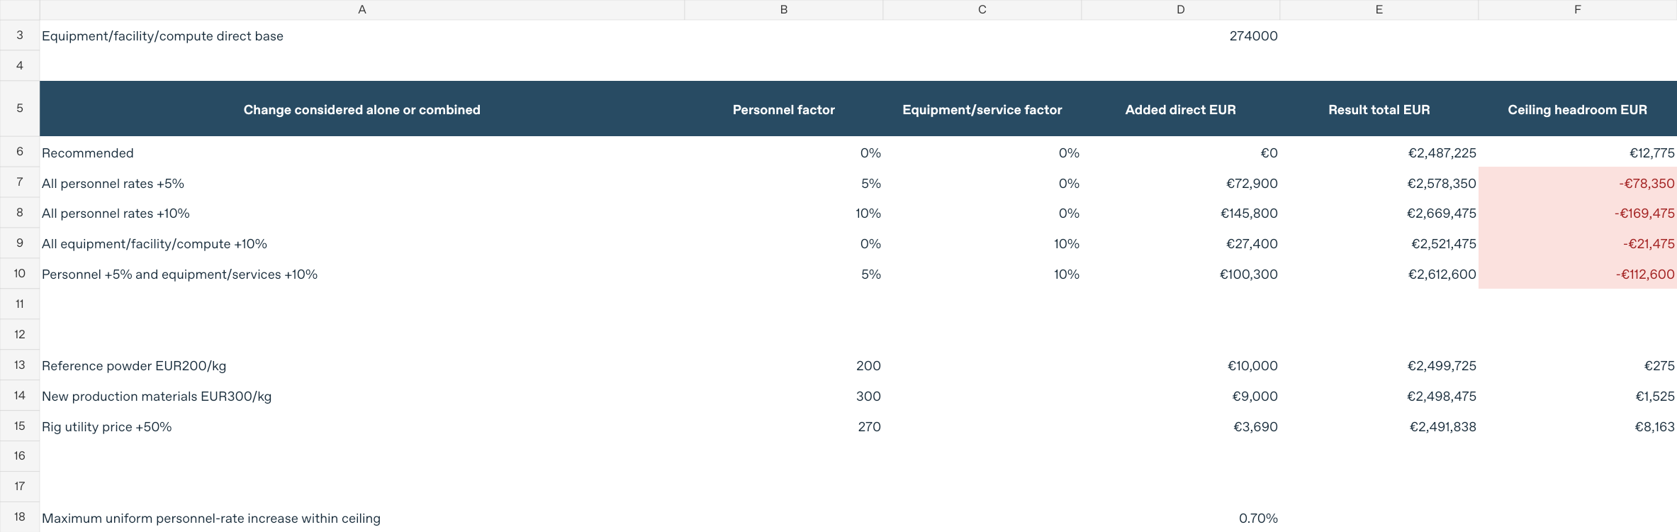
mat-prod/QA/Layout/Excel_Sensitivity.png
