fredshuc/buildfly/mat-prod/QA/Layout/Excel_Summary_budget.png

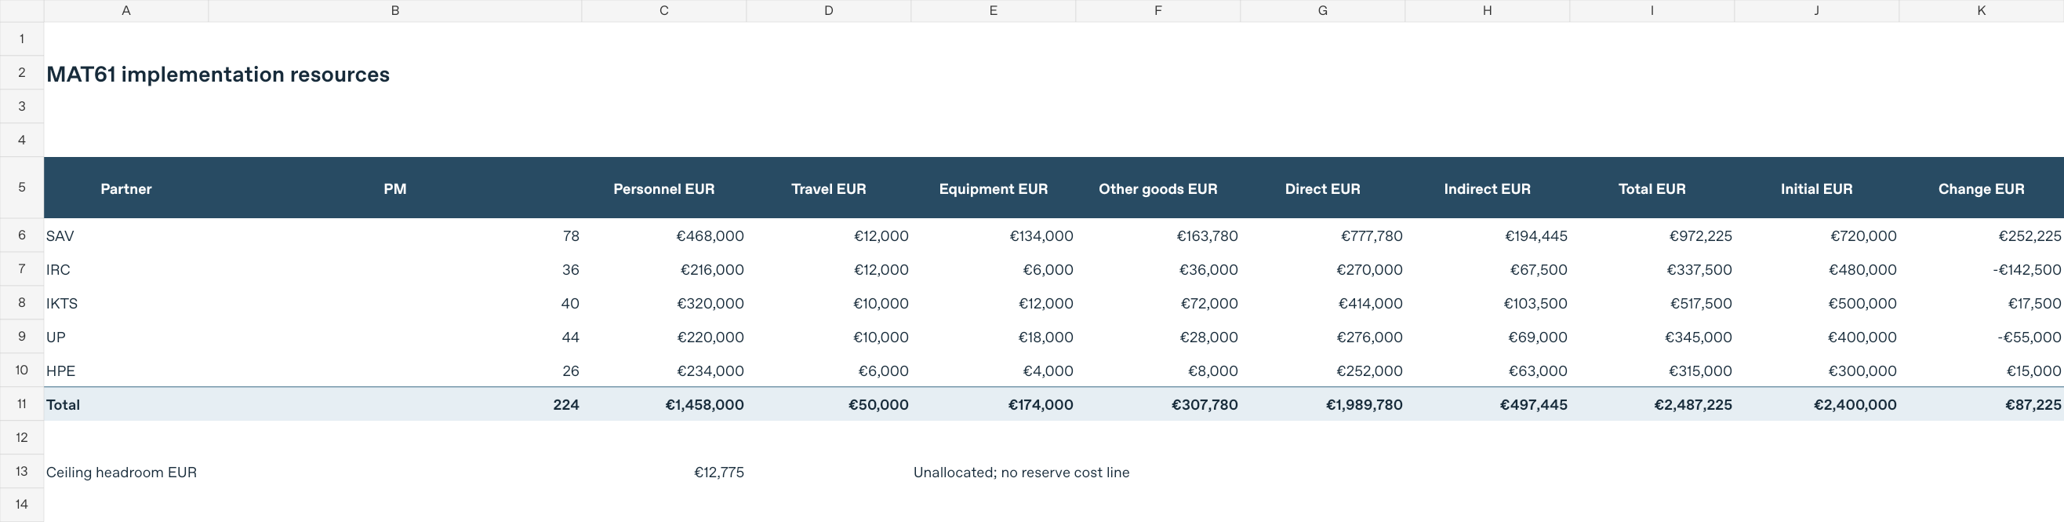
mat-prod/QA/Layout/Excel_Summary_budget.png
