fredshuc/buildfly/mat-prod/QA/Layout/Excel_Summary_sizing.png

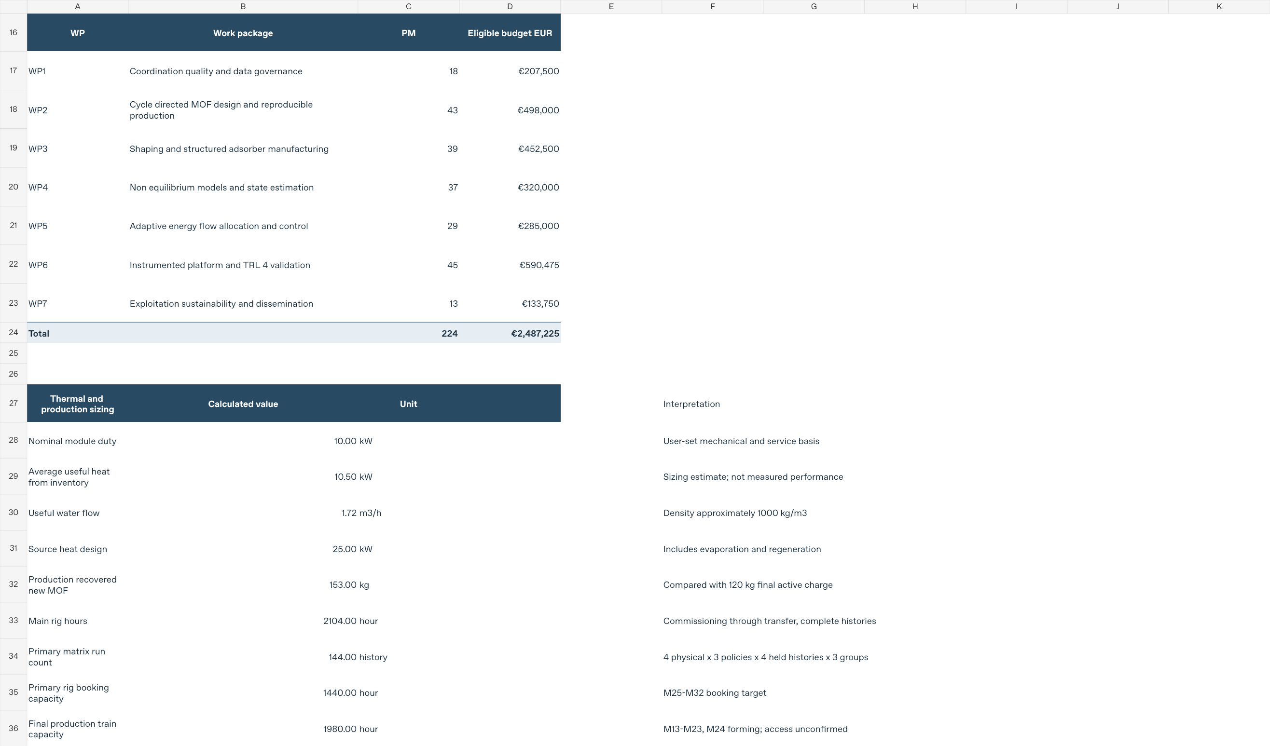
mat-prod/QA/Layout/Excel_Summary_sizing.png
