fredshuc/buildfly/mat-prod/QA/Layout/Excel_Tasks.png

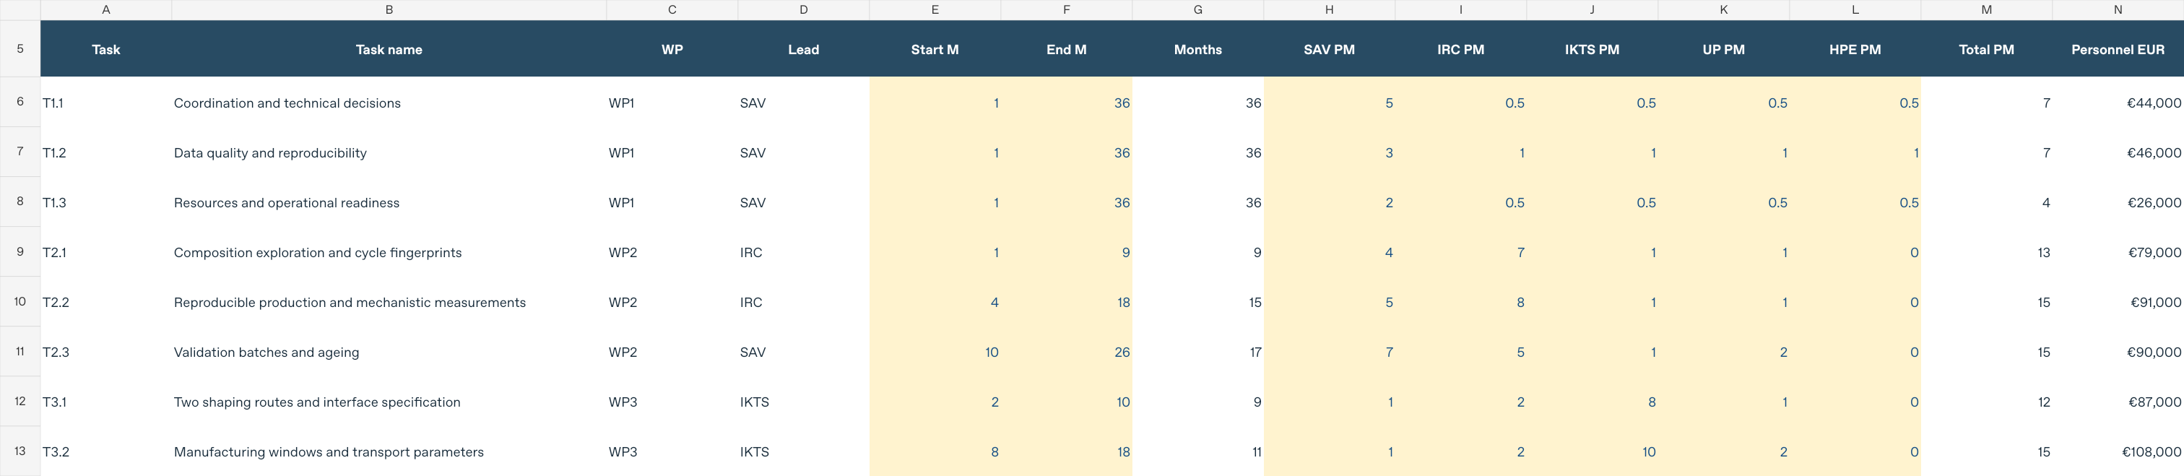
mat-prod/QA/Layout/Excel_Tasks.png
