fredshuc/buildfly/mat-prod/QA/Layout/Excel_Workload.png

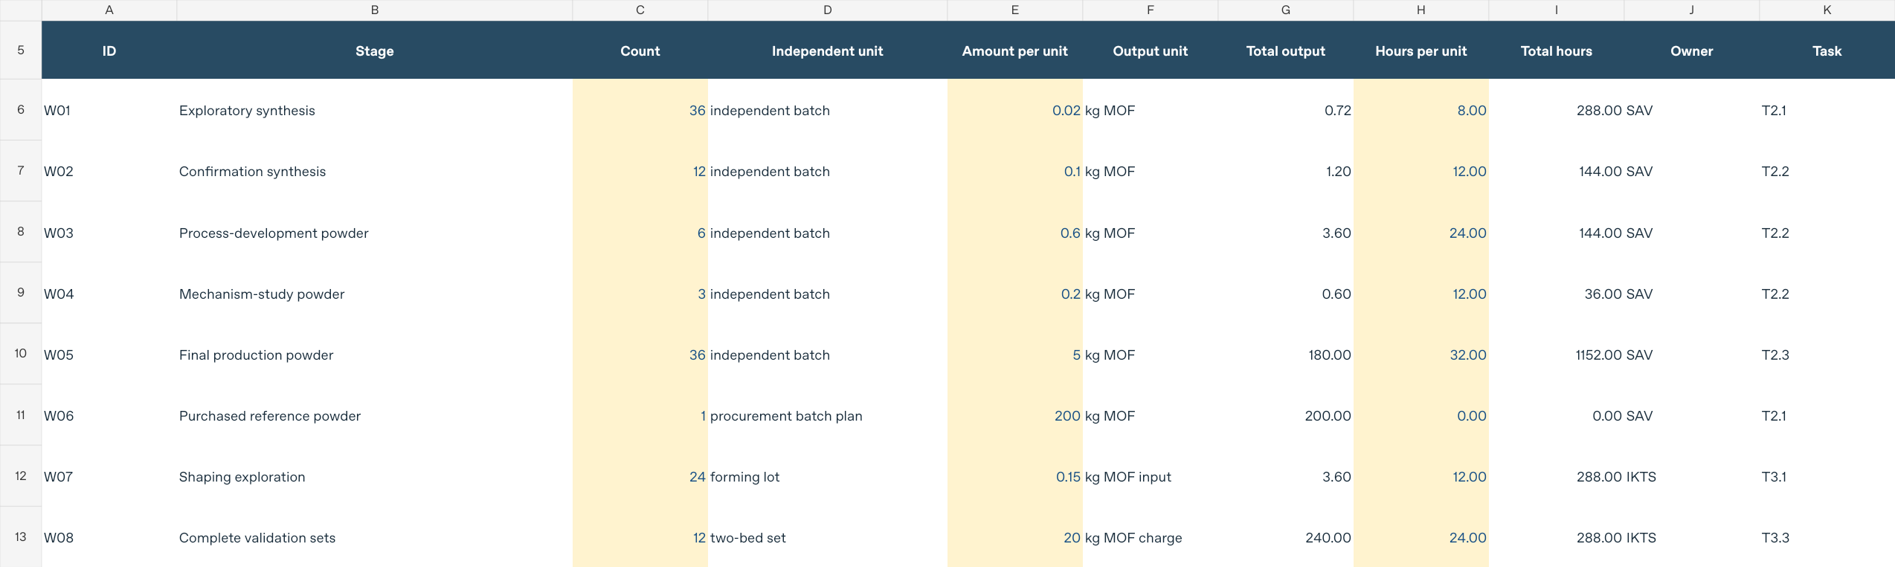
mat-prod/QA/Layout/Excel_Workload.png
