fredshuc/buildfly/mat-prod/QA/Layout/Word_contact-1.png

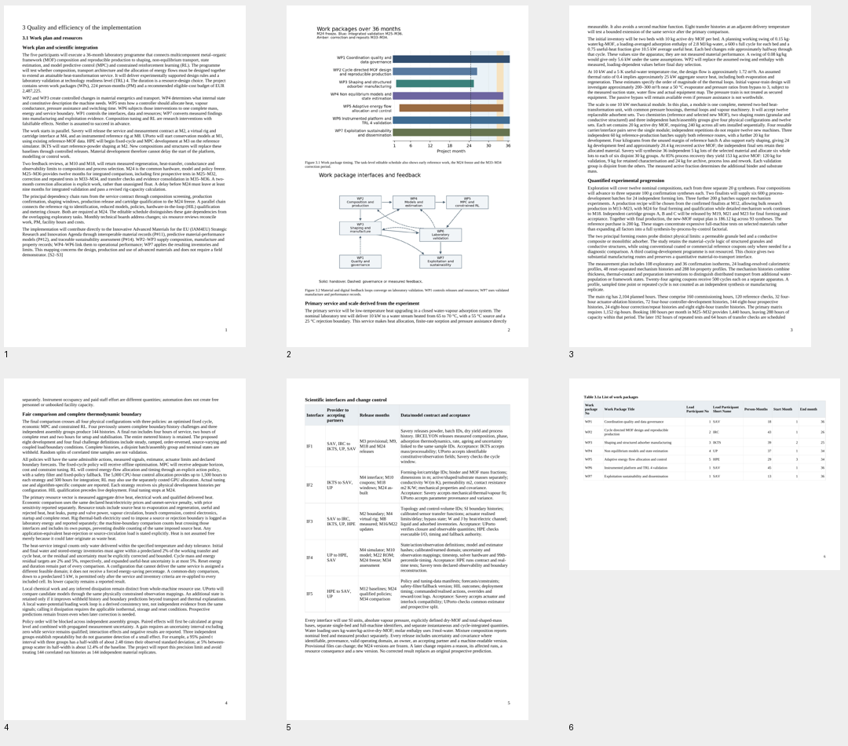
mat-prod/QA/Layout/Word_contact-1.png
