fredshuc/buildfly/mat-prod/QA/Layout/Word_contact-2.png

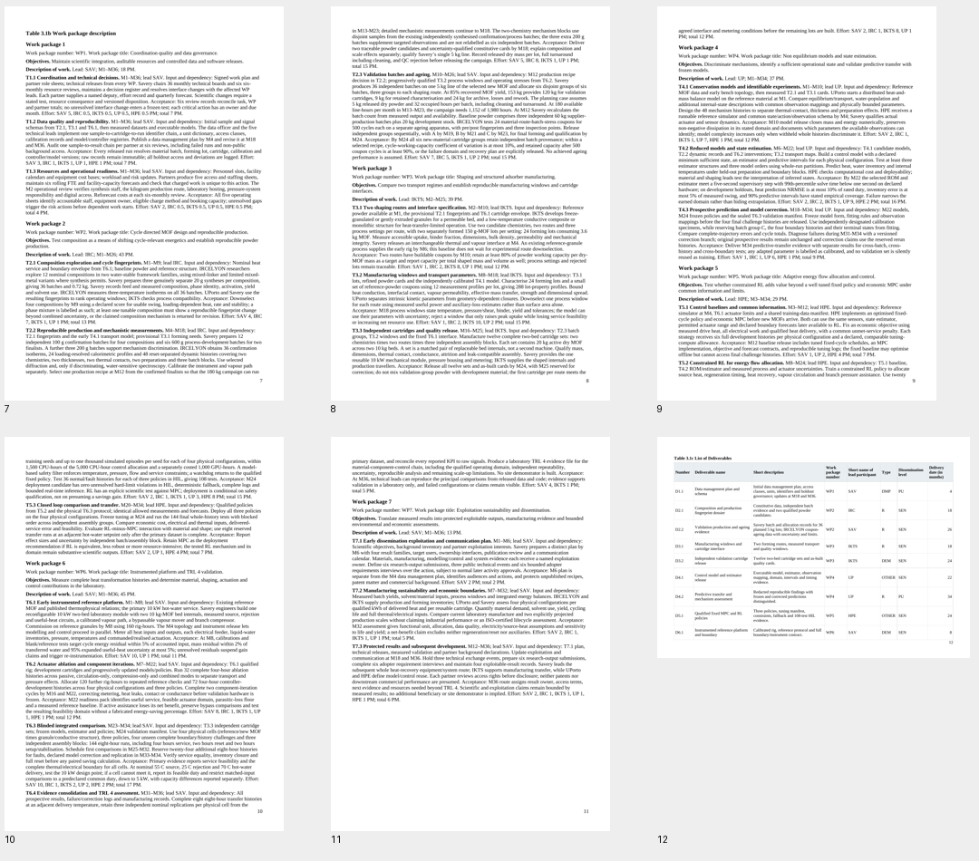
mat-prod/QA/Layout/Word_contact-2.png
