fredshuc/buildfly/mat-prod/QA/Layout/Word_contact-3.png

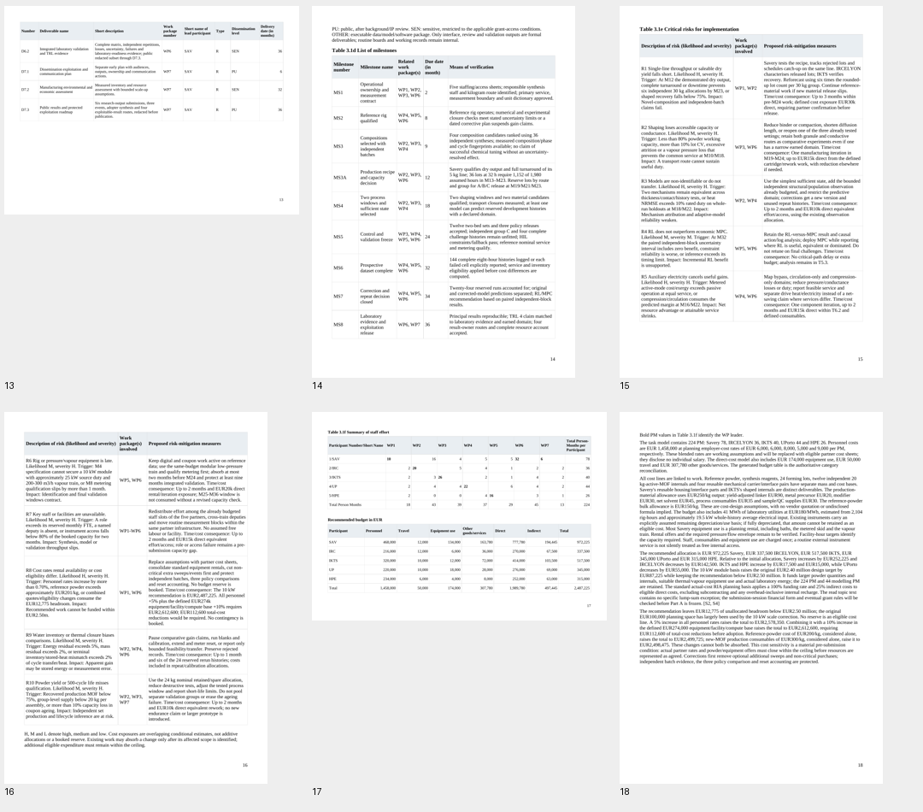
mat-prod/QA/Layout/Word_contact-3.png
