fredshuc/buildfly/mat-prod/QA/Layout/Word_contact-4.png

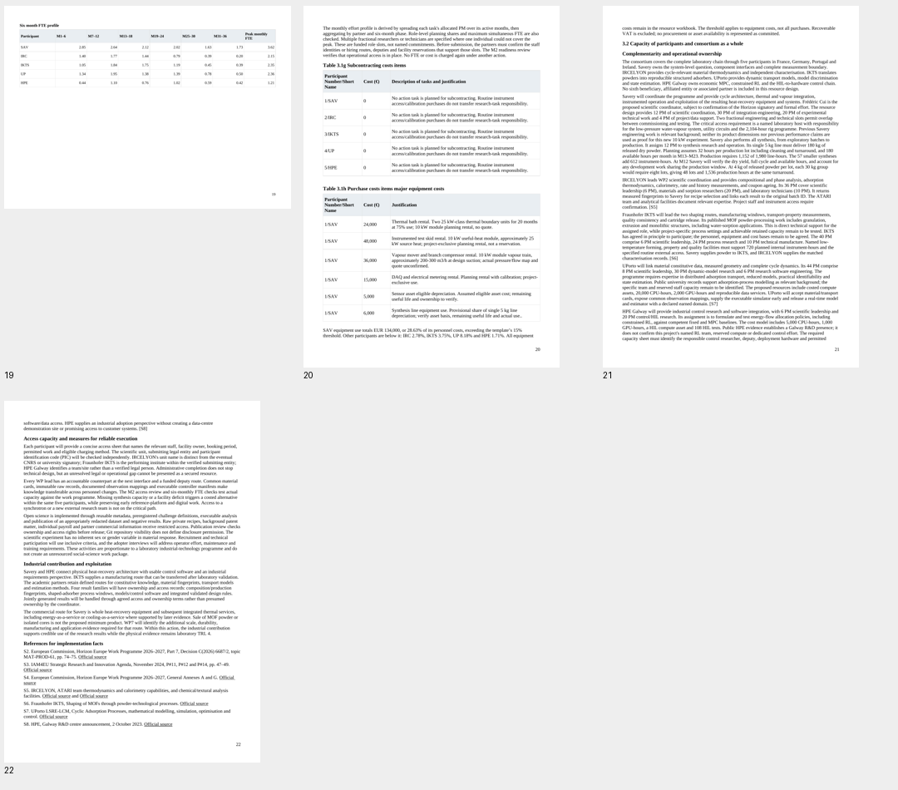
mat-prod/QA/Layout/Word_contact-4.png
