fredshuc/buildfly/AirTransformerShell/revisions/C07/static_taps.csv

bed | face | band_index | probe_x_mm | probe_y_mm | probe_z_mm
A | F | 2 | 261 | -135.39999999999998 | 1516.5
A | F | 5 | 261 | -135.39999999999998 | 1891.5
A | R | 2 | 489 | -135.39999999999998 | 1516.5
A | R | 5 | 489 | -135.39999999999998 | 1891.5
B | F | 2 | 261 | 546.6 | 1516.5
B | F | 5 | 261 | 546.6 | 1891.5
B | R | 2 | 489 | 546.6 | 1516.5
B | R | 5 | 489 | 546.6 | 1891.5
