fredshuc/buildfly/AirTransformerShell/revisions/C07/traps.csv

bed | source | x_mm | y_mm | coupling_z_mm | low_axis_z_mm | outlet_axis_z_mm | clear_seal_mm
A | HX | 375 | -196.39999999999998 | 74 | -151 | -43 | 90
A | F | 55 | -149.39999999999998 | 74 | -151 | -43 | 90
A | R | 695 | -149.39999999999998 | 74 | -151 | -43 | 90
B | HX | 375 | 1083.6 | 74 | -151 | -43 | 90
B | F | 55 | 1130.6 | 74 | -151 | -43 | 90
B | R | 695 | 1130.6 | 74 | -151 | -43 | 90
