fredshuc/buildfly/mat-prod/CHANGELOG.md

# Change log

## 2026-11-06 — Workspace initialization

- Created the mat-prod/ workspace for HORIZON-CL4-2027-01-MAT-PROD-61.
- Imported the official Part B RTF from the user-provided templates (2).zip without modification.
- Added template hashes, directory map and persistent instructions for subsequent work.

## 2026-11-06 — Controlled L2 implementation candidate

- Designed seven WPs and 22 quantified tasks for the fixed five-participant consortium, preserving HESTIA/GRACE/FY2027 scientific interfaces.
- Applied the user's 10 kW single-module basis to powder quantities, independent adsorbent sets, equipment and whole-history validation.
- Created English Section 3, same-source Word/PDF, a formula resource workbook, CSV snapshots, editable schedule/dependency graphics and source/assumption records.
- Recommended 224 PM and EUR2,487,225 over 36 months, with explicit production/access/cost sensitivity.
- Completed design consistency checks, workbook input propagation checks, layout review and one L2 self-review. Full payload remains controlled; remote write attempts failed with missing native credentials and connector HTTP403.

## 2026-11-06 · R2 synthesis assignment

Savery owns all synthesis on one 5 kg line. Resource modelling transfers 12 PM and attributable synthesis costs. Production now uses 36 planned independent lots. The 22-page Section 3 and workbook were regenerated and 148 QA checks passed.
