fredshuc/buildfly/AirTransformerShell/revisions/C07/tie_rods.csv

bed | index | global_y_mm | global_z_mm | diameter_mm | length_mm
A | 0 | -789.4 | 1235 | 8 | 294
A | 1 | -789.4 | 1547 | 8 | 294
A | 2 | -789.4 | 1859 | 8 | 294
A | 3 | -789.4 | 2173 | 8 | 294
A | 4 | -42.39999999999998 | 1235 | 8 | 294
A | 5 | -42.39999999999998 | 1547 | 8 | 294
A | 6 | -42.39999999999998 | 1859 | 8 | 294
A | 7 | -42.39999999999998 | 2173 | 8 | 294
A | 8 | -614.4 | 1140 | 8 | 294
A | 9 | -614.4 | 2268 | 8 | 294
A | 10 | -434.4 | 1140 | 8 | 294
A | 11 | -434.4 | 2268 | 8 | 294
A | 12 | -254.39999999999998 | 1140 | 8 | 294
A | 13 | -254.39999999999998 | 2268 | 8 | 294
B | 0 | 490.6 | 1235 | 8 | 294
B | 1 | 490.6 | 1547 | 8 | 294
B | 2 | 490.6 | 1859 | 8 | 294
B | 3 | 490.6 | 2173 | 8 | 294
B | 4 | 1237.6 | 1235 | 8 | 294
B | 5 | 1237.6 | 1547 | 8 | 294
B | 6 | 1237.6 | 1859 | 8 | 294
B | 7 | 1237.6 | 2173 | 8 | 294
B | 8 | 665.6 | 1140 | 8 | 294
B | 9 | 665.6 | 2268 | 8 | 294
B | 10 | 845.6 | 1140 | 8 | 294
B | 11 | 845.6 | 2268 | 8 | 294
B | 12 | 1025.6 | 1140 | 8 | 294
B | 13 | 1025.6 | 2268 | 8 | 294
