fredshuc/buildfly/(commit log)

2026-10-12 Add DFM review of C02 R11 damper with reproducible checks
    Independent DFM review of the AT-DMP02 C02 R11 red-team pack:
    - DFM_REVIEW.md: ranked findings, A/B detail, manufacturing-acceleration
    plan with experiments, acceptance criteria and decision gates
    - RT_FINDINGS.csv: responses to RT-01..RT-18
    - tools/: OCP-only native loader, A-root geometry checks, re-implemented
    B equaliser control model with parameter sweeps, closed-form screens,
    BOM routing and native-delta audit; run_all.sh reproduces results/
    byte-for-byte from the pack zip (pack itself not committed)
    Claude-Session: https://claude.ai/code/session_01Nh4aeFXZ8TYzCTYd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
    [RT_FINDINGS.csv, results_bom_routing.csv]
2026-10-12 Add RT-1 review of C02 R16 integration with verified ECO checks
    Independent RT-1 review of the R16 full-integration package:
    - RT1_REVIEW.md: answers to the eight RT-1 questions with exact
    PN/instance, counterexample, smallest change and acceptance evidence
    - Verified smallest fixes on released parts: D886 re-phase on P2
    (0 overlap over 0..90 deg, TF900 unchanged); G901/TF909 relocation
    -45.5 mm (0 wet hits at 0/45/90 deg)
    - P orientation / wet-support decision with masses and CG; proposed
    release waves for the P1 kit (41 stable wet-valve PN unchanged R11->R16)
    - tools/ and results/ reproduce byte-for-byte from the package zip
    - Applies L1's corrections to the earlier R11 review
    Co-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
    [RT1_FINDINGS.csv, results_r16_release_waves.csv]
2026-10-13 Add RT-2 independent review of AT-DMP02 C02 R21
    Review of the R21 manufacturing master and P/R cold-test configurations,
    focused on accelerating manufacture:
    - Verify RT-1 adoptions: 0 motion overlaps at 41 positions; 213 static
    overlaps are all thread engagements.
    - BOM audit closes on every row; 1,141 of 1,301 small-hardware pieces map
    to standard designations, and 9 rows need a decision.
    - Answers to RT2-01..10 with smallest changes:
    - RT2-03: between-centres rotor support (the cradle band sits on the BK2
    h7 grip).
    - RT2-06: 0.8 mm film-end keeper plus +2 mm end screws to keep 2 pitches
    of protrusion.
    - RT2-04: stop/G1 evidence set and D886 contact crown.
    - RT2-07: fe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
    [RT2_FINDINGS.csv, results_r21_fastener_map.csv]
2026-11-05 Add M101 C04 vertical heat exchanger CAD and interfaces
    [INTERFACES.csv, M101_D952_P254_220_39x6_C04.step, M101_D952_P254_220_39x6_C04_TWO_CORES.step]
2026-11-05 Fit two-tier ducts to vertical HX faces
2026-11-05 Add RT-1 red-team review of shell C04 two-bed module
    Independent review of the simplified one-stage, two-HX C04 module per
    RED_TEAM_HANDOFF_EN.md. Reproduces the C04 flow scripts and CAD build,
    installs the detailed M101 C04 HX at both bays, measures R21 damper
    extents against the C04 interfaces, audits the water valve references,
    and screens air distribution, losses and structure from first principles.
    Dispositions: shell revise; HX accept with conditions; dampers revise
    for two beds; water changeover revise; cold-flow build accepted with
    named conditions for a single-bed article. Review only, no change to
    delivered files.
    Claude-Ses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
    [C04_RT1_FINDINGS.csv]
2026-11-05 Integrate D01 at 1280 mm pitch with M101 and the R1 water bay
2026-11-05 Add two-bed hydronics R1 owner package
2026-11-05 Add D01 eight-damper CAD review package
2026-11-05 Add RT-2 red-team review of shell C06
    Independent review of the C06 coupled geometry (D01 dampers at 1280 mm
    pitch, M101 RT1 port alignment, HYD-R1 water bay). Reproduces
    build_c06.py, integrate.py and verify_motion.py exactly, records the
    closure status of every RT-1 finding, and adds CAD-verified checks of
    HX withdrawal, seal-carrier clamping and reaction path, seal-interface
    clearances, cheek slot ligaments, drains and damper support.
    Disposition: return narrowly for five geometry items (N1-N5), accept
    the rest for prototype detailing; two-bed manufacture stays on hold.
    Review only, no change to delivered files.
    Claude-Session: htt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
    [C06_RT2_FINDINGS.csv]
2026-11-05 Import D02 independent damper supports for the two-bed machine
2026-11-05 Import M101 C05 exchanger CAD, captive tray and port signoff
2026-11-05 Import L2-E R2 water-bay package and four-port function register
    [PORT_FUNCTION_REGISTER.csv]
2026-11-05 Integrate C07 two-bed shell, verified service geometry and independent RT3 review
    [machine_readback.json, static_taps.csv, tie_rods.csv, traps.csv]
2026-11-06 Archive four-core outdoor sheet metal for red-team reference
    [V050_SM_M2_IN1_R1_OUTDOOR_SHEET_METAL_ONLY.stp]
2026-11-06 Design MAT61 Section 3 at 10 kW with reconciled work plan and resources
    [Assumptions.csv, Budget.csv, Capacity_and_Legal_Entity_Status.csv, Conditions.csv, Costs.csv, Critical_Path.csv, Deliverables.csv, Dependencies.csv]
2026-11-06 Assign MOF synthesis to Savery and size one 5 kg production line
    [Assumptions.csv, Budget.csv, Capacity_and_Legal_Entity_Status.csv, Costs.csv, Deliverables.csv, Facilities.csv, Implementation_Resources.xlsx, Interfaces.csv]
2026-11-07 Publish MAT61 Sections 1–3 for red-team review
